TheKingOfChaos/RF-Power-Monitor/docs/diagrams/README.md

# Diagrams

Excalidraw diagrams of the project. Each `.excalidraw` file opens and edits at [excalidraw.com](https://excalidraw.com) (Open, or drag the file in) or in VS Code with the Excalidraw extension; the `.svg` next to it is the exported picture used in the docs.

| Diagram | Shows | Used in |
|---|---|---|
| [system-overview](system-overview.svg) | Mains side, board (Pico, W5500, TMP1075, flash, button, LED), PC, and the network: DHCP (options 7, 42, 224, 225), browser, SNMP manager, trap receiver, NTP, syslog and update site | README, setup manual |
| [firmware-architecture](firmware-architecture.svg) | Each part of `src/` over the `lib/` libraries it uses (pure and hardware layers), the boot program, the Arduino-Pico core | DEVELOPMENT.md, project structure |
| [snmp-request-flow](snmp-request-flow.svg) | Size check, rate limiter, parsing, version and community checks, MIB (250 objects + address rows), response, auth-failure trap, access log and syslog | MIB.md |
| [mains-flow](mains-flow.svg) | GPIO27 sampling and debouncing on core 1, seqlock, status/SNMP/traps/syslog on core 0, LibreNMS and the syslog server; the reset button path | REFERENCE.md, mains monitoring; user manual |
| [settings-storage](settings-storage.svg) | Saving to the A/B slots and choosing a copy at boot; the update and time/syslog files use the same scheme | REFERENCE.md, settings storage |
| [test-layers](test-layers.svg) | Native, sanitizer, net-snmp, on-device, HIL (incl. NTP, syslog, DHCPv6), mains and LibreNMS tests, and what CI runs | docs/TESTING.md |
| [web-request-flow](web-request-flow.svg) | Web page: request reading, login and lockout, sessions, CSRF check, validation, save (incl. /timelog, /updateserver, /firmware/switch) | user manual, web page |
| [network-addresses](network-addresses.svg) | Where the IPv4 and IPv6 addresses, the IPv6 gateway, the trap destination, the NTP server and the syslog server come from | REFERENCE.md, IPv6 |
| [update-site-flow](update-site-flow.svg) | Check-ins with the update site, the reply MAC, a failed check-in (syslog, SNMP updateSite), the download, the checks before writing, trial and reporting | user manual, update-server/README.md |
| [firmware-update-boot](firmware-update-boot.svg) | Flash layout (boot program, boot record, slots A and B, LittleFS, EEPROM) and the boot decision: signature check, trial, crash limit, fallback, rollback, nothing bootable | REFERENCE.md, firmware update; user manual, updating |
| [time-syslog-flow](time-syslog-flow.svg) | NTP server to the clock; events through the throttle and the queue of 16, waiting for network, server and time, dated or undated, RFC 5424 to the syslog server | REFERENCE.md, time and syslog |
| [librenms-integration](librenms-integration.svg) | SNMP polls, traps through snmptrapd, syslog through the syslog-ng sidecar, what LibreNMS shows, alert rules | LIBRENMS.md |
| [bench-setup](bench-setup.svg) | `tools/bench_provision.py`: signature check, BOOTSEL flash, benchinfo, checks, pwlock, update server default, label and log; `--no-flash`, `--reprint` | SETUP_MANUAL.md, bench setup |
| [cores-watchdog](cores-watchdog.svg) | What core 0 and core 1 run, their stacks, the shared snapshot, flag and heartbeat, the 8 s watchdog and what a restart does | REFERENCE.md, watchdog |

## Changing a diagram

The `.excalidraw` files are generated by [make_diagrams.py](make_diagrams.py), which places the boxes and binds the arrows to them. Either edit the script and regenerate, or edit a file in Excalidraw; regenerating overwrites hand edits, so pick one.

Layout rules, checked when the script runs (it prints a warning for each break): arrows run straight or in orthogonal steps through the gaps between boxes, never along a box edge or zone border and never through a box or a text; no segment is shorter than 30 px; an arrow's label is free text beside its segment (above a horizontal one, right of a vertical one), grouped with the arrow, so no line or arrowhead crosses it.

```powershell
python docs/diagrams/make_diagrams.py                 # .excalidraw files
wsl -d Ubuntu-24.04 -- bash docs/diagrams/render_svg.sh   # .svg files (needs Docker and internet)
# Without Docker inside WSL: run the docker command from render_svg.sh on Windows, with docs/diagrams mounted at /diagrams
```

`render_svg.sh` runs [render.mjs](render.mjs) in the Playwright Docker image: headless Chromium loads Excalidraw 0.17.6 and exports each file with Excalidraw's own `exportToSvg`, then the hand-drawn Virgil font is embedded so the SVGs look the same on GitHub. After editing a diagram in Excalidraw, run only `render_svg.sh`, or export the SVG from Excalidraw yourself (Export image → SVG, with "Embed scene" off).
