TheKingOfChaos/RF-Power-Monitor/hardware/rf-power-monitor-rev2/design/brief.md

# Brief (2026-11-02)

User, exact words:
> can we build a rev2 of the board where all of wiznet module exept the poe module are on the carry board

Answers to the intake questions:
- Tooling: Adom AI Flow
- Layers: "2 if you can and you are allow to change the board design and size"
- Outline: free outline, new case later
- Assembly: JLCPCB PCBA

Rev1: hardware/pico-poe-mains-carrier (carrier for the WIZnet W5500-EVB-Pico-PoE module).
