TheKingOfChaos/RF-Power-Monitor/docs/LIBRENMS.md

# LibreNMS

The device works in LibreNMS as a plain SNMP device out of the box: it answers SNMPv2c, has the system group and the standard IF-MIB, so LibreNMS discovers it, graphs the Ethernet port's traffic and shows its uptime. To also get the mains power state and the CPU and ambient temperature as sensors, and the device recognised as an RF-Power-Monitor with the RF logo, add the definitions in [librenms/](../librenms/) to your LibreNMS installation.

> **Status:** tested with LibreNMS 26.9.1 (Docker, [librenms/test/compose.yml](../librenms/test/compose.yml)) against the real device running firmware 1.0.1: OS, version and hardware detected, all three sensors created with the right values and limits, the port polled with traffic rates, and a mains trap logged. The RF logo as device icon and device page logo was checked with LibreNMS (Docker, `latest`) on 2026-10-31 against the device. The definition files also validate against LibreNMS's JSON schemas. Re-checked on 2026-11-01 after the rename (3.0.0 definitions, Pico with the renamed firmware): detected as RF-Power-Monitor (`rfpowermonitor`) with version and hardware, all five sensors, the LLDP neighbour, an authenticationFailure trap in the event log, and snmptrapd resolving the `RF-POWER-MONITOR-MIB` trap names. Re-checked on 2026-11-07 with firmware 3.6.0: the two update-site sensors discovered (warning limit 60 minutes), and the device's syslog messages stored under the device through the syslog-ng sidecar on UDP 5140.

## What you get

How LibreNMS sees the device: SNMP polls every 5 minutes, traps through the snmptrapd sidecar, syslog through the syslog-ng sidecar, sensors and alert rules

| In LibreNMS | From |
|---|---|
| OS "RF-Power-Monitor", type power, version (e.g. `3.6.0`) and hardware (`RP2040, W5500`) | sysObjectID `1.3.6.1.4.1.63050`, sysDescr |
| Port `eth0` with traffic, packets, speed and status | IF-MIB (64-bit counters over v2c) |
| State sensor "Mains power": present (OK) / lost (warning) | `mainsPowerStatus` |
| State sensor "Mains lost over 60 s": none (OK) / lostTooLong (critical) | `mainsPowerAlarm` (firmware after 2.5.1) |
| Temperature sensor "CPU (RP2040 die)", warning at 60 °C, critical at 70 °C, low limit −20 °C | `cpuTemperature` / 10 |
| Temperature sensor "Ambient (TMP1075)", warning at 40 °C, critical at 50 °C, low limit −20 °C; only with the carrier board | `ambientTemperature` / 10 |
| Count sensor "Mains power changes since boot" | `mainsPowerChanges` |
| State sensor "Firmware": normal (OK, fwState kept) / trial (warning) | `fwState` (`fwUpdate` group, `63050.7`, firmware 3.3.0) |
| State sensor "Firmware last update": none, installed (OK); rolled back or fallback (critical, alerts) | `fwLastResult` (3.3.0) |
| State sensor "Update site check-in": off, never, ok, failed (shown only, no alert) | `updCheckinResult` (`updateSite` group, `63050.8`, firmware 3.6.0) |
| Count sensor "Minutes since update site check-in", warning above 60 | `updMinutesSinceGood` (3.6.0) |
| Uptime, reboot detection | sysUpTime |
| Neighbours tab: the switch and port the device is plugged into | LLDP-MIB `lldpRemTable` (firmware 2.7.0) |
| Location and contact on the device page (and the map, once the location has coordinates) | sysLocation, sysContact: set on the device's web page or menu option 4 |
| Processors: "RP2040 core 0 (network, SNMP)" and "RP2040 core 1 (mains input)", load per core | HOST-RESOURCES-MIB `hrProcessorLoad` (firmware 3.1.0) |
| Memory "RAM" (256 KB) | HOST-RESOURCES-MIB `hrStorageTable`, hrStorageRam (3.1.0) |
| Storage "LittleFS (settings)" (256 KB) | HOST-RESOURCES-MIB `hrStorageTable`, hrStorageFlashMemory (3.1.0) |
| IPv4 and IPv6 addresses on `eth0` | IP-MIB `ipAddrTable`, `ipAddressTable` (3.1.0) |
| Inventory: model, hardware and firmware revision, manufacturer, serial number; the serial also on the Overview | ENTITY-MIB `entPhysicalTable` (3.1.0), `serial` in the discovery definition |
| Netstats graphs: IP, ICMP, TCP, UDP, SNMP | MIB-II ip/icmp/tcp/udp groups (lwIP's counters), SNMPv2-MIB snmp group (3.1.0) |
| Overview graphs: CPU and Memory next to traffic, mains and temperature | `over:` in the detection definition |
| The device's syslog messages under Logs → Syslog | Syslog from the device (firmware 3.6.0, see [Syslog](#syslog)) |

The temperature sensors set their low limit explicitly to −20 °C (the RP2040's minimum rating): without it LibreNMS sets a low limit 10 °C below the first reading (29.4 °C in the test), which alarms as soon as the room cools down. The CPU sensor keeps the index `boardTemperature.0` from before the MIB object was renamed `cpuTemperature`, so an existing installation keeps its graph after updating the definitions; replace the MIB file in LibreNMS together with the YAML files. The ambient limits suit a room with equipment; change them per device in LibreNMS if the box sits somewhere warmer.

**Alerts for outages longer than 60 s.** A mains loss turns "Mains power" yellow (warning, generic state 1), which no rule in LibreNMS's collection alerts on, so short outages stay out of the alert log. Once mains has been gone for 60 s without a break, the device sets `mainsPowerAlarm` and "Mains lost over 60 s" turns critical (generic state 2). To be alerted, add the "State Sensor Critical" rule from LibreNMS's rule collection (Alerts → Alert Rules → Create rule from collection); a fresh installation has no alert rules. The alert recovers when mains returns.

The 60 s is decided on the device, not with the rule's delay: LibreNMS creates the alert, and its entry in the alert log, at the poll that sees the sensor critical, and the rule's delay only holds back notifications (e-mail and other transports). It also only checks rules when it polls, and the device's mains state alone does not say how long mains has been gone.

Polling runs every 5 minutes by default, so without traps the alert comes at the first poll after the 60 s; a short outage between two polls still shows up as a step in "Mains power changes". For the alert about 60 s after mains goes, send the device's traps to LibreNMS's snmptrapd and let a mains trap poll the device (below).

Tested on 2026-11-01 with LibreNMS (Docker, `latest`) and the firmware with `mainsPowerAlarm`, cutting mains with a smart outlet: a 33 s outage logged mainsPowerLost and mainsPowerRestored and no alert; outages of 76 s and 95 s each logged mainsPowerLostTooLong 60 s after the loss, the alert opened 2 s after that trap and recovered 2 s after mains returned.

**Updating from an older definition:** copy the YAML files and the MIB again, rediscover the device (device → Settings → Rediscover, or `./lnms device:discover <device ip> -m sensors`) so the new sensor is created and "lost" becomes a warning, and restart snmptrapd so it knows the new trap's name. Until then it logs the trap by its parent's name, `RF-UPS-MONITOR-MIB::rfUpsMonitorNotifications.3` with a 2.5 MIB (the module's name before 3.0.0).

**Updating to 3.0.0 (the project renamed RF-Power-Monitor):** the definition is now `rfpowermonitor` and the MIB `RF-POWER-MONITOR-MIB`. Remove the old files first, or two definitions match the device and detection may keep the old one:

```bash
cd /opt/librenms
rm resources/definitions/os_detection/rfupsmonitor.yaml resources/definitions/os_discovery/rfupsmonitor.yaml
rm -r mibs/rfupsmonitor
rm html/images/os/rfupsmonitor.svg html/images/logos/rfupsmonitor.svg
```

then copy the new files as under Install, rediscover the device (it becomes OS RF-Power-Monitor; its sensors are created again, so their history starts over) and restart snmptrapd so it loads the new MIB. Until the restart it names the traps `RF-UPS-MONITOR-MIB::...`; the trap script below accepts both names.

LibreNMS reads CPU, memory, storage, addresses and inventory through its generic modules (`processors`, `mempools`, `storage`, `ipv4-addresses`, `ipv6-addresses`, `entity-physical`, `netstats`), as it does for any device; only the overview graphs and the serial come from our definition files. They appear after the next discovery (every 6 hours) or at once with `./lnms device:discover <device>`.

The location follows sysLocation at every poll. Clearing it on the device does not clear it in LibreNMS (LibreNMS keeps the last one); set or remove it on the device's page in LibreNMS (Edit → Override sysLocation) if needed.

Checked 2026-11-02 with LibreNMS 26.10.2 (Docker) against firmware 3.1.0: both processors (0-1 % idle), memory RAM 52 %, storage LittleFS 32 of 256 KB, ipv4 10.132.0.58/22, ipv6 fe80:: and the ULA address (/64, origin linklayer), the inventory entry with serial, manufacturer and revisions, the serial on the device, RRD files for netstats ip/icmp/tcp/udp/snmp, and a location set on the device shown after the next poll. Hardware and version still come from sysDescr.

## Install

On the LibreNMS server, as the `librenms` user, with LibreNMS in `/opt/librenms`:

```bash
cd /opt/librenms
# OS detection and discovery
cp <this repo>/librenms/os_detection/rfpowermonitor.yaml resources/definitions/os_detection/
cp <this repo>/librenms/os_discovery/rfpowermonitor.yaml resources/definitions/os_discovery/
# MIB, in the directory named by mib_dir in the detection file
mkdir -p mibs/rfpowermonitor
cp <this repo>/mibs/RF-POWER-MONITOR-MIB.txt mibs/rfpowermonitor/RF-POWER-MONITOR-MIB
# RF logo: icon in device lists, logo on the device page
cp <this repo>/librenms/images/os/rfpowermonitor.svg html/images/os/
cp <this repo>/librenms/images/logos/rfpowermonitor.svg html/images/logos/
# Optional: "Switch" box on the device's Overview page (plugin, see Switch and port below)
cp -r <this repo>/librenms/plugins/RFPowerMonitor app/Plugins/
```

Then add the device with SNMP v2c and its community (menu option 4 on the device; change it from `public`):

```bash
./lnms device:add --v2c -c <community> <device ip>
```

or in the web interface: Devices → Add Device, SNMP version v2c. Use v2c, not v1: the 64-bit interface counters exist only in v2c.

If the device was added before the files were copied, rediscover it (device → Settings → Rediscover, or `./discovery.php -h <device ip>`) so it is detected as RF-Power-Monitor.

LibreNMS's daily update and `validate.php` may complain about these extra files, since they are not part of the LibreNMS repository. Keep a copy, and copy them again if an update removes them.

### IPv6

The device answers SNMP over IPv6 too (see [IPv6](REFERENCE.md#ipv6) in the reference). To poll it over IPv6, add it with the IPv6 transport:

```bash
./lnms device:add --v2c -c <community> -t udp6 <device IPv6 address>
```

or choose transport `udp6` in Devices → Add Device. Checked with LibreNMS 26.9.1 in the Docker setup below: added with `-t udp6`, the device was detected as the OS (then named RF-UPS-Monitor, before the 3.0.0 rename; not repeated since), and discovery and polling over IPv6 give the mains state, change counter, temperature and the `eth0` port. If LibreNMS already has the device by its IPv4 address, it refuses a second entry with the same sysName (`--force` skips that check). A static IPv6 address (serial menu option 9) gives the device an address that does not change with the router's prefix, which suits a monitoring system.

### Switch and port (LLDP)

Since 2.7.0 the device answers the standard LLDP-MIB (`lldpLocPortTable`, `lldpRemTable`, see [MIB.md](MIB.md)) with the switch it hears over LLDP. LibreNMS reads it in its `discovery-protocols` discovery module, as it does for every device, so the device's **Neighbours** tab (and the links on the network map) show the switch and port, even when the switch itself is not in LibreNMS. No LibreNMS change is needed. Run discovery once to see it at once, otherwise it comes with the next discovery (every 6 hours):

```bash
./lnms device:discover <device> -m discovery-protocols
```

With the plugin in `librenms/plugins/RFPowerMonitor` (copied to `app/Plugins/`, see Install) the device's **Overview** page also has a **Switch** box under the system box: the switch's name, its port, its system description and the device port LLDP was seen on, or "No switch seen" when discovery found none. It shows the same links as the Neighbours tab, so it changes at the same time, with each discovery. LibreNMS turns a newly copied plugin on by itself (Overview → Plugins → Plugin Admin lists it), and the box only appears on RF-Power-Monitor devices. Checked 2026-11-02 with LibreNMS 26.10.2.

Junos sends its port as a number (its ifIndex, e.g. `523`) and the name only as description; LibreNMS labels the remote port with the port ID, so the device serves the name (`ge-0/0/9.0`) instead, as on its status screen.

LibreNMS by default tries to add every LLDP/CDP neighbour it learns as a new device (`autodiscovery.xdp`). If you only want to see the switch on the device's page, turn that off:

```bash
./lnms config:set autodiscovery.xdp false
```

Checked 2026-11-01 with LibreNMS 26.9.1 in the Docker setup below (`autodiscovery.xdp` off): discovery logs `LLDP: 1 neighbors`, and the device's link is local port `eth0` → `r169`, port `ge-0/0/9.0` (a Juniper EX2200-C that is not in LibreNMS); no device was added.

## Traps

Set the device's trap destination (menu option 4) to the LibreNMS server and the trap version to `2c` (or enter `dhcp` and let the DHCP server hand out the LibreNMS address in option 224, see [MIB.md](MIB.md#trap-destination-from-dhcp)), and set up snmptrapd on the server as described in the LibreNMS documentation (SNMP Trap Handler). LibreNMS has no trap handler for the RF-POWER-MONITOR-MIB notifications, so it logs them as unhandled traps: the device's event log shows an entry of type `trap` with the message `RF-POWER-MONITOR-MIB::mainsPowerLost` (or `...Restored`, `...LostTooLong`), checked with LibreNMS 26.9.1. The sensors change on the next poll.

LibreNMS finds the device for a trap by the address the trap came from. If something between the device and snmptrapd rewrites that address (NAT, such as Docker Desktop's port forwarding), LibreNMS logs "Could not find device for trap" in snmptrapd's output and drops the trap; the Docker setup below works around that.

### Firmware update (3.3.0)

The `fwUpdate` group (`63050.7`, see [MIB.md](MIB.md)) describes the two firmware slots, and the discovery definition turns two of its objects into state sensors, which appear after the next discovery of a device on 3.3.0 or later (copy the YAML files and the MIB again first):

| Sensor | Object | States |
|---|---|---|
| Firmware | `fwState` (`63050.7.4`) | normal (OK: fwState `kept(1)`, the firmware is confirmed), trial (warning: a new firmware that has not answered a valid request yet) |
| Firmware last update | `fwLastResult` (`63050.7.5`) | none, installed (OK); rolledBackCrash, rolledBackUnreachable, fallbackCrash (critical: the *State Sensor Critical* rule alerts until the next successful update) |

The running slot (`fwRunningSlot`) and each slot's version (`fwSlotAVersion`, `fwSlotBVersion`) are readable by any SNMP manager but are not sensors.

Two traps report the outcome: `firmwareUpdateKept` (`63050.0.4`, v1 specific trap 4, once when an update is confirmed) and `firmwareRolledBack` (`63050.0.5`, v1 specific trap 5, after a rollback or a fallback), both with fwRunningSlot, fwSlotAVersion, fwSlotBVersion and fwLastResult. LibreNMS logs them as unhandled traps like the mains traps; the Docker setup's trap script polls the device after them, so the *Firmware* sensors change within seconds (`State sensor Firmware ...` in the event log).

### Update site check-ins (3.6.0)

The `updateSite` group (`63050.8`, see [MIB.md](MIB.md)) says whether the device reaches its update site (serial menu option 10). The discovery definition makes two sensors of it, after the next discovery of a device on 3.6.0 or later (copy the YAML files and the MIB again first):

| Sensor | Object | States or limits |
|---|---|---|
| Update site check-in | `updCheckinResult` (`63050.8.1`) | off (no URL or key; unknown), never, ok, failed. Shown only: one failed check-in is retried after 5 minutes, so it does not alert |
| Minutes since update site check-in | `updMinutesSinceGood` (`63050.8.2`) | warning above 60 minutes (check-ins run every 30 minutes, a failed one is retried after 5) |

`updFailedInRow` (`63050.8.3`, check-ins failed since the last good one) is readable by any SNMP manager but is not a sensor. A device without an update site reads 0 minutes and *off*, so it never warns.

Two things that cost time when you change anything here:

- **snmptrapd reads MIBs only when it starts.** After you copy a changed `RF-POWER-MONITOR-MIB`, restart snmptrapd, or it keeps naming the new traps by their parent (`rfPowerMonitorNotifications.4`). In the Docker setup: `docker restart lnms-test-snmptrapd-1`.
- **`.php` files must keep LF line endings.** `.gitattributes` has `*.php text eol=lf`. With CRLF the handler `librenms/test/snmptrap-agent-addr.php` fails in the container with `/usr/bin/env: 'php\r': No such file or directory` (the `\r` is the carriage return), and no trap reaches LibreNMS. After a checkout on Windows with an older Git setting, run `git add --renormalize .` or check the file with `file`.

## Syslog

From firmware 3.6.0 the device sends its events to a syslog server (serial menu option 11, the web page's card *Time and syslog*, or DHCP option 7; see the reference's [Time and syslog](REFERENCE.md#time-and-syslog) section): mains lost and restored, the 60 s alarm, restarts, firmware updates, web logins, rejected SNMP requests, settings changes, link, address and switch changes, and update site check-ins that fail. They are RFC 5424 messages over UDP (facility daemon, APP-NAME `rfpower`, the device's hostname as HOSTNAME, UTC time with milliseconds). LibreNMS shows them on the device's **Logs → Syslog** tab and under Overview → Syslog.

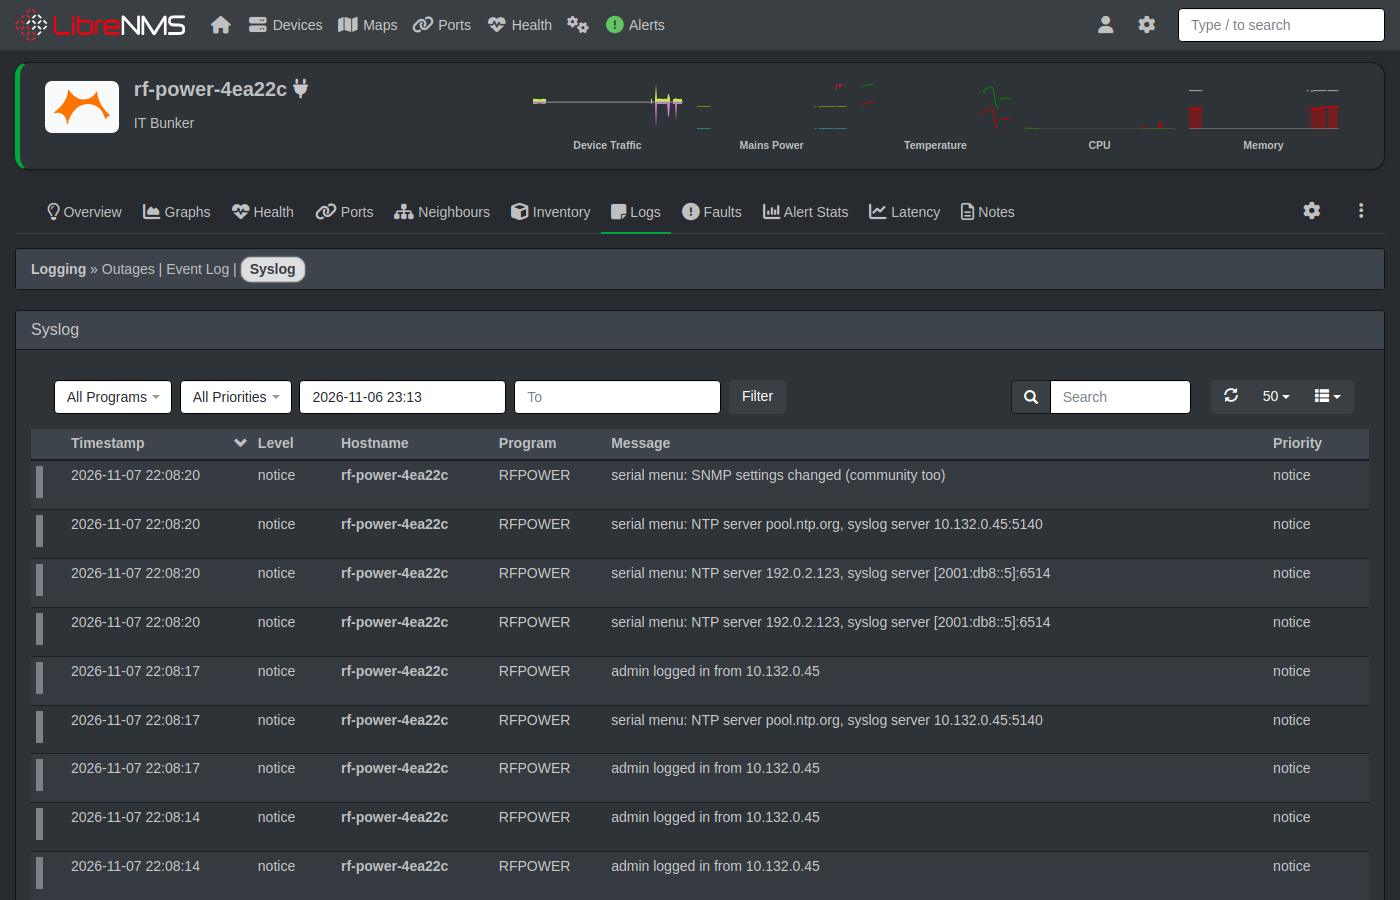
[picture p8: docs/images/librenms/device-syslog.png]
The device's syslog tab in LibreNMS


On a LibreNMS server, set up syslog as described in the LibreNMS documentation (Syslog support, syslog-ng or rsyslog), then:

- turn syslog on: `./lnms config:set enable_syslog true`; LibreNMS stores nothing without it;
- make the receiver parse RFC 5424: in syslog-ng a source with `flags(syslog-protocol)` (as in [librenms/test/syslog-ng-rfc5424.conf](../librenms/test/syslog-ng-rfc5424.conf)). A source for the older RFC 3164 format reads the version digit at the start of the message as the program name and loses the hostname;
- set the device's syslog server to the LibreNMS server, with the port of that source (`<server>:5140` in the Docker setup below; port 514 is used when none is given).

LibreNMS finds the device for a message by the message's host (the HOSTNAME, or the sender's address, depending on the receiver's setup), matched against its devices' hostnames, sysNames and addresses. The device sends its hostname, which is also its sysName.

## Trying it in Docker

[librenms/test/compose.yml](../librenms/test/compose.yml) starts a throw-away LibreNMS (MariaDB, Redis, LibreNMS, poller, trap receiver, syslog receiver) with the definition files, the MIB and the logos mounted in, on http://localhost:8070:

```bash
cd librenms/test
docker compose up -d                     # wait about a minute for the database setup
docker compose exec -u librenms librenms ./lnms user:add -p <password> -r admin admin
docker compose exec -u librenms librenms ./lnms device:add --v2c -c public <device ip>
docker compose exec -u librenms librenms ./lnms device:discover <device ip>
docker compose exec -u librenms librenms ./lnms device:poll <device ip>
docker compose down -v                   # remove everything again
```

The poller polls every 5 minutes; traffic rates appear after the second poll. The device gets the RF icon at its first poll (LibreNMS stores the icon when it polls), so after updating the definitions on an existing installation the icon changes at the next poll.

**Screenshots for the manuals.** `librenms/test/screenshots.ps1` retakes `docs/images/librenms/device-overview.png`, `device-eventlog.png`, `device-neighbours.png`, `device-inventory.png` and `device-syslog.png` from this LibreNMS: it logs in with the account in `secret/librenms.md` (gitignored) inside the Playwright Docker image and replaces the contact address on the page by `ops@example.com`. Docker Desktop must be running. Let LibreNMS poll the device for a few days first, so the graphs have data. The web page screenshots in `docs/images/web` come from `docs/images/web/screenshots.ps1 -Ip <device>` (with `RFPOWER_WEB_PASSWORD` set), which replaces the addresses, MAC, contact, location and community by documentation values.

### Traps in Docker

The `snmptrapd` container receives traps on UDP 162 of the PC. Set the device's trap destination to the PC's address (menu option 4); both trap versions work. Docker Desktop replaces the sender's address with its own (172.18.0.1), so LibreNMS alone could not find the device ("Could not find device for trap"). The device's traps also carry its address, v1 in agent-addr and v2c (from firmware 2.5.1) in `snmpTrapAddress.0`, which snmptrapd shows for both; [librenms/test/snmptrap-agent-addr.php](../librenms/test/snmptrap-agent-addr.php), mounted over LibreNMS's `snmptrap.php`, puts that address back before LibreNMS handles the trap. Without NAT in between, on a normal LibreNMS server, the script is not needed. Only traps with the community in `TRAP_COMMUNITY` (default `public`) are accepted, e.g. `TRAP_COMMUNITY=mycommunity docker compose up -d`.

**Alerts from traps:** LibreNMS only logs these traps; alerts come from the sensors. After a mainsPowerLost, mainsPowerRestored or mainsPowerLostTooLong trap, the same script polls the device's sensors, which runs its alert rules, so "State Sensor Critical" opens about 60 s after mains goes (at the mainsPowerLostTooLong trap) and recovers when it returns, within seconds instead of at the next 5-minute poll. It also recognises the traps under the names snmptrapd gives them while it still has an older MIB loaded: by their parent (`rfPowerMonitorNotifications.3`, or `rfUpsMonitorNotifications.3`), and under the module name before 3.0.0, `RF-UPS-MONITOR-MIB` (`librenms/test/check_trap_names.php` checks every form). On a LibreNMS server without this script the alert comes with the next poll.

With WSL in mirrored networking mode (below), a firewall in front of WSL (the Hyper-V firewall) drops traps from the network until UDP 162 is allowed, once, in an administrator PowerShell:

```powershell
New-NetFirewallHyperVRule -Name "RFPOWER-SNMP-Trap" -DisplayName "RF-Power-Monitor SNMP traps (WSL/Docker)" -Direction Inbound -VMCreatorId '{40E0AC32-46A5-438A-A0B2-2B479E8F2E90}' -Protocol UDP -LocalPorts 162 -Action Allow
```

Checked on 2026-10-31 with v2c traps: coldStart, authenticationFailure, mainsPowerLost and mainsPowerRestored were matched to the device, and the mains sensor changed 2 s after each mains trap. With v1 traps, a 30 s mains cut (Dirigera outlet) gave `RF-POWER-MONITOR-MIB::mainsPowerLost` and `...Restored` in the device's event log, and the "State Sensor Critical" alert opened 3.4 s after mains went off and recovered 3.4 s after it came back; and a wrong community an "SNMP Trap: Authentication Failure" entry. Traps a test sends from the PC itself (`snmptrap` in WSL) arrive without the firewall rule, so they do not show whether the device's traps get through.

To keep the setup running, a `compose.override.yml` next to `compose.yml` (loaded by `docker compose` on its own) can add `restart: unless-stopped` to each service and the community; `librenms/test/compose.override.yml` is gitignored for that.

### Syslog in Docker

The `syslogng` service is LibreNMS's syslog-ng sidecar (`SIDECAR_SYSLOGNG`), on UDP and TCP 514 and UDP 5140 of the PC. The image's source on 514 expects RFC 3164 and does not parse the device's RFC 5424 messages, so [librenms/test/syslog-ng-rfc5424.conf](../librenms/test/syslog-ng-rfc5424.conf), mounted into `/data/syslog-ng/`, adds an RFC 5424 source on UDP 5140. Docker Desktop replaces the sender's address with its own, as for traps, so the file also sets `keep_hostname(yes)`: LibreNMS then matches the message's HOSTNAME to the device's sysName.

```bash
cd librenms/test
docker compose up -d                     # also starts syslogng
docker compose exec -u librenms librenms ./lnms config:set enable_syslog true
docker compose restart syslogng          # the sidecar reads the setting when it starts
```

Then set the device's syslog server to the PC's address and port 5140 (menu option 11: `10.132.0.45:5140`). The messages appear on the device's Logs → Syslog tab within seconds. Restart `syslogng` again after changing `enable_syslog` or the `.conf` file. Use plain `docker compose up -d` to start it on an existing setup: `docker compose down -v` deletes LibreNMS's data.

Checked on 2026-11-07 with firmware 3.6.0: the device's messages arrived on its Logs → Syslog tab. On this PC (WSL in mirrored mode) UDP 5140 needed no firewall rule; on another PC a Hyper-V firewall rule like the one for traps (UDP 5140 instead of 162) may be needed.

### IPv6

The compose network has IPv6 (`enable_ipv6`, NATed by Docker), so the containers can poll the device over IPv6 (`./lnms device:add --v2c -c public -t udp6 <device IPv6 address>`). In WSL this needs mirrored networking (`networkingMode=mirrored` under `[wsl2]` in `%USERPROFILE%\.wslconfig`, then `wsl --shutdown`); with the default NAT networking WSL has no IPv6 route to the LAN. WSL stops when no terminal uses it, and the containers do not restart on their own: run `docker compose up -d` again after that.

## Files

| File | Purpose |
|---|---|
| [librenms/os_detection/rfpowermonitor.yaml](../librenms/os_detection/rfpowermonitor.yaml) | Matches sysObjectID `.1.3.6.1.4.1.63050`; OS name, type, icon, MIB directory, overview graphs |
| [librenms/os_discovery/rfpowermonitor.yaml](../librenms/os_discovery/rfpowermonitor.yaml) | Version and hardware from sysDescr; the state, temperature and count sensors |
| [librenms/plugins/RFPowerMonitor/](../librenms/plugins/RFPowerMonitor/) | Optional plugin: the Switch box (LLDP neighbour) on the device's Overview page |
| [mibs/RF-POWER-MONITOR-MIB.txt](../mibs/RF-POWER-MONITOR-MIB.txt) | Lets LibreNMS resolve the `RF-POWER-MONITOR-MIB::` names |
| [librenms/test/snmptrap-agent-addr.php](../librenms/test/snmptrap-agent-addr.php) | Docker setup only: matches traps to the device by the address in them (v1 agent-addr, v2c snmpTrapAddress.0), which Docker's port forwarding would otherwise hide, and polls the sensors after a mains trap so the alert follows within seconds |
| [librenms/test/syslog-ng-rfc5424.conf](../librenms/test/syslog-ng-rfc5424.conf) | Docker setup only: an RFC 5424 syslog source on UDP 5140 for the device's messages, keeping the HOSTNAME from the message, since Docker's port forwarding hides the sender's address |
| [librenms/images/os/rfpowermonitor.svg](../librenms/images/os/rfpowermonitor.svg), [librenms/images/logos/rfpowermonitor.svg](../librenms/images/logos/rfpowermonitor.svg) | The RF logo (from [logo/](../logo/)): square icon for device lists, wider logo for the device page. Named by `icon:` in the detection file; without them LibreNMS shows the generic icon |

If you change the MIB, keep the object names used in the discovery file. The temperature sensors' divisor (10) matches the MIB's units of 0.1 °C.
