TheKingOfChaos/RF-Power-Monitor/docs/superpowers/plans/2026-11-01-lldp-mib.md

# LLDP-MIB Implementation Plan

> **For agentic workers:** REQUIRED SUB-SKILL: Use superpowers:subagent-driven-development (recommended) or superpowers:executing-plans to implement this plan task-by-task. Steps use checkbox (`- [ ]`) syntax for tracking.

**Goal:** The device answers LLDP-MIB `lldpLocPortTable` and `lldpRemTable` over SNMP, so LibreNMS shows its switch and port (r169, ge-0/0/9.0) on the device's Neighbours page.

**Architecture:** `lib/lldp` keeps the raw values the tables need next to today's display text. `lib/snmp_agent` gets an `SnmpLldpState` (reached by pointer from `SnmpDeviceState`, so no large copy lands on core 0's stack) and 12 fixed-OID entries; rows without a neighbour report noSuchInstance like ambientTemperature does. `src/` copies the neighbour into a static `SnmpLldpState` per request.

**Tech Stack:** C++ (Arduino-Pico 5.4.3), Unity native tests, net-snmp tools in WSL, Python HIL, LibreNMS in Docker.

**Spec:** docs/superpowers/specs/2026-11-01-lldp-mib-design.md

## Global Constraints

- lldpLocPortTable `1.0.8802.1.1.2.1.3.7.1`, row 1: `.2.1` subtype 3, `.3.1` 6 MAC bytes, `.4.1` "W5500 10/100 Ethernet"; always present.
- lldpRemTable `1.0.8802.1.1.2.1.4.1.1`, instance `.0.1.1`, columns 4-12 (chassis subtype, chassis id raw, port subtype, port id, port desc, sys name, sys desc, caps supported, caps enabled as 2-byte OCTET STRING); present only with a neighbour.
- Port ID rule: subtype 7 + non-empty Port Description → serve subtype 5 and the description; otherwise the raw subtype and bytes.
- Caps: IDs 64 bytes, System Description 128 bytes, raw; text fields as today.
- v1 and v2c see the same objects; absent row: v1 noSuchName, v2c noSuchInstance; GetNext/GetBulk skip it.
- `1.0.8802...` sorts before `1.3.6.1...`; mib-2 and enterprise walks unchanged.
- No large struct on core 0's stack: `SnmpLldpState` is static and reached by pointer.
- LibreNMS: only change `autodiscovery.xdp` to false (run as the `librenms` user). Never `docker compose down -v`.
- Version 2.7.0; docs: MIB.md, README, LIBRENMS.md, CHANGELOG, TODO, TESTING.md. Device settings restored after HIL (community rfit).

## Review Focus

1. No neighbour: a walk of `1.0.8802.1.1.2` returns only the 3 lldpLocPortTable objects and then continues into system (v1 and v2c, GetBulk too) — Task 2 `test_walk_without_neighbour_skips_rem_table`.
2. Get on a lldpRemTable column with another index (`.9.0.1.2`): v2c noSuchInstance, not noSuchObject — Task 2 `test_rem_column_other_index_is_no_such_instance` (needs `indexArcs`).
3. A Chassis or Port ID longer than 64 bytes, a 255-byte System Description: cut, not overrun — Task 1 `test_parse_keeps_raw_ids_cut_to_64` / `test_parse_cuts_sys_descr_to_128`.
4. Subtype 7 Port ID with no description: raw "523" is served, not an empty string — Task 1 `test_snmp_port_id_without_description_is_raw`.
5. The neighbour changes or expires between captureState() and the response: the response is built from the static copy taken under the lock, never from the live table — Task 4 code review (copy in `lldpServiceSnmpState`, one copy per request).

---

### Task 1: Raw neighbour values in `lib/lldp`

**Files:** Modify `lib/lldp/include/lldp.h`, `lib/lldp/src/lldp.cpp`; Test `test/native/test_lldp/test_main.cpp`

**Interfaces:**
- Produces (added to `LldpNeighbour`):
  ```cpp
  static const size_t LLDP_ID_MAX = 64;
  static const size_t LLDP_SYS_DESCR_MAX = 128;
  uint8_t chassisIdSubtype;
  uint8_t chassisIdRaw[LLDP_ID_MAX]; uint8_t chassisIdLen;
  uint8_t portIdRaw[LLDP_ID_MAX];    uint8_t portIdLen;
  char sysDescr[LLDP_SYS_DESCR_MAX + 1];   // sanitised like the other text
  uint16_t capsSupported, capsEnabled;     // 0 if not sent
  /// Port ID as served in lldpRemPortId (rule in Global Constraints)
  void lldpSnmpPortId(const LldpNeighbour& n, uint8_t& subtype, const uint8_t*& data, size_t& len);
  ```
- [ ] **Step 1: Tests:** `test_parse_keeps_raw_ids` (EX2200 frame: chassisIdSubtype 4, chassisIdRaw = f8 c0 01 c7 90 c0, len 6; portIdRaw "523", len 3); `test_parse_reads_sys_descr_and_caps` (EX2200: sysDescr starts "Juniper Networks, Inc. ex2200-c-12p-2g", caps 0x0014/0x0014; own frame: 0x0080/0x0080); `test_parse_keeps_raw_ids_cut_to_64` (a 255-byte chassis id text TLV → len 64); `test_parse_cuts_sys_descr_to_128`; `test_snmp_port_id_uses_description_for_local_port_id` (EX2200 → subtype 5, "ge-0/0/9.0"); `test_snmp_port_id_without_description_is_raw` (subtype 7, no descr → 7, "523"); `test_snmp_port_id_mac_is_raw` (own frame → 3, 6 MAC bytes).
- [ ] **Step 2: Run** `pio test -e native -f native/test_lldp` — compile FAIL.
- [ ] **Step 3: Implement.** Caps TLV (type 7) only when its length is 4; otherwise ignore it.
- [ ] **Step 4: Run** — PASS; sanitizers clean (`sanitize.sh`). Mutation: drop the 64 cap, `test_parse_keeps_raw_ids_cut_to_64` fails.
- [ ] **Step 5: Commit** `lldp: keep raw IDs, system description and capabilities`.

### Task 2: LLDP-MIB objects in `lib/snmp_agent`

**Files:** Modify `lib/snmp_agent/include/snmp_mib.h`, `lib/snmp_agent/src/snmp_mib.cpp`; Test `test/native/test_snmp_agent/test_main.cpp`

**Interfaces:**
- Produces:
  ```cpp
  struct SnmpLldpState {           // filled by the firmware, static
      uint8_t localMac[6];
      bool present;                // a neighbour is held
      LldpNeighbour neighbour;     // from lib/lldp (snmp_agent now depends on lldp)
  };
  // SnmpDeviceState gains:
  const SnmpLldpState* lldp;       // nullptr: no LLDP object has an instance
  // MibEntry gains (default 1, so existing initialisers stay):
  uint8_t indexArcs = 1;           // arcs of the instance index (3 for lldpRemTable)
  ```
  `lldp == nullptr` (host tools, old callers): lldpLocPortTable and lldpRemTable both absent.
- [ ] **Step 1: Tests** (v1 and v2c each where noted):
  - `test_lldp_loc_port_table` — `.3.7.1.2.1` = 3, `.3.1` = 6 bytes MAC, `.4.1` = "W5500 10/100 Ethernet".
  - `test_lldp_rem_table_with_neighbour` — all 9 columns at `.0.1.1` with the EX2200 neighbour (parse the vector from test_lldp's bytes, copied into this suite): subtypes 4 and 5, chassis 6 raw bytes, port "ge-0/0/9.0", desc "ge-0/0/9.0", name "r169", caps `00 14`.
  - `test_walk_without_neighbour_skips_rem_table` — GetNext chain from `1.0` (v1 and v2c): loc .2.1, .3.1, .4.1, then sysDescr.0.
  - `test_walk_with_neighbour_lists_rem_columns_in_order` — 3 loc + 9 rem, then sysDescr.0; GetBulk from `1.0` with max-repetitions 14 returns the same 13 then sysDescr.
  - `test_rem_get_without_neighbour` — v1 noSuchName, v2c noSuchInstance.
  - `test_rem_column_other_index_is_no_such_instance` — v2c Get `.9.0.1.2` → noSuchInstance; Get `1.0.8802.1.1.2.1.4.1.1.13.0.1.1` → noSuchObject.
  - `test_mib2_walk_unchanged` — GetNext of `1.3.6.1.2.1` still returns sysDescr.0 first.
  - Existing `test_mib_is_sorted` must still pass.
- [ ] **Step 2: Run** `pio test -e native -f native/test_snmp_agent` — FAIL.
- [ ] **Step 3: Implement.** Entries `LLDP_LOC(n)` = `{{1,0,8802,1,1,2,1,3,7,1,n,1},12}` and `LLDP_REM(n)` = `{{1,0,8802,1,1,2,1,4,1,1,n,0,1,1},14}, getter, 3` at the start of `MIB[]`; `mibHasObject` strips `indexArcs`. Getters return `makeException(NoSuchInstance)` without a neighbour / with `lldp == nullptr`. Add `lldp` to `scripts/sanitize.sh` deps of the three snmp_agent suites.
- [ ] **Step 4: Run** all native suites + `sanitize.sh` — PASS. Fix any test that assumed `sysDescr.0` is the MIB's first entry (`mibEntry(0)`) by making it look from `1.3.6.1`.
- [ ] **Step 5: Commit** `snmp_agent: LLDP-MIB lldpLocPortTable and lldpRemTable`.

### Task 3: net-snmp check

**Files:** `test/host/host_agent.cpp` (give it an `SnmpLldpState` with the EX2200 neighbour), `scripts/host_agent_check.sh`
- [ ] **Step 1:** Add checks: `snmpwalk -v2c -On ... 1.0.8802.1.1.2` lists 12 objects (`.3.7.1.2.1` INTEGER 3 ... `.4.1.1.9.0.1.1` STRING "r169", `.4.1.1.7.0.1.1` "ge-0/0/9.0"); same with `-v1`; `snmpget` of `.4.1.1.9.0.1.2` → "No Such Instance"; default walk counts (47/6/55) unchanged. Use numeric OIDs (WSL has no LLDP-MIB).
- [ ] **Step 2: Run** `wsl -d Ubuntu -- bash scripts/host_agent_check.sh` — all checks pass. RED: run once with the host state's `lldp = nullptr` — the 12-object check fails. Restore.
- [ ] **Step 3: Commit** `host check: LLDP-MIB against net-snmp`.

### Task 4: Firmware

**Files:** `src/lldp_service.h/.cpp` (`bool lldpServiceSnmpState(SnmpLldpState& out)`: copies MAC, `present` and the neighbour under `DriverLock`), `src/snmp_service.cpp` (`static SnmpLldpState lldpState;` filled in `captureState()`, `s.lldp = &lldpState`), `test/hil/test_lldp.py`
- [ ] **Step 1: HIL test** `test_snmp_lldp_tables_name_the_switch` (opt-in `RFUPS_LLDP_SWITCH=1`, needs community from status): `snmpget -v2c` `.4.1.1.9.0.1.1` equals the switch name in `status()["switch"]`, `.4.1.1.7.0.1.1` equals its port; `-v1` gives the same; `.3.7.1.4.1` = "W5500 10/100 Ethernet". Use `snmp_tools` helpers as test_snmp.py does.
- [ ] **Step 2: Run** with current firmware — FAIL (no such object).
- [ ] **Step 3: Implement**, build (`pio run -e pico`, RAM still < 50 %), `pio test -e pico` 20/20, flash.
- [ ] **Step 4: Run** `test_lldp.py` (3 + 1) and `test_snmp.py` (community set to public for the run, restored to rfit after) — PASS. Check `test_snmp.py`'s full-walk test: if it walks from the root, update its count (now +12) and order.
- [ ] **Step 5: Commit** `LLDP-MIB in the firmware`.

### Task 5: LibreNMS

**Files:** `docs/LIBRENMS.md`
- [ ] **Step 1:** In `librenms/test`: `docker compose exec -T librenms su librenms -s /bin/sh -c 'cd /opt/librenms && php lnms config:set autodiscovery.xdp false'`; confirm with `config:get` → false.
- [ ] **Step 2:** Run discovery for the device's protocols module (`lnms device:discover 1 -m discovery-protocols` as `librenms`) and read the `links` table: one row, `remote_hostname` r169, `remote_port` ge-0/0/9.0, local port = the device's port 1. No new device added (`select count(*) from devices` still 1).
- [ ] **Step 3:** Document in LIBRENMS.md: what LibreNMS shows (Neighbours page), the autodiscovery setting and why, how to run discovery now, result with date.
- [ ] **Step 4: Commit** `LibreNMS: neighbour from the device's LLDP-MIB`.

### Task 6: Docs and version

**Files:** `include/version.h` (2.7.0), `CHANGELOG.md` (new `[Unreleased]` entries, then `[2.7.0] - 2026-11-01`), `docs/MIB.md` (LLDP-MIB objects, walk order note), `README.md` (SNMP and LLDP sections), `TODO.md` (the LLDP-MIB item ticked), `docs/TESTING.md`
- [ ] **Step 1:** Write. Full native suite, sanitizers, host check, build pass.
- [ ] **Step 2: Commit** `LLDP-MIB: docs, version 2.7.0`.
