TheKingOfChaos/RF-Power-Monitor/docs/superpowers/plans/2026-11-01-lldp.md

# LLDP Implementation Plan

> **For agentic workers:** REQUIRED SUB-SKILL: Use superpowers:subagent-driven-development (recommended) or superpowers:executing-plans to implement this plan task-by-task. Steps use checkbox (`- [ ]`) syntax for tracking.

**Goal:** The device announces itself over LLDP (so the Juniper EX2200-C lists it as a neighbour) and shows the switch and port it hears on the serial status screen and the web page.

**Architecture:** A new pure library `lib/lldp` builds LLDPDUs, parses received ones, keeps one neighbour with TTL expiry, formats the display text, and decides when to send. `src/lldp_service.cpp` runs it on core 0: received frames come from the existing input hook in `src/net_stats.cpp`, frames go out with `netStatsSendFrame()`. `lib/if_stats` stops counting LLDP as an unknown protocol.

**Tech Stack:** C++ (Arduino-Pico 5.4.3, lwIP 2.2.1, W5500 MACRAW), Unity native tests, Python HIL tests (pyserial).

**Spec:** docs/superpowers/specs/2026-11-01-lldp-design.md

## Global Constraints

- LLDPDU to 01:80:C2:00:00:0E, EtherType 0x88CC, source = device MAC; every 30 s; TTL 120 s.
- TLVs sent, in order: Chassis ID (subtype 4, MAC), Port ID (subtype 3, MAC), TTL 120, Port Description "W5500 10/100 Ethernet", System Name = `hostnameCurrent()`, System Description = sysDescr text, System Capabilities (station only: capabilities 0x0080, enabled 0x0080), Management Address IPv4 if any, Management Address IPv6 (global) if any (interface subtype 2 = ifIndex, number 1, OID length 0), End.
- Send also 1 s after the link comes up and whenever the frame content changes, at most one frame per second. No TTL 0 frame on reboot.
- One neighbour; latest wins. Forgotten on TTL expiry, TTL 0, or link down.
- Port text: Port Description when Port ID subtype is 7 and a description is present, else the Port ID. Name: System Name, else Chassis ID.
- Received text is cut to 64 bytes and every byte outside 0x20..0x7E becomes `?`; the web page HTML-escapes it.
- Nothing over ~256 bytes on core 0's stack: neighbour structs and frame buffers are static.
- LLDP always on, no settings. No LLDP-MIB, no CDP, no org TLVs sent.
- Pure code in `lib/lldp` (no Arduino includes); native builds with `-Wall -Wextra -Werror`; added to `scripts/sanitize.sh`.
- Version 2.6.0. Docs: README, CHANGELOG, TODO, docs/TESTING.md, docs/MIB.md.
- HIL: `RFUPS_LLDP_SWITCH=1` (listening), `RFUPS_LLDP_SWITCH_CONSOLE=<port>` (switch console, credentials from `secret/switch.md` or `RFUPS_LLDP_SWITCH_CREDENTIALS`, never printed). Operational commands only on the switch.

## Review Focus

1. A TLV whose length runs past the end of the frame, or a frame cut inside the TLV header: dropped, nothing read past the end (Task 2, `test_parse_rejects_tlv_past_end`, `test_parse_rejects_cut_tlv_header`).
2. Text with control bytes, `<script>`, or 255 bytes long shown on the web page: cut and escaped (Task 2 `test_parse_sanitises_and_cuts_text`, Task 5 `test_status_page_escapes_switch_name`).
3. millis() wrap while a neighbour is held: it still expires after its TTL (Task 2, `test_neighbour_expires_across_millis_wrap`).
4. The hostname changed or an address arrives right after a send: the update goes out within about 1 s, not 30 s (Task 3, `test_changed_content_sends_after_one_second`).
5. Link flaps: the old neighbour is forgotten on link down, and a fresh frame goes out 1 s after link up (Task 3 `test_link_flap_restarts_the_one_second_wait`; the link-down `clear()` call in `lldpPoll` is checked in the final review, since unplugging the cable is not automated).

---

### Task 1: LLDPDU builder

**Files:**
- Create: `lib/lldp/include/lldp.h`, `lib/lldp/src/lldp.cpp`, `lib/lldp/library.json` (copy the shape of `lib/if_stats/library.json` if one exists, else none)
- Test: `test/native/test_lldp/test_main.cpp`
- Modify: `scripts/sanitize.sh` (`[test_lldp]="lldp netconfig"`)

**Interfaces:**
- Produces:
  ```cpp
  static const uint16_t LLDP_ETHERTYPE = 0x88CC;
  static const uint16_t LLDP_TTL_S = 120;
  static const size_t LLDP_FRAME_MAX = 320;   // send buffer size
  struct LldpLocal {
      uint8_t mac[6];
      const char* sysName;    // hostname
      const char* sysDescr;
      const char* portDescr;
      bool hasIPv4; uint8_t ipv4[4];
      bool hasIPv6; uint8_t ipv6[16];
      uint16_t ttl;
  };
  /// Ethernet frame (header + LLDPDU) into out; returns its length, 0 if cap is too small or a string is over 255 bytes
  size_t lldpBuildFrame(const LldpLocal& local, uint8_t* out, size_t cap);
  ```

- [ ] **Step 1: Write the failing tests**
  - `test_build_frame_matches_expected_bytes`: MAC 02:00:00:00:00:01, sysName "rfups", sysDescr "RF", portDescr "eth", IPv4 10.0.0.5, no IPv6, TTL 120. Expected bytes written out by hand in the test as a commented array (header `01 80 c2 00 00 0e | 02 00 00 00 00 01 | 88 cc`, then `02 07 04 <mac>`, `04 07 03 <mac>`, `06 02 00 78`, `08 03 'eth'`, `0a 05 'rfups'`, `0c 02 'RF'`, `0e 04 00 80 00 80`, `10 0c 05 01 0a 00 00 05 02 00 00 00 01 00`, `00 00`), compared with `TEST_ASSERT_EQUAL_HEX8_ARRAY` and the length.
  - `test_build_frame_adds_ipv6_management_address`: with hasIPv6 a TLV `10 18 11 02 <16 bytes> 02 00 00 00 01 00` follows the IPv4 one.
  - `test_build_frame_without_addresses_has_no_management_tlv`.
  - `test_build_frame_rejects_small_buffer`: cap one byte short of the exact length → 0; exact length → length.
  - `test_build_frame_rejects_string_over_255_bytes`.

- [ ] **Step 2: Run** `pio test -e native -f native/test_lldp` — Expected: compile FAIL (no `lldp.h`).
- [ ] **Step 3: Implement** `lldpBuildFrame` (TLV header = 7-bit type, 9-bit length, big-endian).
- [ ] **Step 4: Run** the same — Expected: 5/5 PASS. Mutation check: drop the End TLV, the byte test must fail.
- [ ] **Step 5: Commit** `lldp: build LLDPDUs`.

### Task 2: Parser, neighbour table, display text

**Files:** Modify `lib/lldp/include/lldp.h`, `lib/lldp/src/lldp.cpp`; Test `test/native/test_lldp/test_main.cpp`

**Interfaces:**
- Produces:
  ```cpp
  static const size_t LLDP_TEXT_MAX = 64;
  struct LldpNeighbour {
      char chassisId[LLDP_TEXT_MAX + 1];  // MAC subtype as aa:bb:cc:dd:ee:ff, else sanitised text
      uint8_t portIdSubtype;
      char portId[LLDP_TEXT_MAX + 1];     // same rules
      char portDescr[LLDP_TEXT_MAX + 1];
      char sysName[LLDP_TEXT_MAX + 1];
      char mgmtAddr[46];                  // first IPv4 or IPv6 management address as text, empty if none
      uint16_t ttl;
  };
  enum class LldpParse : uint8_t { Ok, NotLldp, Malformed };
  LldpParse lldpParseFrame(const uint8_t* frame, size_t len, LldpNeighbour& out);
  class LldpNeighbourTable {
  public:
      void received(const LldpNeighbour& n, uint32_t nowMs);  // ttl 0 clears
      void expire(uint32_t nowMs);
      void clear();
      bool present() const;
      const LldpNeighbour& neighbour() const;
  };
  /// "<name>, port <port>" (rules in Global Constraints), or "none seen" when absent
  void lldpSwitchText(const LldpNeighbourTable& t, char* out, size_t cap);
  ```
  `formatIPv6` from `lib/netconfig` formats IPv6 addresses.

- [ ] **Step 1: Write the failing tests** (a hand-built Junos-style vector `JUNOS_STYLE` in the test: chassis subtype 4, port ID subtype 7 "513", TTL 120, port description "ge-0/0/5.0", system name "ex2200", an 802.1 org TLV (type 127) and an LLDP-MED org TLV, management address IPv4 10.132.0.2, End):
  - `test_parse_reads_junos_style_frame`: Ok; chassisId "xx:..", portIdSubtype 7, portId "513", portDescr "ge-0/0/5.0", sysName "ex2200", mgmtAddr "10.132.0.2", ttl 120.
  - `test_parse_reads_own_built_frame`: round trip of Task 1's frame with IPv6 → sysName, mgmtAddr is the IPv4 text (first one wins).
  - `test_parse_ignores_other_ethertype` → NotLldp; `test_parse_rejects_short_frame` (len 0, 13, nullptr) → NotLldp.
  - `test_parse_rejects_tlv_past_end`, `test_parse_rejects_cut_tlv_header`, `test_parse_rejects_missing_mandatory_tlv` (no TTL), `test_parse_rejects_mandatory_tlvs_out_of_order`, `test_parse_rejects_frame_without_end` → Malformed. Run the cut test for every length from 14 to `sizeof(JUNOS_STYLE)-1` (each must be Malformed and must not read past len under ASan).
  - `test_parse_sanitises_and_cuts_text`: system name of 255 bytes with `\x01` and `\xff` → 64 chars, those bytes are `?`.
  - `test_neighbour_expires_after_ttl`: received at 1000 with ttl 120 → present at 120999, gone at 121000.
  - `test_neighbour_expires_across_millis_wrap`: received at 0xFFFFF000 → present at 0xFFFFF000+119999 (wrapped), gone at +120000.
  - `test_ttl_zero_forgets_neighbour`, `test_clear_forgets_neighbour`, `test_latest_neighbour_wins`.
  - `test_switch_text_uses_port_description_for_local_port_id` → "ex2200, port ge-0/0/5.0"; `test_switch_text_uses_port_id_otherwise` (subtype 5 "ge-0/0/1") ; `test_switch_text_falls_back_to_chassis_id` (no sysName); `test_switch_text_when_none_seen` → "none seen"; `test_switch_text_cut_to_cap`.
- [ ] **Step 2: Run** `pio test -e native -f native/test_lldp` — Expected: compile FAIL.
- [ ] **Step 3: Implement.** Parse into `out` only (no stack copies of the struct). Validate the whole TLV chain before trusting it; mandatory TLVs must be the first three in order (802.1AB).
- [ ] **Step 4: Run** — all PASS; then `wsl -d Ubuntu -- bash scripts/sanitize.sh` (via `powershell.exe -NoProfile -Command`) — test_lldp clean. Mutation check: remove the length-past-end check, `test_parse_rejects_tlv_past_end` must fail.
- [ ] **Step 5: Commit** `lldp: parse LLDPDUs and keep the neighbour`.

### Task 3: When to send

**Files:** Modify `lib/lldp`; Test `test/native/test_lldp/test_main.cpp`

**Interfaces:**
- Produces:
  ```cpp
  static const uint32_t LLDP_INTERVAL_MS = 30000;
  static const uint32_t LLDP_MIN_GAP_MS = 1000;
  class LldpSchedule {
  public:
      /// True when a frame should go out now. contentChanged = the frame differs from the last one sent
      bool due(uint32_t nowMs, bool linkUp, bool contentChanged);
      void sent(uint32_t nowMs);
  };
  ```
- [ ] **Step 1: Tests:** `test_nothing_sent_while_link_down`; `test_link_up_sends_after_one_second` (link up seen at 5000: not due at 5999, due at 6000); `test_sends_every_30_s` (sent at 6000: not due at 35999, due at 36000); `test_changed_content_sends_after_one_second` (sent at 6000, changed: not due at 6999, due at 7000); `test_link_flap_restarts_the_one_second_wait`; `test_schedule_handles_millis_wrap`.
- [ ] **Step 2: Run** — compile FAIL. **Step 3: Implement.** **Step 4: Run** — PASS. **Step 5: Commit** `lldp: send schedule`.

### Task 4: LLDP is no longer an unknown protocol

**Files:** Modify `lib/if_stats/src/if_stats.cpp:29-35`, `lib/if_stats/include/if_stats.h:54-71` (comment), `test/native/test_if_stats/test_main.cpp:80-88`, `docs/MIB.md:62,84`, `README.md:157`, `test/hil/test_snmp.py:303` (comment only).

- [ ] **Step 1: Test** `test_lldp_is_delivered`: `classifyReceived` of an 0x88CC frame → `Deliver` with ipv6 true and false; and `ifCountReceived` of an LLDP multicast frame bumps `inMulticastPkts`, not `inUnknownProtos`. Remove 0x88CC from `test_other_ethertypes_are_unknown_protocols`.
- [ ] **Step 2: Run** `pio test -e native -f native/test_if_stats` — FAIL on the new test.
- [ ] **Step 3: Implement** (deliver 0x88CC). Update the doc lines listed.
- [ ] **Step 4: Run** — PASS. **Step 5: Commit** `if_stats: count LLDP as received, not unknown`.

### Task 5: Firmware: send, listen, menu, web, dump command

**Files:**
- Create: `src/lldp_service.cpp`, `src/lldp_service.h`
- Modify: `src/net_stats.cpp` (`countingInput` calls `lldpInspectFrame(payload, len)` next to `dhcp6InspectFrame`), `src/snmp_service.cpp/.h` (add `const char* snmpSysDescr()` returning SYS_DESCR), `src/main.cpp` (`lldpPoll()` after `dhcp6Poll()`), `src/cli.cpp` (status line after "Hostname", hidden `lldpdump`), `lib/web_ui/include/web_app.h` + `lib/web_ui/src/web_app.cpp` (row), `src/web_service.cpp` (fill fields), `test/native/test_web_ui/test_main.cpp`, `test/hil/device.py` (parse `switch`).

**Interfaces:**
- Consumes: Tasks 1–3; `netStatsSendFrame`, `netStatsPhy().linkUp`, `hostnameCurrent()`, `snmpSysDescr()`, eth addresses as in `netStatsHasRoutableIPv6()` (take the first valid non-link-local IPv6).
- Produces (`src/lldp_service.h`):
  ```cpp
  void lldpInspectFrame(const uint8_t* frame, size_t len);  // lwIP context
  void lldpPoll();                                         // core 0 loop
  void lldpSwitchText(char* out, size_t cap);               // under DriverLock
  void lldpSwitchAddress(char* out, size_t cap);            // management address text or ""
  void lldpDump();                                          // prints "LLDP <hex>" of the last LLDPDU received, or "LLDP none"
  ```
  `WebStatus` gains `char lldpSwitch[LLDP_TEXT_MAX * 2 + 16]; char lldpSwitchAddr[46];`.

- [ ] **Step 1: Web tests** (native): `test_status_page_shows_switch` (row `Switch</th><td>ex2200, port ge-0/0/5.0 (10.132.0.2)</td>` when both set; `none seen` without); `test_status_page_escapes_switch_name` (`<b>` → `&lt;b&gt;`). Run `pio test -e native -f native/test_web_ui` — FAIL. Implement the row after "Hostname" with `row(...)`/escaping. PASS.
- [ ] **Step 2: Service.** Static `LldpNeighbour` scratch + table + last raw LLDPDU (static, up to 512 bytes, for `lldpdump`), written in `lldpInspectFrame` (lwIP context), read under `DriverLock`. `lldpPoll` once per `LLDP_MIN_GAP_MS`: expire; on link down → `clear()`; build the frame into a static buffer, `contentChanged = memcmp` with the last sent; if `due` → `netStatsSendFrame`, keep a copy, `sent()`. Menu: `Switch: %s` (+ ` (%s)` with an address); `device.py` `status()` adds `info["switch"]`.
- [ ] **Step 3: Build** `pio run -e pico` — success; RAM/flash still under 50 % / 70 %.
- [ ] **Step 4: On-device:** `pio test -e pico` 20/20 (reflash firmware after). Flash, then over serial: status shows `Switch: <switch name>, port ge-0/0/N...` within 35 s; `lldpdump` prints a hex frame. Run the HIL stack test (`test_serial_menu.py`) so core 0's stack headroom is checked with LLDP on.
- [ ] **Step 5: Native suite** `pio test -e native` all PASS. **Commit** `LLDP in the firmware: send, listen, status screen, web page`.

### Task 6: Real EX2200-C vector and HIL tests

**Files:** Modify `test/native/test_lldp/test_main.cpp`; Create `test/hil/test_lldp.py`, `test/hil/switch_console.py`.

- [ ] **Step 1: Capture.** Run `lldpdump` on the device; paste the bytes as `EX2200_C_LLDPDU` with a comment (captured 2026-11-01 from the EX2200-C). Test `test_parse_reads_real_ex2200_c_frame`: Ok; sysName and port text equal what the switch reports for itself and for that port (read once over the console: `show lldp local-information`, `show lldp neighbors`). Run — PASS (the parser exists; if it fails, it is a parser bug: fix with TDD). Delete nothing from `JUNOS_STYLE`.
- [ ] **Step 2: `switch_console.py`:** opens `RFUPS_LLDP_SWITCH_CONSOLE` at 9600, reads credentials (`username:`/`password:` lines) from the file, logs in (`login:` / `Password:`; a `%` shell prompt means root: send `cli`), runs a command with `| no-more`, returns its output, logs out (`exit` until `login:`). Never prints or puts the credentials in exceptions.
- [ ] **Step 3: `test_lldp.py`:**
  - `test_status_shows_the_switch` (`RFUPS_LLDP_SWITCH=1`): within 35 s `status()["switch"]` is not "none seen".
  - `test_switch_lists_the_device` (console opt-in): `show lldp neighbors` has a line with the device MAC; `show lldp neighbors interface <that interface>` shows System name = device hostname and the device's IPv4 address.
  - `test_switch_learns_new_hostname_within_5_s` (console opt-in): change the hostname with `set_snmp` to `rfups-lldp-test`, the switch shows it within 5 s; restore the old hostname in `finally`.
- [ ] **Step 4: Run** `python.exe -m unittest test.hil.test_lldp -v` with both env vars — all PASS. RED check: with `lldpPoll()` not called (temporary), `test_switch_lists_the_device` fails after the switch's TTL runs out; restore and reflash.
- [ ] **Step 5: Commit** `LLDP: real EX2200-C vector and HIL tests`.

### Task 7: Docs and version

**Files:** `include/version.h` (2.6.0), `CHANGELOG.md`, `README.md` (LLDP section: what is sent, the status line, the web row), `docs/TESTING.md` (env vars, the console test, `lldpdump`), `TODO.md`, `CLAUDE.md` (layout line for `lib/lldp`, `src/lldp_service.cpp`).

- [ ] **Step 1:** Write the docs. Full native suite, sanitizers, `pio run -e pico`, HIL web + SNMP + serial menu suites pass; restore community `rfit` and trap settings if a test changed them.
- [ ] **Step 2: Commit** `LLDP: docs, version 2.6.0`.
