TheKingOfChaos/RF-Power-Monitor/hardware/pico-poe-mains-carrier/images/iso-back-headers.png

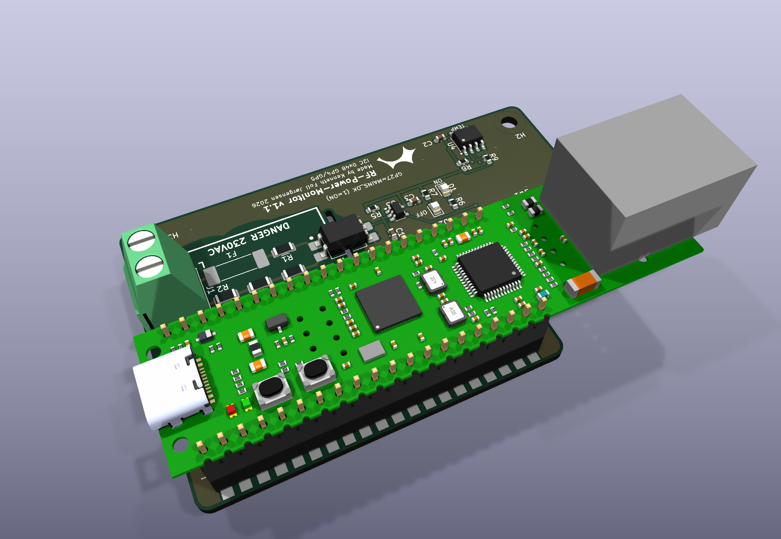
hardware/pico-poe-mains-carrier/images/iso-back-headers.png
