TheKingOfChaos/RF-Power-Monitor/hardware/pico-poe-mains-carrier/images/iso-back.png

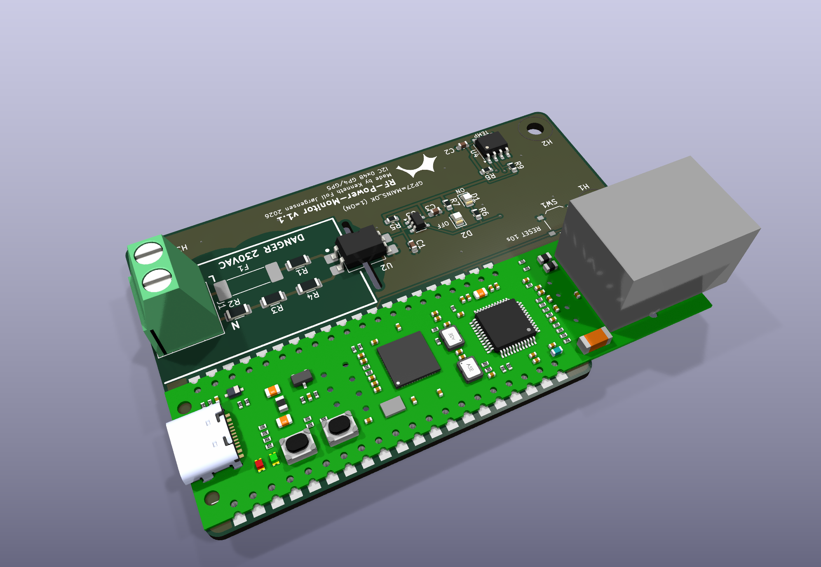
hardware/pico-poe-mains-carrier/images/iso-back.png
