TheKingOfChaos/RF-Power-Monitor/hardware/pico-poe-mains-carrier/images/iso-carrier-only.png

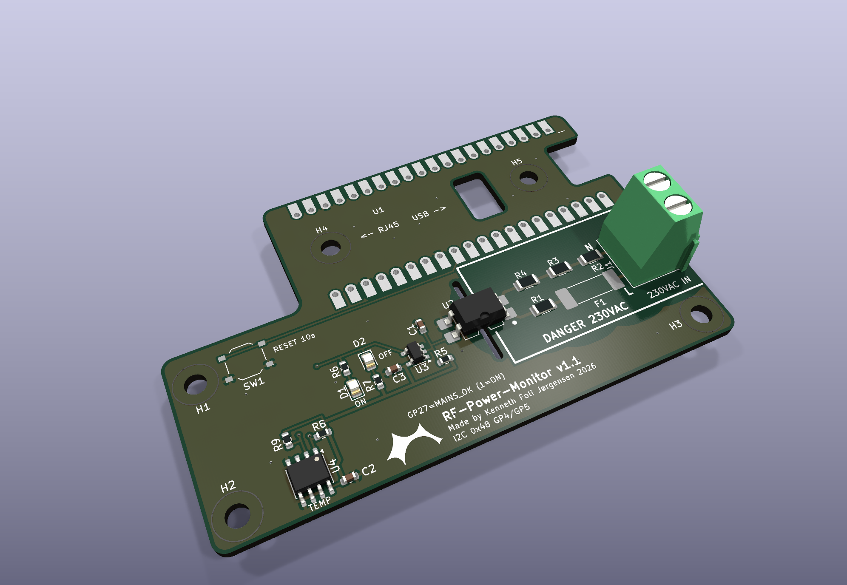
hardware/pico-poe-mains-carrier/images/iso-carrier-only.png
