TheKingOfChaos/RF-Power-Monitor/hardware/pico-poe-mains-carrier/images/top.png

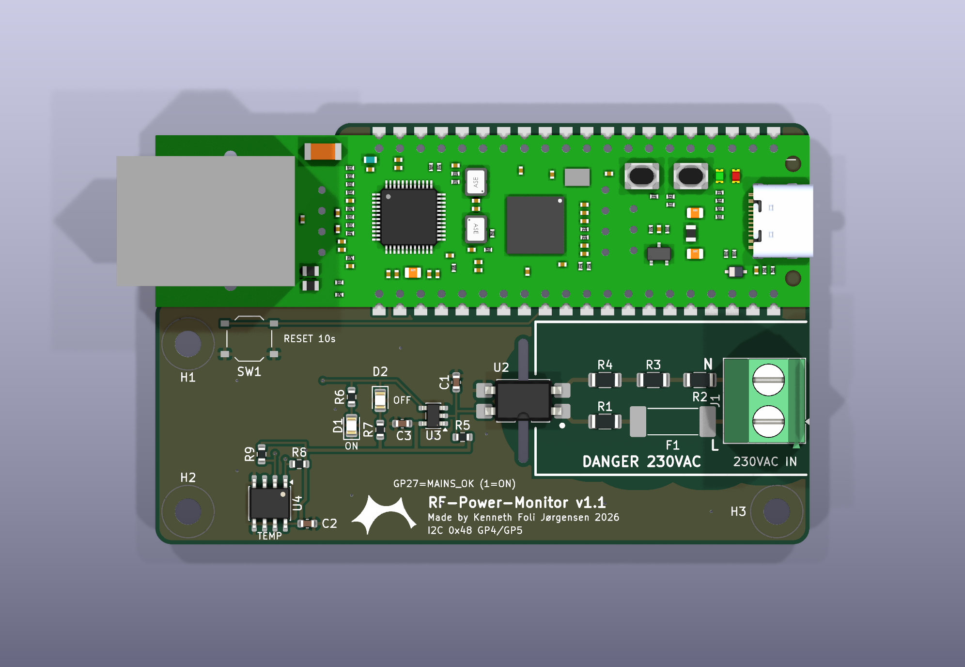
hardware/pico-poe-mains-carrier/images/top.png
