TheKingOfChaos/RF-Power-Monitor/hardware/rf-power-monitor-rev2/out/img/board-iso-right.png

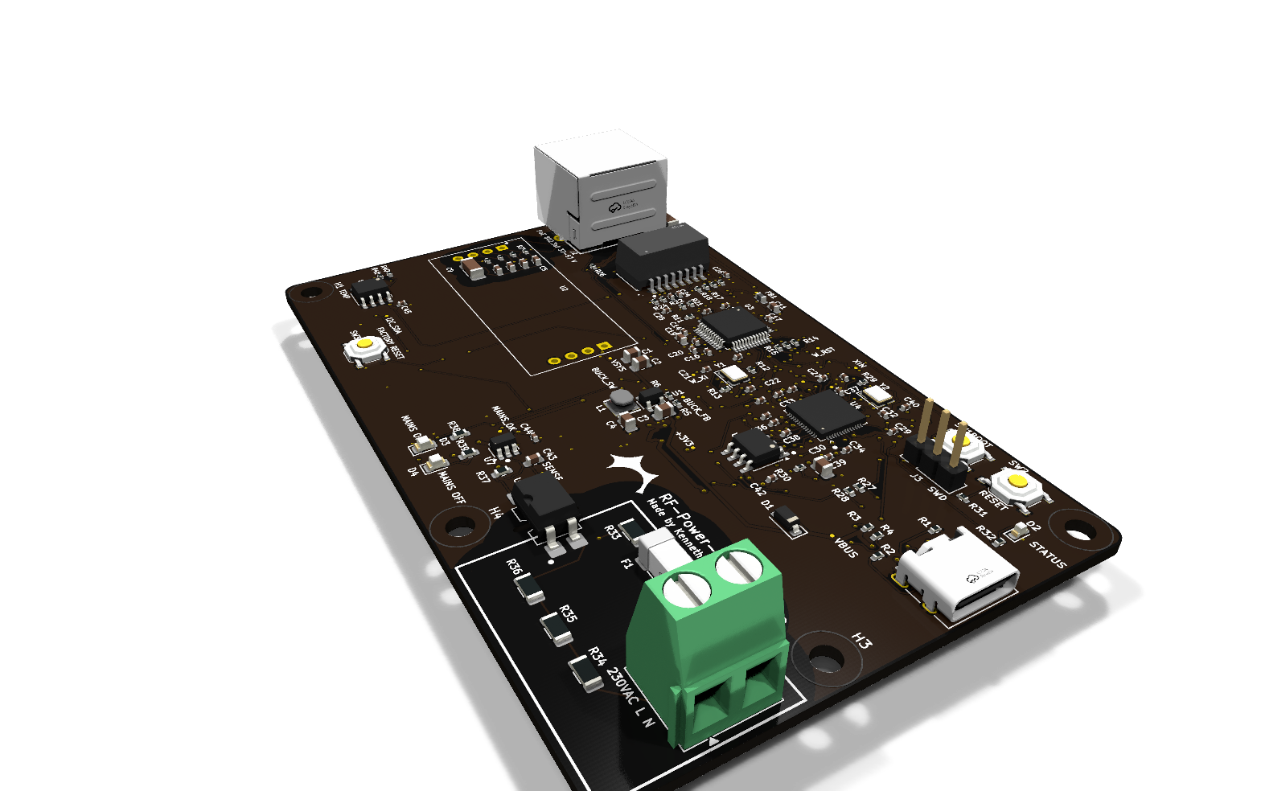
hardware/rf-power-monitor-rev2/out/img/board-iso-right.png
