TheKingOfChaos/RF-Power-Monitor/hardware/rf-power-monitor-rev2/out/img/fields.png

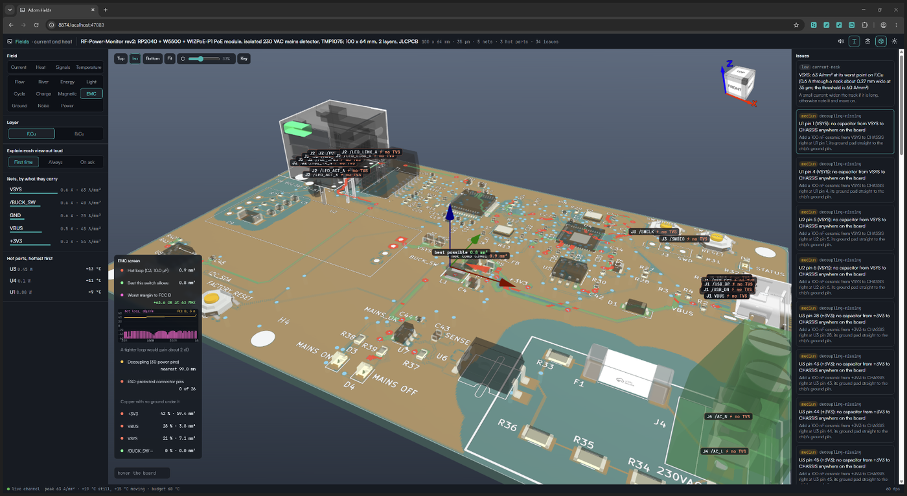
hardware/rf-power-monitor-rev2/out/img/fields.png
