TheKingOfChaos/RF-Power-Monitor/hardware/rf-power-monitor-rev2/out/img/layout-buck.png

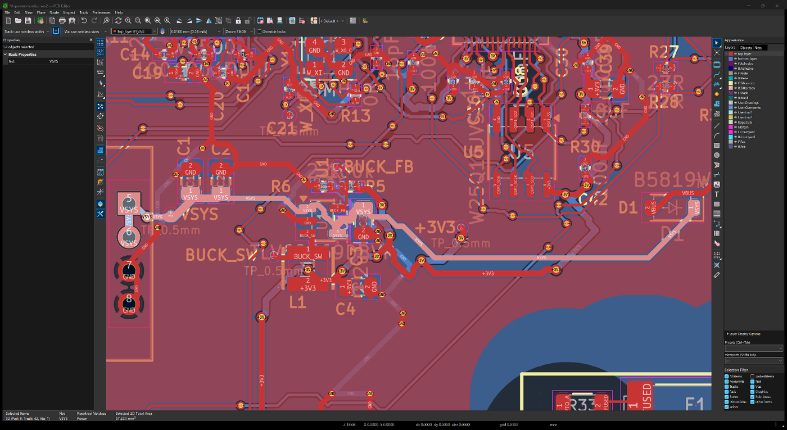
hardware/rf-power-monitor-rev2/out/img/layout-buck.png
