TheKingOfChaos/RF-Power-Monitor/hardware/rf-power-monitor-rev2/out/img/schematic.png

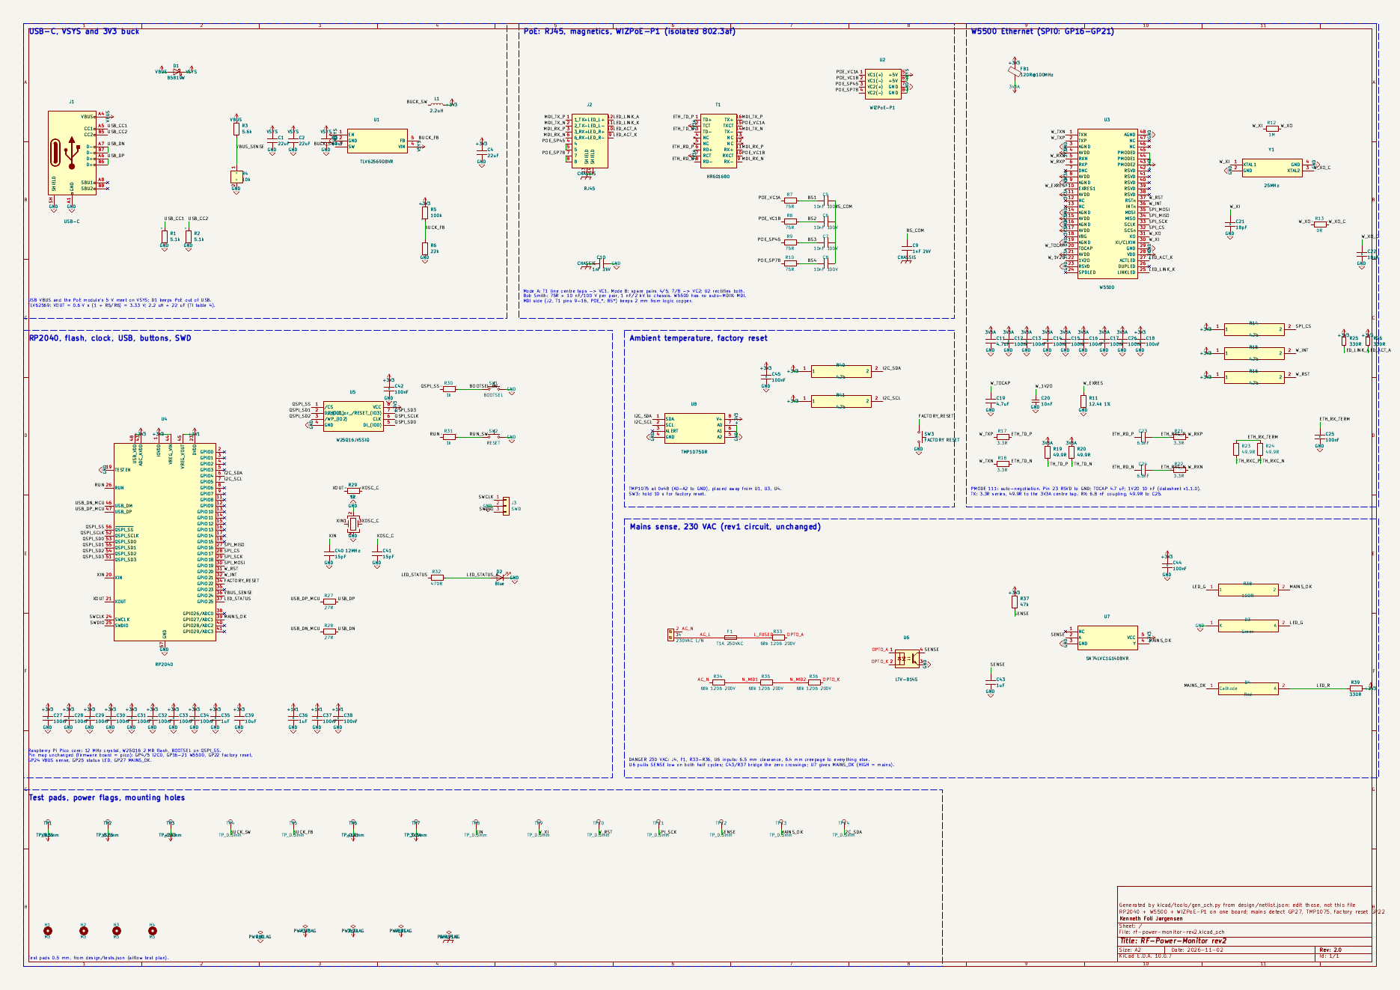
hardware/rf-power-monitor-rev2/out/img/schematic.png
