TheKingOfChaos/RF-Power-Monitor/hardware/pico-poe-mains-carrier/3d/pico-poe-mains-carrier.step

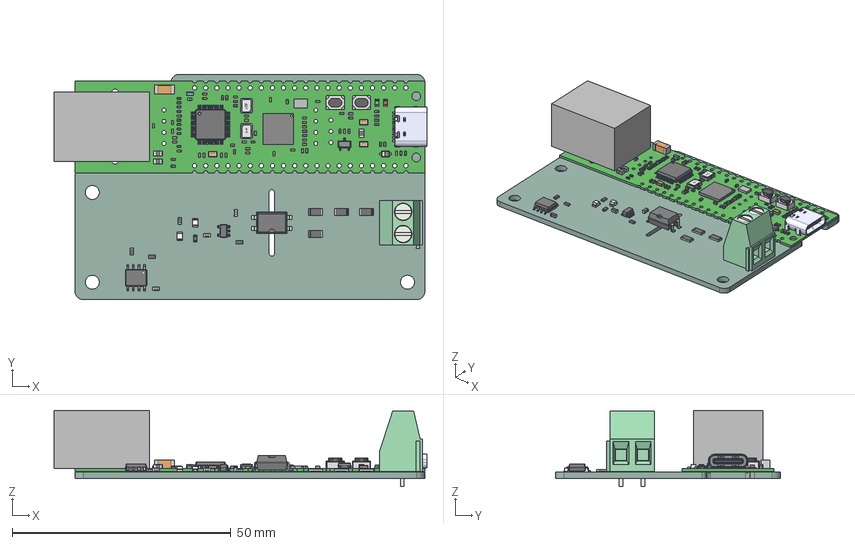
[picture p20: CAD file, 2026-11-01]
hardware/pico-poe-mains-carrier/3d/pico-poe-mains-carrier.step
85.2 x 51.5 x 17.5 mm
TerminalBlock_Phoenix_MKDS-1,5-2-5.08_1x02_P5.08mm_Horizontal
R_1206_3216Metric x 4
CAPC1005X06 x 33
RES_C1005X04N x 35
User_Library-QFN56_0_4
User_Library-ABRACON_ASE x 2
Extruded x 14
TYPE-C-31-M-12
User_Library-lqfp48-1
User_Library-LTST-C190GKT_Pad005
User_Library-LTST-C190GKT_Pad001
User_Library-LTST-C190GKT_Pad004
User_Library-LTST-C190GKT_Pad003
User_Library-LTST-C190GKT_Lens
User_Library-LTST-C190GKT_Pad
User_Library-LTST-C190EKT_Pad
User_Library-LTST-C190EKT_Pad005
User_Library-LTST-C190EKT_Pad001
User_Library-LTST-C190EKT_Pad004
User_Library-LTST-C190EKT_Pad003
User_Library-LTST-C190EKT_Lens
User_Library-Chip_InductorINDC1608X95N
SW3dPS-SOD-323F_Board5
SW3dPS-SOD-323F_Extruded9 x 2
SW3dPS-SOD-323F_Board4 x 2
SW3dPS-SOD-323F_Extruded8 x 2
SW3dPS-SOD-323F_Extruded10 x 2
SW3dPS-SOD-323F_Board3 x 2
SW3dPS-SOD-323F_Extruded7
SW3dPS-SOD-323F_Extruded6
SW3dPS-SOD-323F_Extruded11
0805_SMD_Capacitor x 3
User_Library-Chip_Cap_MLCC_1808_(4520)_K
R_0603_1608Metric x 5
SMDIP_4_W953mm
C_0603_1608Metric x 3
SOIC-8_3.9x4.9mm_P1.27mm
SOT-23-5
LED_0805_2012Metric x 2
pico-poe-mains-carrier_PCB
