TheKingOfChaos/RF-Power-Monitor/hardware/pico-poe-mains-carrier/fab/pico-poe-mains-carrier.step

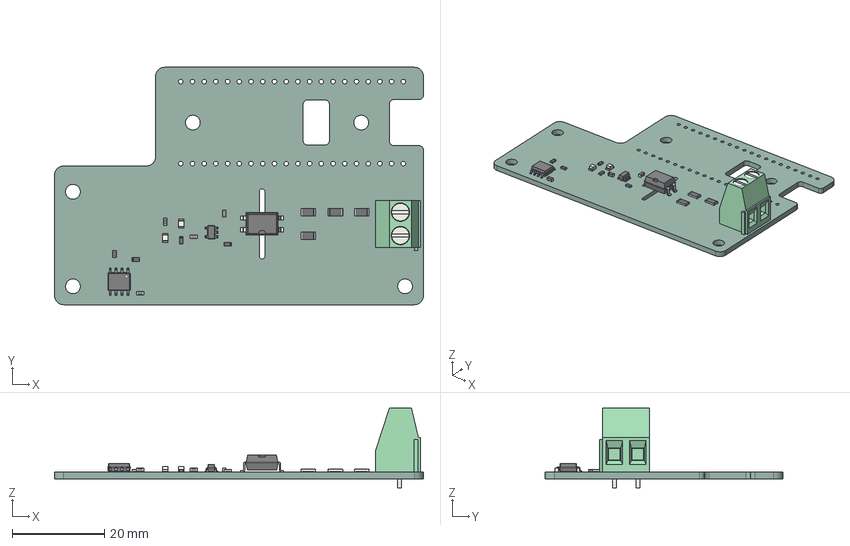
[picture p21: CAD file, 2026-11-01]
hardware/pico-poe-mains-carrier/fab/pico-poe-mains-carrier.step
80.0 x 51.5 x 17.3 mm
TerminalBlock_Phoenix_MKDS-1,5-2-5.08_1x02_P5.08mm_Horizontal
R_1206_3216Metric x 4
R_0603_1608Metric x 5
SMDIP_4_W953mm
C_0603_1608Metric x 3
SOIC-8_3.9x4.9mm_P1.27mm
SOT-23-5
LED_0805_2012Metric x 2
pico-poe-mains-carrier_PCB
