TheKingOfChaos/RF-Power-Monitor/hardware/Case/Power Case - Lidt.step

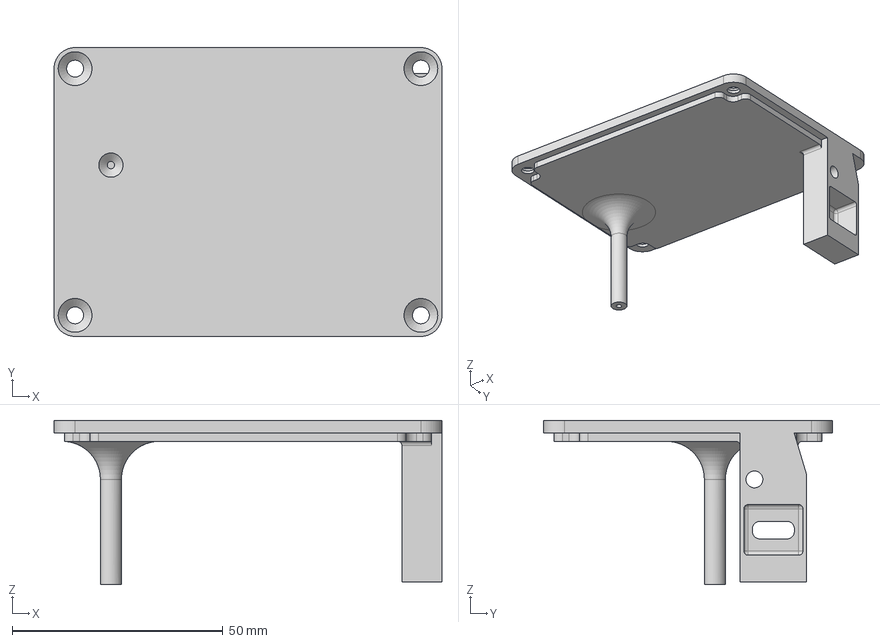
[picture p23: CAD file, 2026-10-31]
hardware/Case/Power Case - Lidt.step
92.0 x 68.5 x 39.0 mm
