TheKingOfChaos/RF-Power-Monitor/hardware/Case/Power Case - case.step

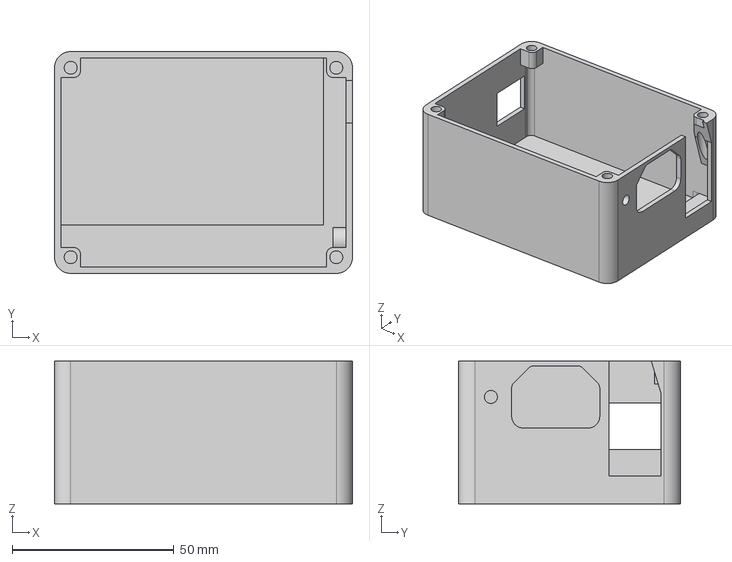
[picture p24: CAD file, 2026-10-31]
hardware/Case/Power Case - case.step
92.0 x 68.5 x 44.0 mm
