TheKingOfChaos/RF-Power-Monitor/hardware/pico-poe-mains-carrier/3d/Power Case.3mf

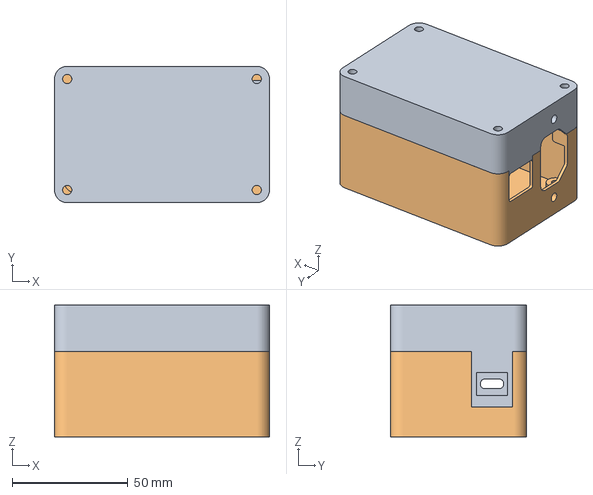
[picture p25: CAD file, 2026-10-31]
hardware/pico-poe-mains-carrier/3d/Power Case.3mf
93.0 x 59.0 x 57.0 mm
