TheKingOfChaos/RF-Power-Monitor/(list of files, cad)

Other CAD files:
hardware/Case/Power Case.f3z
