TheKingOfChaos/RF-Power-Monitor/hardware/rf-power-monitor-rev2/kicad/rf-power-monitor-rev2.kicad_pcb

## KiCad design hardware/rf-power-monitor-rev2/kicad/rf-power-monitor-rev2.kicad_pcb (2026-11-05)

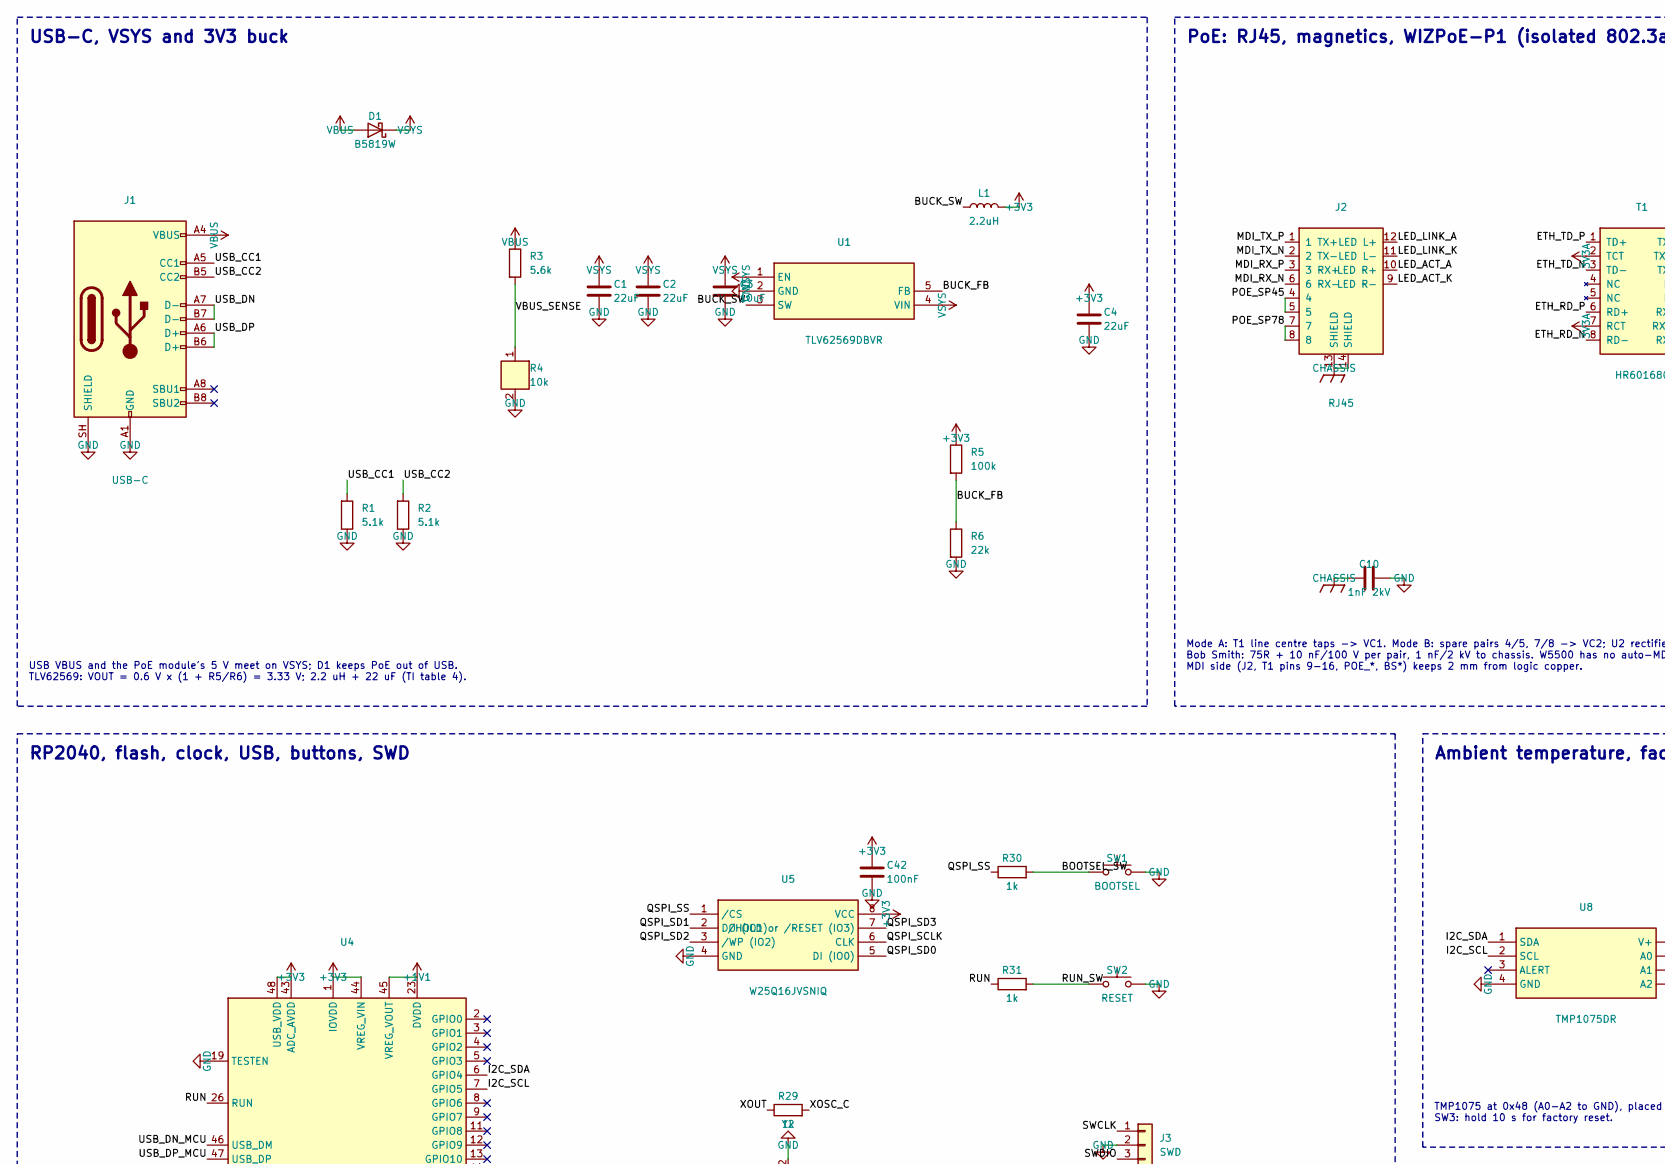
[picture p36: schematic rf-power-monitor-rev2.kicad_sch, RF-Power-Monitor rev2, part in row 1, column 1]

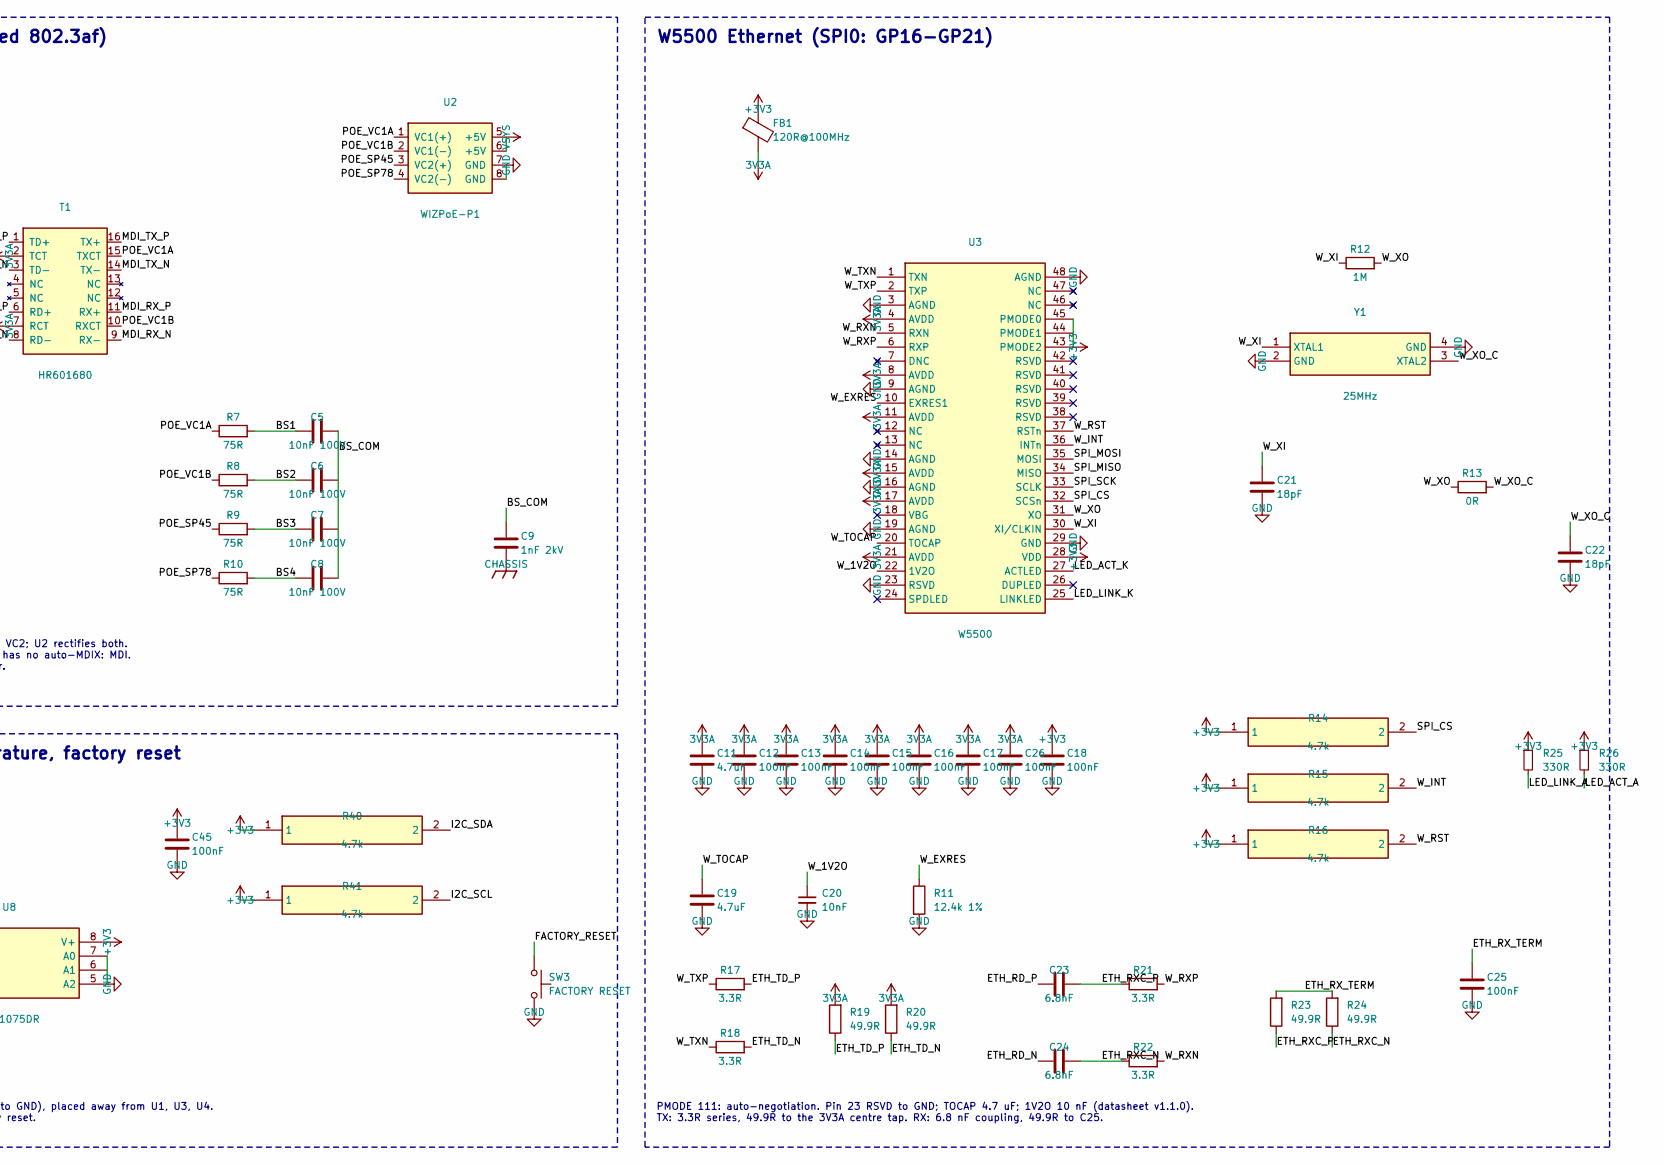
[picture p37: schematic rf-power-monitor-rev2.kicad_sch, RF-Power-Monitor rev2, part in row 1, column 2]

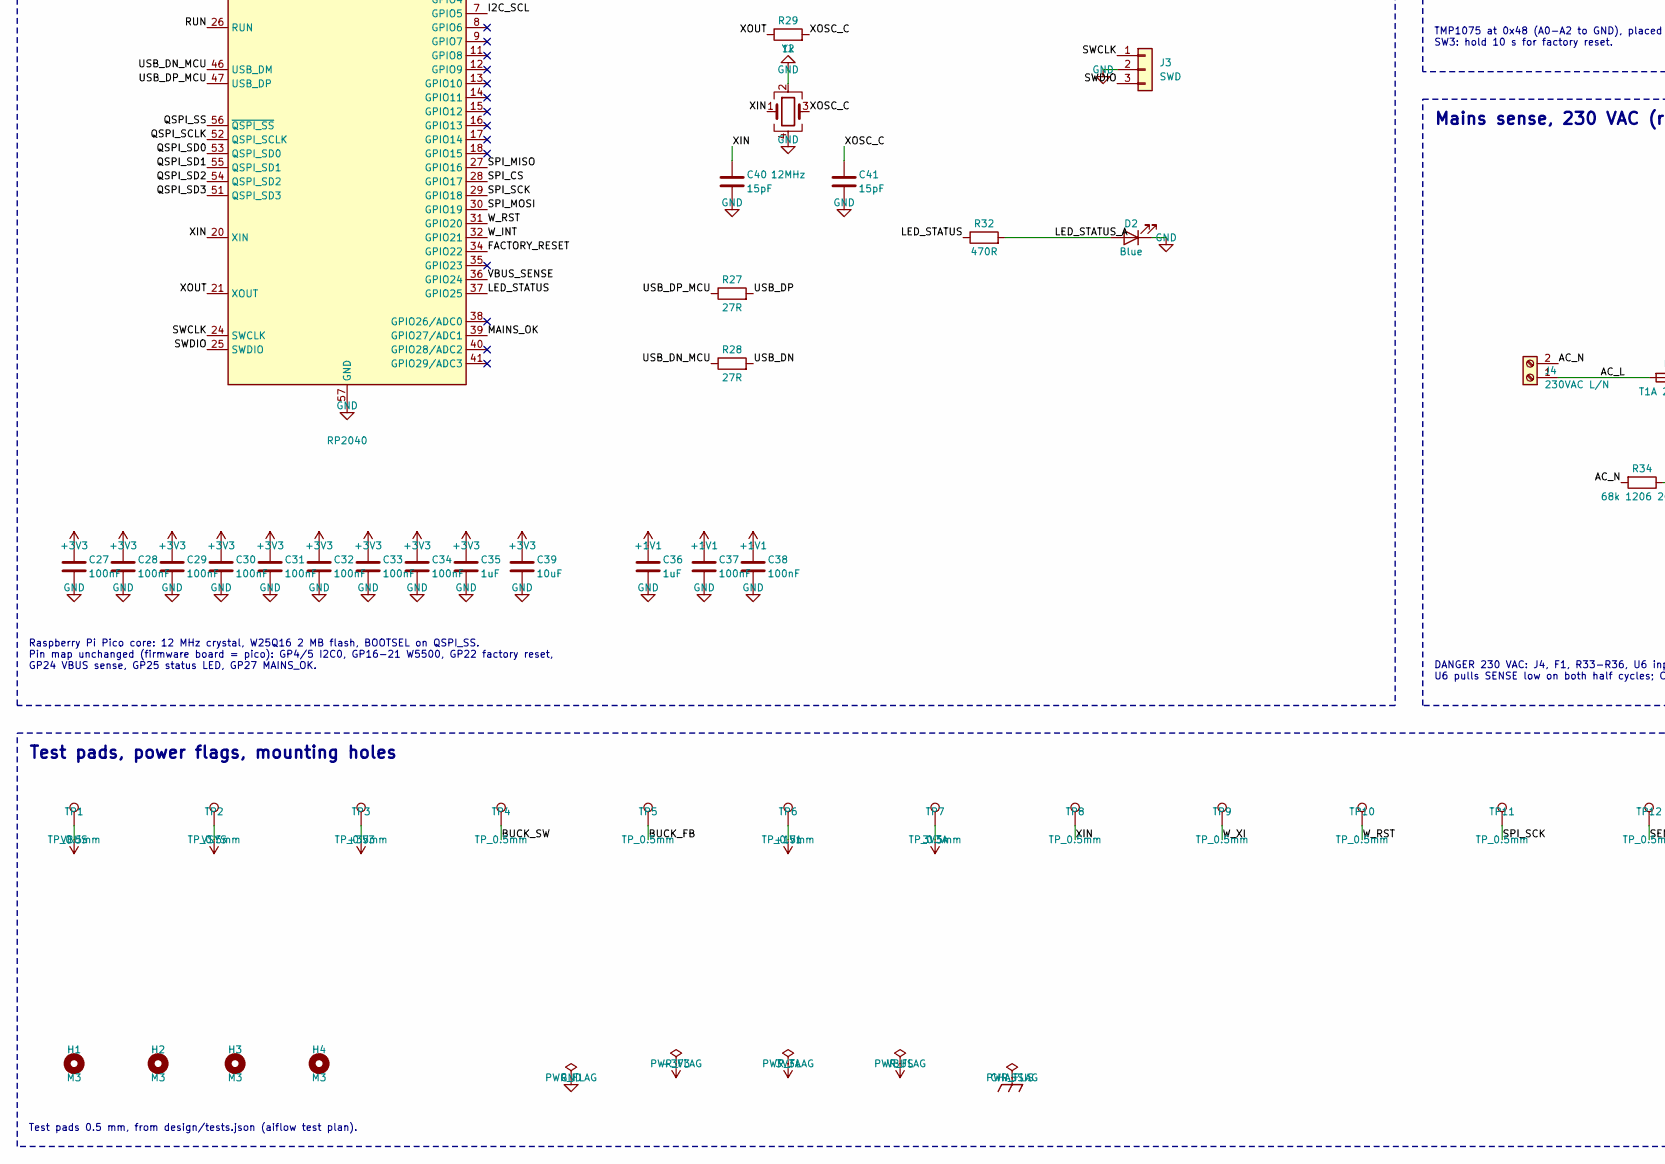
[picture p38: schematic rf-power-monitor-rev2.kicad_sch, RF-Power-Monitor rev2, part in row 2, column 1]

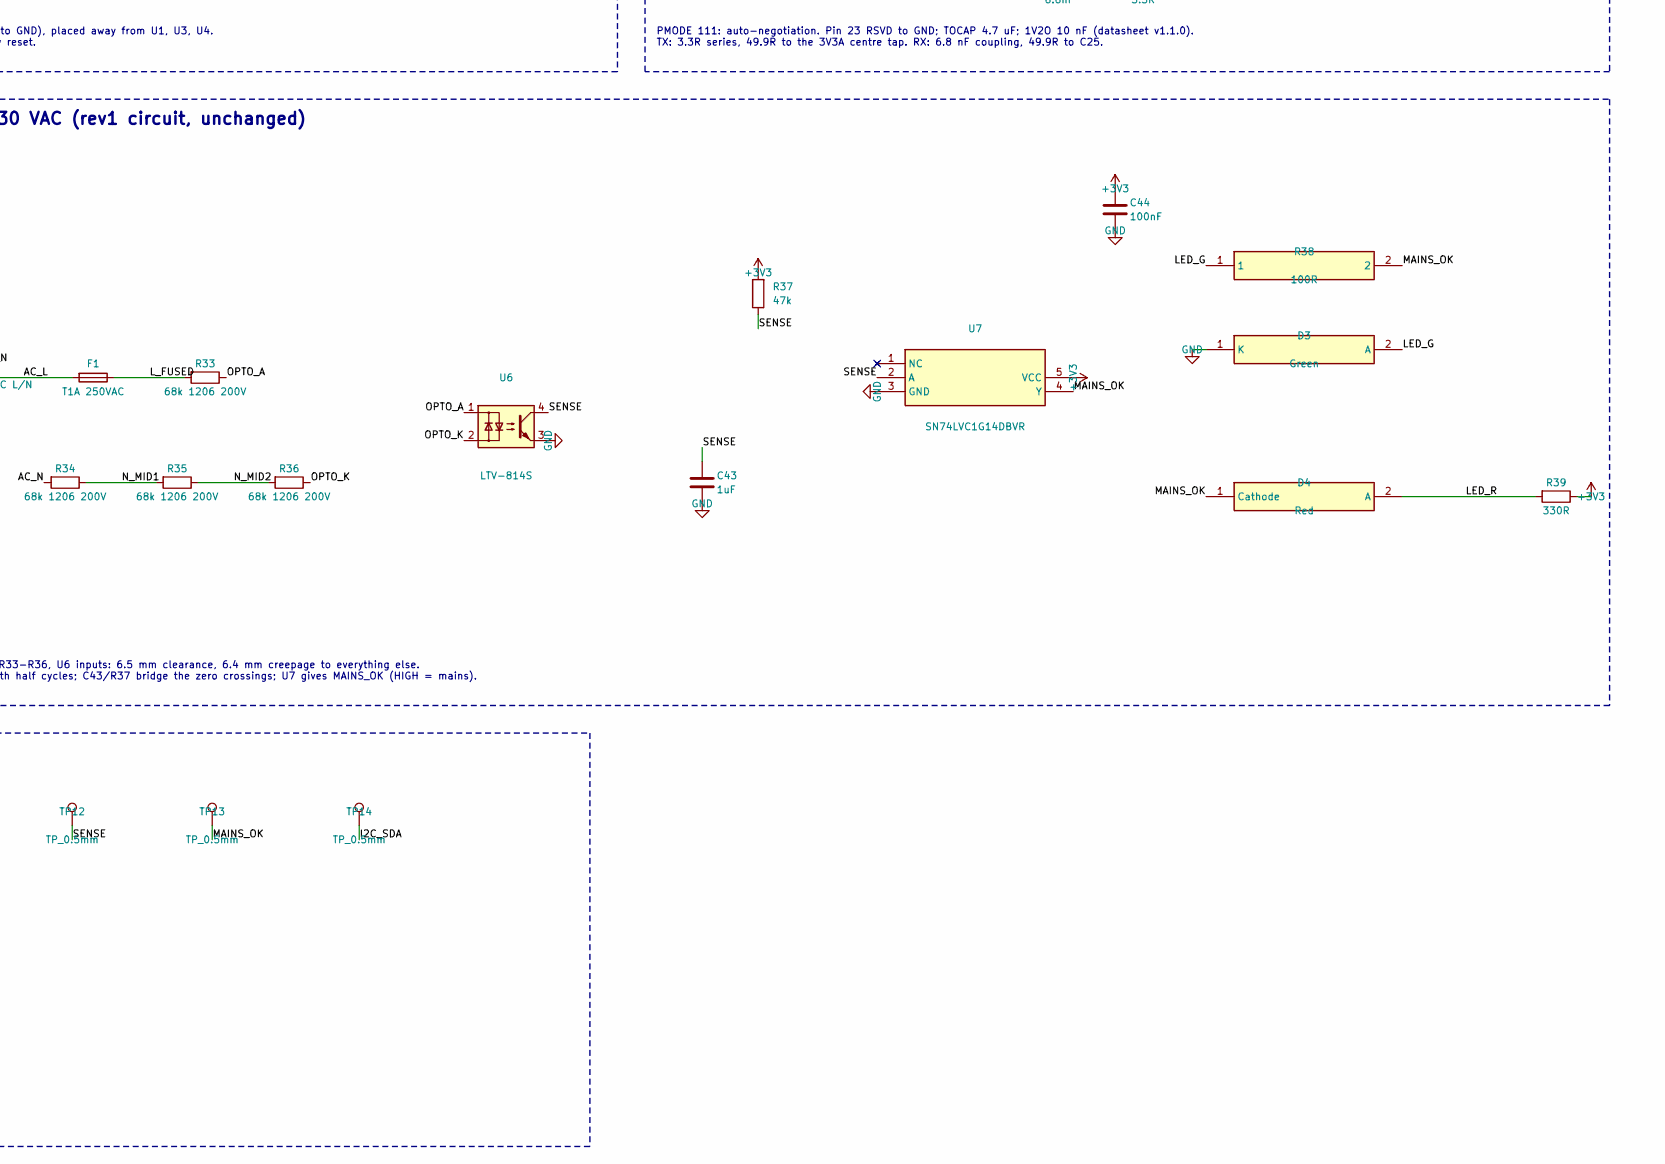
[picture p39: schematic rf-power-monitor-rev2.kicad_sch, RF-Power-Monitor rev2, part in row 2, column 2]

Parts:
C1, C2, C4: 22uF; CL21A226MAQNNNE; MPN CL21A226MAQNNNE; LCSC C45783
C3, C39: 10uF; C_0805_2012Metric; MPN CL21A106KAYNNNE; LCSC C15850
C5, C6, C7, C8: 10nF 100V; C_0603_1608Metric; MPN CC0603KRX7R0BB103; LCSC C107059
C9, C10: 1nF 2kV; C_1808_4520Metric; MPN 1808B102K202NT; LCSC C81332
C11, C19: 4.7uF; CL10A475KO8NNNC; MPN CL10A475KO8NNNC; LCSC C19666
C12, C13, C14, C15, C16, C17, C18, C25, C26, C27, C28, C29, C30, C31, C32, C33, C34, C37, C38, C42, C44, C45: 100nF; C_0402_1005Metric; MPN CL05B104KO5NNNC; LCSC C1525
C20: 10nF; CL05B103KB5NNNC; MPN CL05B103KB5NNNC; LCSC C15195
C21, C22: 18pF; C_0402_1005Metric_0402CG180J500NT; MPN 0402CG180J500NT; LCSC C1549
C23, C24: 6.8nF; C_0402_1005Metric; MPN 0402B682K500NT; LCSC C1542
C35, C36: 1uF; C_0402_1005Metric_CL05A105KA5NQNC; MPN CL05A105KA5NQNC; LCSC C52923
C40, C41: 15pF; C_0402_1005Metric_0402CG150J500NT; MPN 0402CG150J500NT; LCSC C1548
C43: 1uF; C_0603_1608Metric; MPN CL10B105KB8NQNC; LCSC C5199872
D1: B5819W; D_SOD-123; MPN B5819W SL; LCSC C8598
D2: Blue; LED_0603_1608Metric; MPN 19-217/BHC-ZL1M2RY/6T; LCSC C2986058
D3: Green; LED_0805_2012Metric; MPN KT-0805G; LCSC C2297
D4: Red; LED_0805_2012Metric; MPN NCD0805R1; LCSC C84256
F1: T1A 250VAC; Fuse_Schurter_UMT250; MPN SCT1032T1A250V; LCSC C19712559
FB1: 120R@100MHz; L_0603_1608Metric; MPN GZ1608D121TF; LCSC C12391
H1, H2, H3, H4: M3; MountingHole_3.2mm_M3
J1: USB-C; USB_C_Receptacle_HRO_TYPE-C-31-M-12; MPN TYPE-C-31-M-12; LCSC C165948
J2: RJ45; RJ45-TH_KH-RJ45-56-8P8C-D; MPN KH-RJ45-56-8P8C-D; LCSC C2828082
J3: SWD; PinHeader_1x03_P2.54mm_Vertical
J4: 230VAC L/N; TerminalBlock_Phoenix_MKDS-1,5-2-5.08_1x02_P5.08mm_Horizont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; MPN WJ500V-5.08-2P; LCSC C8465
L1: 2.2uH; IND-SMD_L3.0-W3.0; MPN SWPA3015S2R2MT; LCSC C43389
R1, R2: 5.1k; R_0402_1005Metric; MPN 0402WGF5101TCE; LCSC C25905
R3: 5.6k; R_0402_1005Metric; MPN 0402WGF5601TCE; LCSC C25908
R4: 10k; R_0402_1005Metric_RC0402FR-0710KL; MPN RC0402FR-0710KL; LCSC C60490
R5: 100k; R_0402_1005Metric_0402WGF1003TCE; MPN 0402WGF1003TCE; LCSC C25741
R6: 22k; R_0402_1005Metric; MPN RC0402FR-0722KL; LCSC C82868
R7, R8, R9, R10: 75R; R_0402_1005Metric; MPN RC0402FR-0775RL; LCSC C114757
R11: 12.4k 1%; R_0402_1005Metric; MPN 0402WGF1242TCE; LCSC C11692
R12: 1M; R_0402_1005Metric; MPN 0402WGF1004TCE; LCSC C26083
R13: 0R; R_0402_1005Metric_0402WGF1003TCE; MPN 0402WGF0000TCE; LCSC C17168
R14, R15, R16, R40, R41: 4.7k; R_0402_1005Metric_0402WGF1003TCE; MPN 0402WGF4701TCE; LCSC C25900
R17, R18, R21, R22: 3.3R; R_0402_1005Metric; MPN RC0402FR-073R3L; LCSC C137986
R19, R20, R23, R24: 49.9R; R_0402_1005Metric; MPN 0402WGF499JTCE; LCSC C25120
R25, R26: 330R; 0402WGF3300TCE; MPN 0402WGF3300TCE; LCSC C25104
R27, R28: 27R; R_0402_1005Metric; MPN RC0402FR-0727RL; LCSC C138021
R29, R30, R31: 1k; R_0402_1005Metric_0402WGF1003TCE; MPN 0402WGF1001TCE; LCSC C11702
R32: 470R; R_0402_1005Metric; MPN RC0402FR-07470RL; LCSC C114877
R33, R34, R35, R36: 68k 1206 200V; R_1206_3216Metric; MPN 1206W4F6802T5E; LCSC C25834
R37: 47k; R_0603_1608Metric; MPN 0603WAF4702T5E; LCSC C25819
R38: 100R; R_0603_1608Metric; MPN 0603WAF1000T5E; LCSC C22775
R39: 330R; R_0603_1608Metric; MPN RC0603FR-07330RL; LCSC C105881
SW1: BOOTSEL; SW_Push_1P1T_XKB_TS-1187A; MPN TS-1187A-B-A-B; LCSC C318884
SW2: RESET; SW_Push_1P1T_XKB_TS-1187A; MPN TS-1187A-B-A-B; LCSC C318884
SW3: FACTORY RESET; SW_Push_1P1T_XKB_TS-1187A; MPN TS-1187A-B-A-B; LCSC C318884
T1: HR601680; SMD-16_L12.7-W7.2-P1.27-LS9.5-BL; MPN HR601680; LCSC C242560
TP1, TP2, TP3, TP4, TP5, TP6, TP7, TP8, TP9, TP10, TP11, TP12, TP13, TP14: TP_0.5mm; TestPoint_Pad_D0.5mm; MPN Adom_TestPoint_D0.5mm
U1: TLV62569DBVR; SOT-23-5; MPN TLV62569DBVR; LCSC C141836
U2: WIZPoE-P1; MPN WIZPoE-P1
U3: W5500; LQFP-48_7x7mm_P0.5mm; MPN W5500; LCSC C32843
U4: RP2040; QFN-56-1EP_7x7mm_P0.4mm_EP3.2x3.2mm; MPN RP2040; LCSC C2040
U5: W25Q16JVSNIQ; SOIC-8_3.9x4.9mm_P1.27mm; MPN W25Q16JVSNIQ; LCSC C2456211
U6: LTV-814S; SMDIP-4_W9.53mm; MPN LTV-814S-TA1; LCSC C125118
U7: SN74LVC1G14DBVR; SOT-23-5; MPN SN74LVC1G14DBVR; LCSC C7835
U8: TMP1075DR; SOIC-8_3.9x4.9mm_P1.27mm; MPN TMP1075DR; LCSC C2878381
Y1: 25MHz; Crystal_SMD_3225-4Pin_3.2x2.5mm; MPN X322525MOB4SI; LCSC C9006
Y2: 12MHz; Crystal_SMD_Abracon_ABM8AIG-4Pin_3.2x2.5mm; MPN ABM8-272-T3; LCSC C20625731

Connections:
3V3A: C11.1, C12.1, C13.1, C14.1, C15.1, C16.1, C17.1, C26.1, FB1.2, R19.2, R20.2, T1.2 (TCT), T1.7 (RCT), TP7.1, U3.4 (AVDD), U3.8 (AVDD), U3.11 (AVDD), U3.15 (AVDD), U3.17 (AVDD), U3.21 (AVDD)
+1V1: C36.1, C37.1, C38.1, TP6.1, U4.23 (DVDD), U4.45 (VREG_VOUT), U4.50 (DVDD)
+3V3: C4.1, C18.1, C27.1, C28.1, C29.1, C30.1, C31.1, C32.1, C33.1, C34.1, C35.1, C39.1, C42.1, C44.1, C45.1, FB1.1, L1.2, R5.1, R14.1, R15.1, R16.1, R25.1, R26.1, R37.2, R39.1, R40.1, R41.1, TP3.1, U3.28 (VDD), U3.43 (PMODE2), U3.44 (PMODE1), U3.45 (PMODE0), U4.1 (IOVDD), U4.10 (IOVDD), U4.22 (IOVDD), U4.33 (IOVDD), U4.42 (IOVDD), U4.43 (ADC_AVDD), U4.44 (VREG_VIN), U4.48 (USB_VDD), U4.49 (IOVDD), U5.8 (VCC), U7.5 (VCC), U8.8 (V+)
/AC_L: F1.2, J4.1
/AC_N: J4.2, R34.2
/BOOTSEL_SW: R30.2, SW1.1
/BS1: C5.1, R7.2
/BS2: C6.1, R8.2
/BS3: C7.1, R9.2
/BS4: C8.1, R10.2
/BS_COM: C5.2, C6.2, C7.2, C8.2, C9.1
/BUCK_FB: R5.2, R6.1, TP5.1, U1.5 (FB)
/BUCK_SW: L1.1, TP4.1, U1.3 (SW)
/ETH_RD_N: C24.1, T1.8 (RD-)
/ETH_RD_P: C23.1, T1.6 (RD+)
/ETH_RXC_N: C24.2, R22.1, R24.1
/ETH_RXC_P: C23.2, R21.1, R23.1
/ETH_RX_TERM: C25.1, R23.2, R24.2
/ETH_TD_N: R18.2, R20.1, T1.3 (TD-)
/ETH_TD_P: R17.2, R19.1, T1.1 (TD+)
/FACTORY_RESET: SW3.1, U4.34 (GPIO22)
/I2C_SCL: R41.2, U4.7 (GPIO5), U8.2 (SCL)
/I2C_SDA: R40.2, TP14.1, U4.6 (GPIO4), U8.1 (SDA)
/LED_ACT_A: J2.10 (LED R+), R26.2
/LED_ACT_K: J2.9 (LED R-), U3.27 (ACTLED)
/LED_G: D3.2 (A), R38.1
/LED_LINK_A: J2.12 (LED L+), R25.2
/LED_LINK_K: J2.11 (LED L-), U3.25 (LINKLED)
/LED_R: D4.2 (A), R39.2
/LED_STATUS: R32.1, U4.37 (GPIO25)
/LED_STATUS_A: D2.2 (A), R32.2
/L_FUSED: F1.1, R33.2
/MAINS_OK: D4.1 (Cathode), R38.2, TP13.1, U4.39 (GPIO27/ADC1), U7.4 (Y)
/MDI_RX_N: J2.6 (6 RX-), T1.9 (RX-)
/MDI_RX_P: J2.3 (3 RX+), T1.11 (RX+)
/MDI_TX_N: J2.2 (2 TX-), T1.14 (TX-)
/MDI_TX_P: J2.1 (1 TX+), T1.16 (TX+)
/N_MID1: R34.1, R35.2
/N_MID2: R35.1, R36.2
/OPTO_A: R33.1, U6.1
/OPTO_K: R36.1, U6.2
/POE_SP45: J2.4, J2.5, R9.1, U2.3 (VC2(+))
/POE_SP78: J2.7, J2.8, R10.1, U2.4 (VC2(-))
/POE_VC1A: R7.1, T1.15 (TXCT), U2.1 (VC1(+))
/POE_VC1B: R8.1, T1.10 (RXCT), U2.2 (VC1(-))
/QSPI_SCLK: U4.52 (QSPI_SCLK), U5.6 (CLK)
/QSPI_SD0: U4.53 (QSPI_SD0), U5.5 (DI (IO0))
/QSPI_SD1: U4.55 (QSPI_SD1), U5.2 (DO (IO1))
/QSPI_SD2: U4.54 (QSPI_SD2), U5.3 (/WP (IO2))
/QSPI_SD3: U4.51 (QSPI_SD3), U5.7 (/HOLD or /RESET (IO3))
/QSPI_SS: R30.1, U4.56 (~QSPI_SS), U5.1 (/CS)
/RUN: R31.1, U4.26 (RUN)
/RUN_SW: R31.2, SW2.1
/SENSE: C43.1, R37.1, TP12.1, U6.4, U7.2 (A)
/SPI_CS: R14.2, U3.32 (SCSn), U4.28 (GPIO17)
/SPI_MISO: U3.34 (MISO), U4.27 (GPIO16)
/SPI_MOSI: U3.35 (MOSI), U4.30 (GPIO19)
/SPI_SCK: TP11.1, U3.33 (SCLK), U4.29 (GPIO18)
/SWCLK: J3.1, U4.24 (SWCLK)
/SWDIO: J3.3, U4.25 (SWDIO)
/USB_CC1: J1.A5 (CC1), R1.1
/USB_CC2: J1.B5 (CC2), R2.1
/USB_DN: J1.A7 (D-), J1.B7 (D-), R28.2
/USB_DN_MCU: R28.1, U4.46 (USB_DM)
/USB_DP: J1.A6 (D+), J1.B6 (D+), R27.2
/USB_DP_MCU: R27.1, U4.47 (USB_DP)
/VBUS_SENSE: R3.2, R4.1, U4.36 (GPIO24)
/W_1V2O: C20.1, U3.22 (1V2O)
/W_EXRES: R11.1, U3.10 (EXRES1)
/W_INT: R15.2, U3.36 (INTn), U4.32 (GPIO21)
/W_RST: R16.2, TP10.1, U3.37 (RSTn), U4.31 (GPIO20)
/W_RXN: R22.2, U3.5 (RXN)
/W_RXP: R21.2, U3.6 (RXP)
/W_TOCAP: C19.1, U3.20 (TOCAP)
/W_TXN: R18.1, U3.1 (TXN)
/W_TXP: R17.1, U3.2 (TXP)
/W_XI: C21.1, R12.1, TP9.1, U3.30 (XI/CLKIN), Y1.1 (XTAL1)
/W_XO: R12.2, R13.1, U3.31 (XO)
/W_XO_C: C22.1, R13.2, Y1.3 (XTAL2)
/XIN: C40.1, TP8.1, U4.20 (XIN), Y2.1
/XOSC_C: C41.1, R29.2, Y2.3
/XOUT: R29.1, U4.21 (XOUT)
CHASSIS: C9.2, C10.1, J2.13 (SHIELD), J2.14 (SHIELD)
GND: C1.2, C2.2, C3.2, C4.2, C10.2, C11.2, C12.2, C13.2, C14.2, C15.2, C16.2, C17.2, C18.2, C19.2, C20.2, C21.2, C22.2, C25.2, C26.2, C27.2, C28.2, C29.2, C30.2, C31.2, C32.2, C33.2, C34.2, C35.2, C36.2, C37.2, C38.2, C39.2, C40.2, C41.2, C42.2, C43.2, C44.2, C45.2, D2.1 (K), D3.1 (K), J1.A1 (GND), J1.A12 (GND), J1.B1 (GND), J1.B12 (GND), J1.SH (SHIELD), J3.2, R1.2, R2.2, R4.2, R6.2, R11.2, SW1.2, SW2.2, SW3.2, U1.2 (GND), U2.7 (GND), U2.8 (GND), U3.3 (AGND), U3.9 (AGND), U3.14 (AGND), U3.16 (AGND), U3.19 (AGND), U3.23 (RSVD), U3.29 (GND), U3.48 (AGND), U4.19 (TESTEN), U4.57 (GND), U5.4 (GND), U6.3, U7.3 (GND), U8.4 (GND), U8.5 (A2), U8.6 (A1), U8.7 (A0), Y1.2 (GND), Y1.4 (GND), Y2.2, Y2.4
VBUS: D1.2 (A), J1.A4 (VBUS), J1.A9 (VBUS), J1.B4 (VBUS), J1.B9 (VBUS), R3.1, TP1.1
VSYS: C1.1, C2.1, C3.1, D1.1 (K), TP2.1, U1.1 (EN), U1.4 (VIN), U2.5 (+5V), U2.6 (+5V)

Notes on the sheet:
USB-C, VSYS and 3V3 buck
USB VBUS and the PoE module's 5 V meet on VSYS; D1 keeps PoE out of USB. TLV62569: VOUT = 0.6 V x (1 + R5/R6) = 3.33 V; 2.2 uH + 22 uF (TI table 4).
PoE: RJ45, magnetics, WIZPoE-P1 (isolated 802.3af)
Mode A: T1 line centre taps -> VC1. Mode B: spare pairs 4/5, 7/8 -> VC2; U2 rectifies both. Bob Smith: 75R + 10 nF/100 V per pair, 1 nF/2 kV to chassis. W5500 has no auto-MDIX: MDI. MDI side (J2, T1 pins 9-16, POE_*, BS*) keeps 2 mm from logic copper.
W5500 Ethernet (SPI0: GP16-GP21)
PMODE 111: auto-negotiation. Pin 23 RSVD to GND; TOCAP 4.7 uF; 1V2O 10 nF (datasheet v1.1.0). TX: 3.3R series, 49.9R to the 3V3A centre tap. RX: 6.8 nF coupling, 49.9R to C25.
RP2040, flash, clock, USB, buttons, SWD
Raspberry Pi Pico core: 12 MHz crystal, W25Q16 2 MB flash, BOOTSEL on QSPI_SS. Pin map unchanged (firmware board = pico): GP4/5 I2C0, GP16-21 W5500, GP22 factory reset, GP24 VBUS sense, GP25 status LED, GP27 MAINS_OK.
Ambient temperature, factory reset
TMP1075 at 0x48 (A0-A2 to GND), placed away from U1, U3, U4. SW3: hold 10 s for factory reset.
Mains sense, 230 VAC (rev1 circuit, unchanged)
DANGER 230 VAC: J4, F1, R33-R36, U6 inputs: 6.5 mm clearance, 6.4 mm creepage to everything else. U6 pulls SENSE low on both half cycles; C43/R37 bridge the zero crossings; U7 gives MAINS_OK (HIGH = mains).
Test pads, power flags, mounting holes
Test pads 0.5 mm, from design/tests.json (aiflow test plan).

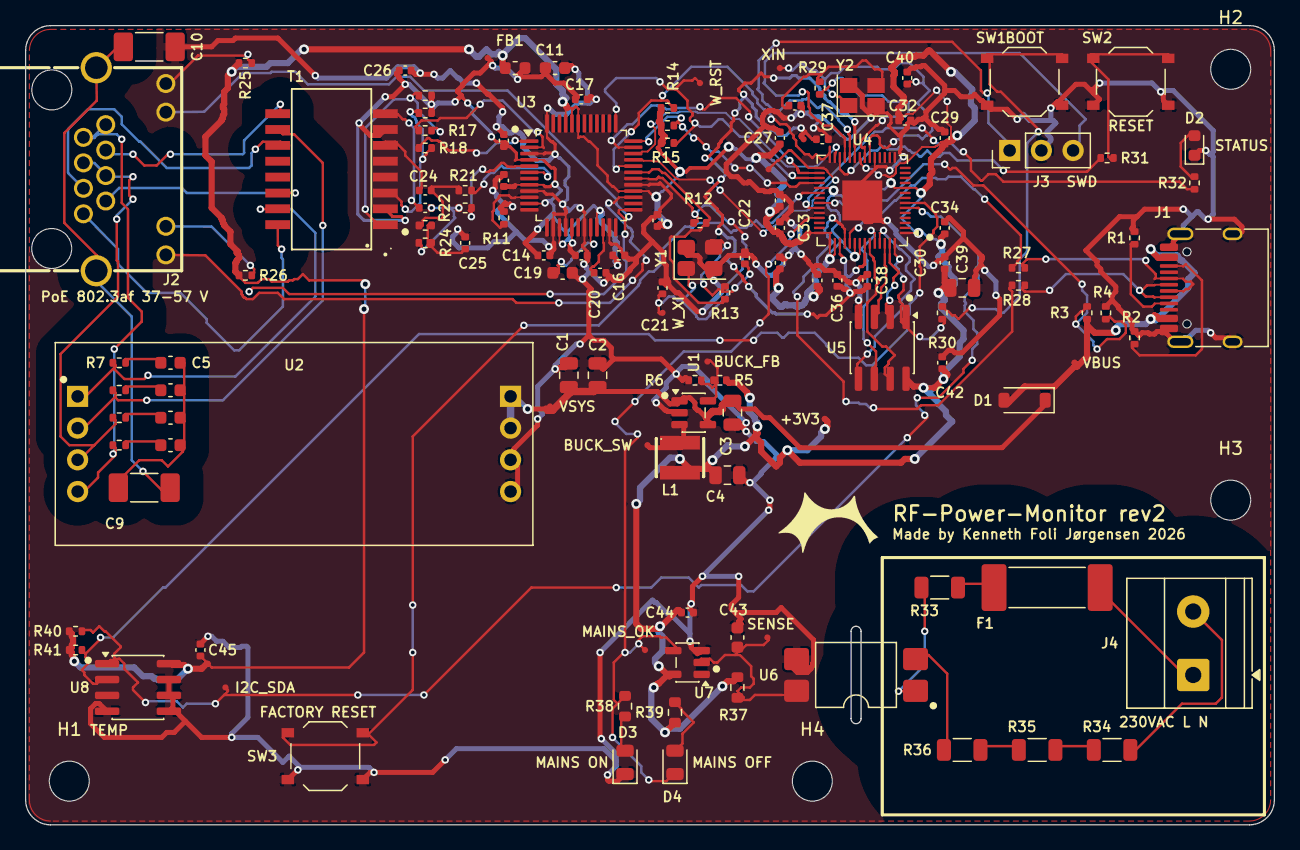
[picture p40: board rf-power-monitor-rev2.kicad_pcb from above]

Board: 2 copper layers, 100.0 x 64.0 mm, 129 parts (0 on the bottom side), 86 nets.
