TheKingOfChaos/RF-Power-Monitor/src/net_stats.cpp

#include "net_stats.h"
#include "syslog_service.h"

#include <LwipEthernet.h>
#include <SPI.h>
#include <lwip/netif.h>
#include <lwip/pbuf.h>
#include <string.h>
#include <lwip/dhcp.h>
#include <lwip/prot/dhcp.h>
#include <lwip/stats.h>
#include <lwip/ip4_frag.h>
#include <lwip/priv/tcp_priv.h>
#include "dhcp6_service.h"
#include "ipv6_static.h"
#include "lldp_service.h"
#include "diag.h"
#include "pins.h"

// W5500 common register with link, speed and duplex
static const uint16_t W5500_PHYCFGR = 0x002E;
static const uint8_t W5500_COMMON_READ = 0x00;  // block 0 (common), read, variable length

static const uint32_t PHY_POLL_MS = 500;

// Updated from lwIP context, read under the lwIP lock
static IfCounters counters = {};
static netif_input_fn originalInput = nullptr;
static netif_linkoutput_fn originalLinkOutput = nullptr;

// Updated by netStatsPoll() on core 0
static PhyStatus phy = {false, false, false};
static uint32_t lastChangeTicks = 0;
static uint8_t mac[6] = {0};
static bool started = false;
static netif* statsNetif = nullptr;
// DHCP option 224 (trap destination): requested in our DHCP messages, read from ACKs to us
static volatile bool dhcpRequestOn = false;
static DhcpTrapInfo dhcpTrap = {};
// DHCP option 225 (update server URL): the same, as text
static volatile bool dhcpUrlRequestOn = false;
static char dhcpUpdateUrl[128] = "";
// DHCP option 7 (log server): the same, first IPv4 address
static volatile bool dhcpLogRequestOn = false;
static bool dhcpHasLogServer = false;
static uint8_t dhcpLogServer[4] = {0};

static bool isWaitingForAck(uint8_t state) {
    return state == DHCP_STATE_REQUESTING || state == DHCP_STATE_REBOOTING || state == DHCP_STATE_RENEWING ||
           state == DHCP_STATE_REBINDING;
}

/**
 * @brief Use a DHCPACK's option 224 only if lwIP accepted that ACK
 *
 * Anyone on the LAN can send a frame that looks like an ACK for this MAC, and
 * traps carry the SNMP community, so a forged option 224 would leak it. The
 * value is taken only when lwIP was waiting for an ACK, the frame has lwIP's
 * current transaction id and, if lwIP already knows the server, its server id,
 * and lwIP went to BOUND while processing this very frame.
 */
static err_t inputWithDhcpAck(struct pbuf* p, struct netif* nif) {
    DhcpAckInfo info;
    DhcpAck r = dhcpReadAck((const uint8_t*)p->payload, p->len, mac, DHCP_OPTION_TRAP_TARGET, info);
    struct dhcp* dhcp = netif_dhcp_data(nif);
    if ((r != DhcpAck::Option && r != DhcpAck::NoOption) || dhcp == nullptr) return originalInput(p, nif);

    bool candidate = isWaitingForAck(dhcp->state) && info.xid == dhcp->xid;
    if (candidate && info.hasServerId && !ip_addr_isany_val(dhcp->server_ip_addr)) {
        candidate = memcmp(info.serverId, &ip_2_ip4(&dhcp->server_ip_addr)->addr, 4) == 0;
    }
    char url[sizeof(dhcpUpdateUrl)];  // read before lwIP owns p
    bool hasUrl = candidate && dhcpAckText((const uint8_t*)p->payload, p->len, DHCP_OPTION_UPDATE_URL, url, sizeof(url));
    DhcpAckInfo logInfo;
    bool hasLog = candidate && dhcpReadAckFirstAddress((const uint8_t*)p->payload, p->len, mac,
                                                       DHCP_OPTION_LOG_SERVER, logInfo) == DhcpAck::Option;
    err_t err = originalInput(p, nif);  // lwIP handles the ACK now (p belongs to lwIP afterwards)
    if (!candidate || dhcp->state != DHCP_STATE_BOUND) {
        dhcpTrap.ignored++;
        return err;
    }
    dhcpTrap.acks++;
    dhcpTrap.seen = true;
    dhcpTrap.hasOption = r == DhcpAck::Option;
    if (dhcpTrap.hasOption) memcpy(dhcpTrap.target, info.value, 4);
    memcpy(dhcpTrap.yiaddr, info.yiaddr, 4);
    dhcpTrap.ackMs = millis();
    // Every accepted ACK replaces the URL: one without option 225 clears it
    if (hasUrl) {
        memcpy(dhcpUpdateUrl, url, sizeof(dhcpUpdateUrl));
    } else {
        dhcpUpdateUrl[0] = '\0';
    }
    // ... and the log server: one without option 7 clears it
    dhcpHasLogServer = hasLog;
    if (hasLog) memcpy(dhcpLogServer, logInfo.value, 4);
    return err;
}

/// Received frame: count, then hand to lwIP as before (it drops what it cannot use)
static err_t countingInput(struct pbuf* p, struct netif* nif) {
    // The driver allocates one contiguous pbuf per frame (PBUF_RAM), so payload holds the header
    if (p == nullptr) return originalInput(p, nif);
    DIAG_HOOK(100);
    ifCountReceived(counters, (const uint8_t*)p->payload, p->len, LWIP_IPV6 != 0);
    dhcp6InspectFrame((const uint8_t*)p->payload, p->len);  // router advertisements, DHCPv6 replies; lwIP still gets it
    lldpInspectFrame((const uint8_t*)p->payload, p->len);   // the switch's LLDPDUs; lwIP drops them
    err_t err = inputWithDhcpAck(p, nif);
    DIAG_HOOK(101);
    return err;
}

void netStatsCountDiscard(uint16_t length) {
    ifCountDiscard(counters, length);
}

/// Frame to send: ask for option 224 in our DHCP messages, hand to the driver, count the result
static err_t countingLinkOutput(struct netif* nif, struct pbuf* p) {
    DIAG_HOOK(200);
    // lwIP builds each DHCP message in one pbuf (LWIP_NETIF_TX_SINGLE_PBUF), freed after sending
    if (dhcpRequestOn && p->next == nullptr &&
        dhcpRequestOption((uint8_t*)p->payload, p->len, DHCP_OPTION_TRAP_TARGET) == DhcpEdit::Added) {
        dhcpTrap.requests++;
    }
    if (dhcpUrlRequestOn && p->next == nullptr) {
        dhcpRequestOption((uint8_t*)p->payload, p->len, DHCP_OPTION_UPDATE_URL);
    }
    if (dhcpLogRequestOn && p->next == nullptr) {
        dhcpRequestOption((uint8_t*)p->payload, p->len, DHCP_OPTION_LOG_SERVER);
    }
    err_t err = originalLinkOutput(nif, p);
    if (err == ERR_OK) {
        ifCountFrame(counters, (const uint8_t*)p->payload, p->tot_len, true);
    } else {
        counters.outErrors++;
    }
    DIAG_HOOK(201);
    return err;
}

/**
 * @brief Read PHYCFGR over SPI. The driver keeps this register private, so it
 *        is read directly, holding the same lock the driver uses for its own access.
 */
static uint8_t readPhyCfgr() {
    DriverLock lock;
    digitalWrite(W5500_CS_PIN, LOW);
    SPI.transfer((uint8_t)(W5500_PHYCFGR >> 8));
    SPI.transfer((uint8_t)(W5500_PHYCFGR & 0xFF));
    SPI.transfer(W5500_COMMON_READ);
    uint8_t value = SPI.transfer(0x00);
    digitalWrite(W5500_CS_PIN, HIGH);
    return value;
}

void netStatsBegin(netif* nif) {
    if (nif == nullptr || started) return;
    DriverLock lock;
    originalInput = nif->input;
    originalLinkOutput = nif->linkoutput;
    nif->input = countingInput;
    nif->linkoutput = countingLinkOutput;
    memcpy(mac, nif->hwaddr, 6);
    statsNetif = nif;
    started = true;
}

bool netStatsSendFrame(const uint8_t* frame, size_t len) {
    DriverLock lock;
    if (!started || len == 0 || len > 0xFFFF) return false;
    pbuf* p = pbuf_alloc(PBUF_RAW, (u16_t)len, PBUF_RAM);
    if (p == nullptr) return false;
    pbuf_take(p, frame, (u16_t)len);
    err_t err = countingLinkOutput(statsNetif, p);  // counted like every other frame
    pbuf_free(p);
    return err == ERR_OK;
}

void netStatsPoll(uint32_t uptimeTicks) {
    static uint32_t lastPoll = 0;
    if (!started || millis() - lastPoll < PHY_POLL_MS) return;
    lastPoll = millis();

    PhyStatus now = decodePhyCfgr(readPhyCfgr());
    if (now.linkUp != phy.linkUp) {
        lastChangeTicks = uptimeTicks;
        Serial.printf("\r\nEthernet link %s", now.linkUp ? "up" : "down");
        if (now.linkUp) Serial.printf(", %s Mbit/s %s duplex", now.speed100 ? "100" : "10",
                                      now.fullDuplex ? "full" : "half");
        Serial.println();
        if (now.linkUp) {
            syslogEvent(SyslogSeverity::Notice, "NETWORK", "Ethernet link up, %s Mbit/s %s duplex",
                        now.speed100 ? "100" : "10", now.fullDuplex ? "full" : "half");
        } else {
            syslogEvent(SyslogSeverity::Warning, "NETWORK", "Ethernet link down");
        }
    }
    phy = now;
}

void netStatsCapture(SnmpInterfaceState& out) {
    {
        DriverLock lock;  // counters are written from lwIP context
        out.counters = counters;
    }
    out.linkUp = phy.linkUp;
    out.speedBps = phySpeedBps(phy);
    memcpy(out.mac, mac, 6);
    out.lastChangeTicks = lastChangeTicks;
}

void netStatsCaptureProto(SnmpProtoCounters& out) {
    DriverLock lock;  // lwIP counts in its own context, and owns the TCP connection list
    const stats_mib2& m = lwip_stats.mib2;
    out.ipInReceives = m.ipinreceives;
    out.ipInHdrErrors = m.ipinhdrerrors;
    out.ipInAddrErrors = m.ipinaddrerrors;
    out.ipForwDatagrams = m.ipforwdatagrams;
    out.ipInUnknownProtos = m.ipinunknownprotos;
    out.ipInDiscards = m.ipindiscards;
    out.ipInDelivers = m.ipindelivers;
    out.ipOutRequests = m.ipoutrequests;
    out.ipOutDiscards = m.ipoutdiscards;
    out.ipOutNoRoutes = m.ipoutnoroutes;
    out.ipReasmReqds = m.ipreasmreqds;
    out.ipReasmOKs = m.ipreasmoks;
    out.ipReasmFails = m.ipreasmfails;
    out.ipFragOKs = m.ipfragoks;
    out.ipFragFails = m.ipfragfails;
    out.ipFragCreates = m.ipfragcreates;
    out.ipRoutingDiscards = 0;  // lwIP has no such counter; it does not route

    // icmpIn: Msgs, Errors, DestUnreachs, TimeExcds, ParmProbs, SrcQuenchs, Redirects, Echos, EchoReps,
    // Timestamps, TimestampReps, AddrMasks, AddrMaskReps
    const uint32_t in[13] = {m.icmpinmsgs,      m.icmpinerrors,       m.icmpindestunreachs, m.icmpintimeexcds,
                             m.icmpinparmprobs, m.icmpinsrcquenchs,   m.icmpinredirects,    m.icmpinechos,
                             m.icmpinechoreps,  m.icmpintimestamps,   m.icmpintimestampreps, m.icmpinaddrmasks,
                             m.icmpinaddrmaskreps};
    memcpy(out.icmpIn, in, sizeof(in));
    // icmpOut in the same order; lwIP never sends the other types, so their counters are truly 0
    memset(out.icmpOut, 0, sizeof(out.icmpOut));
    out.icmpOut[0] = m.icmpoutmsgs;
    out.icmpOut[1] = m.icmpouterrors;
    out.icmpOut[2] = m.icmpoutdestunreachs;
    out.icmpOut[3] = m.icmpouttimeexcds;
    out.icmpOut[7] = m.icmpoutechos;
    out.icmpOut[8] = m.icmpoutechoreps;

    out.tcpActiveOpens = m.tcpactiveopens;
    out.tcpPassiveOpens = m.tcppassiveopens;
    out.tcpAttemptFails = m.tcpattemptfails;
    out.tcpEstabResets = m.tcpestabresets;
    out.tcpInSegs = m.tcpinsegs;
    out.tcpOutSegs = m.tcpoutsegs;
    out.tcpRetransSegs = m.tcpretranssegs;
    out.tcpInErrs = m.tcpinerrs;
    out.tcpOutRsts = m.tcpoutrsts;
    uint32_t established = 0;
    for (tcp_pcb* pcb = tcp_active_pcbs; pcb != nullptr; pcb = pcb->next) {
        if (pcb->state == ESTABLISHED || pcb->state == CLOSE_WAIT) established++;
    }
    out.tcpCurrEstab = established;

    out.udpInDatagrams = m.udpindatagrams;
    out.udpNoPorts = m.udpnoports;
    out.udpInErrors = m.udpinerrors;
    out.udpOutDatagrams = m.udpoutdatagrams;

    out.ipDefaultTtl = IP_DEFAULT_TTL;
    out.ipReasmTimeoutS = IP_REASS_MAXAGE * IP_TMR_INTERVAL / 1000;
    out.tcpRtoMinMs = 1000;   // lwIP's snmp_mib2_tcp.c reports these two as nominal values
    out.tcpRtoMaxMs = 60000;
    out.tcpMaxConn = MEMP_NUM_TCP_PCB;
}

void netStatsCaptureAddresses(SnmpIpState& out) {
    memset(&out, 0, sizeof(out));
    // lwIP holds at most IP_REASS_MAX_PBUFS fragments for reassembly: full-size ones carry 1480 bytes
    out.reasmMaxSize = IP_REASS_MAX_PBUFS * (1500 - 20) + 20;
    if (statsNetif == nullptr) return;
    DriverLock lock;  // lwIP changes the addresses in its own context (DHCP, SLAAC, DAD)
    const ip4_addr_t* v4 = netif_ip4_addr(statsNetif);
    if (!ip4_addr_isany(v4)) {
        SnmpIpAddress& a = out.addr[out.count++];
        a.ipv6 = false;
        memcpy(a.addr, &v4->addr, 4);  // network byte order
        uint32_t mask = lwip_ntohl(netif_ip4_netmask(statsNetif)->addr);
        a.prefixLen = 0;
        while (a.prefixLen < 32 && (mask & (0x80000000u >> a.prefixLen))) a.prefixLen++;
        a.origin = dhcp_supplied_address(statsNetif) ? SnmpAddrOrigin::Dhcp : SnmpAddrOrigin::Manual;
        a.preferred = true;
    }
#if LWIP_IPV6
    for (int i = 0; i < LWIP_IPV6_NUM_ADDRESSES && out.count < SNMP_MAX_IP_ADDRESSES; i++) {
        uint8_t state = netif_ip6_addr_state(statsNetif, i);
        if (!ip6_addr_isvalid(state)) continue;  // empty, tentative or duplicate: not usable
        SnmpIpAddress& a = out.addr[out.count++];
        a.ipv6 = true;
        memcpy(a.addr, netif_ip6_addr(statsNetif, i)->addr, 16);  // words in network order
        a.prefixLen = 64;  // link-local, SLAAC and the static address are /64; lwIP keeps no prefix length
        // Link-local and SLAAC addresses are formed from the MAC (EUI-64): linklayer
        a.origin = ipv6StaticIsSlot(i) ? SnmpAddrOrigin::Manual
                   : dhcp6IsSlot(i)    ? SnmpAddrOrigin::Dhcp
                                       : SnmpAddrOrigin::LinkLayer;
        a.preferred = ip6_addr_ispreferred(state);
    }
#endif
}

bool netStatsHasRoutableIPv6() {
    if (statsNetif == nullptr) return false;
    for (int i = 0; i < LWIP_IPV6_NUM_ADDRESSES; i++) {
        if (ip6_addr_isvalid(netif_ip6_addr_state(statsNetif, i)) && !ip6_addr_islinklocal(netif_ip6_addr(statsNetif, i))) {
            return true;
        }
    }
    return false;
}

PhyStatus netStatsPhy() {
    return phy;
}

void netStatsRequestDhcpTrapTarget(bool on) {
    DriverLock lock;
    bool changed = dhcpRequestOn != on;
    dhcpRequestOn = on;
    if (!changed || !on) return;
    // Ask now instead of at the next renewal (lease time / 2)
    for (netif* n = netif_list; n != nullptr; n = n->next) {
        if (dhcp_supplied_address(n)) dhcp_renew(n);  // only with a bound lease
    }
}

DhcpTrapInfo netStatsDhcpTrap() {
    DriverLock lock;  // written from lwIP context
    return dhcpTrap;
}

void netStatsRequestDhcpUpdateUrl(bool on) {
    DriverLock lock;
    bool changed = dhcpUrlRequestOn != on;
    dhcpUrlRequestOn = on;
    if (!changed || !on) return;
    for (netif* n = netif_list; n != nullptr; n = n->next) {
        if (dhcp_supplied_address(n)) dhcp_renew(n);  // ask now, not at the next renewal
    }
}

void netStatsRequestDhcpLogServer(bool on) {
    DriverLock lock;
    bool changed = dhcpLogRequestOn != on;
    dhcpLogRequestOn = on;
    if (!changed) return;
    dhcpHasLogServer = false;  // an old lease's value must not be used: only the next accepted ACK counts
    if (!on) return;
    for (netif* n = netif_list; n != nullptr; n = n->next) {
        if (dhcp_supplied_address(n)) dhcp_renew(n);  // ask now, not at the next renewal
    }
}

bool netStatsDhcpLogServer(uint8_t out[4]) {
    DriverLock lock;  // written from lwIP context
    memcpy(out, dhcpLogServer, 4);
    return dhcpHasLogServer;
}

bool netStatsDhcpUpdateUrl(char* out, size_t size) {
    DriverLock lock;  // written from lwIP context
    snprintf(out, size, "%s", dhcpUpdateUrl);
    return out[0] != '\0';
}
