TheKingOfChaos/RF-Power-Monitor/src/watchdog.h

#pragma once

/**
 * @file watchdog.h
 * @brief Hardware watchdog in every build: a hang on either core restarts the device.
 *
 * The boot program (boot/) arms the watchdog before it starts the firmware;
 * setup() takes it over at once and feeds it while it starts up, so a hang in
 * setup() also restarts the device. From the end of setup() core 0 feeds it
 * from loop(), but only while core 1 keeps moving its heartbeat
 * (lib/watchdog_logic). The restart cause and the number of watchdog restarts
 * since power-on are shown at boot and on the status screen.
 */

#include <stdint.h>
#include <watchdog_logic.h>

/// Watchdog timeout; the RP2040 allows at most ~8.3 s
constexpr uint32_t WATCHDOG_TIMEOUT_MS = 8000;

/// Record why this start happened (from the boot program, fwUpdateRestartCause()) and take over the
/// watchdog (WATCHDOG_TIMEOUT_MS). Call first in setup(), right after bootInfoBegin() and before
/// fwUpdateBegin() and diagBegin().
void watchdogBegin();
/// Print the restart cause (after the serial terminal wait)
void watchdogPrintCause();
/// Feed the watchdog during setup(), between steps that can take long
void watchdogFeed();
/// Start watching core 1 and feed only while it is alive. Call at the end of setup().
void watchdogArm();
/// Feed the watchdog while core 1 is alive. Call every loop() on core 0.
void watchdogPoll();
/// Core 1's heartbeat. Call every loop1().
void watchdogCore1Beat();

/// Why the device last started
RestartCause watchdogRestartCause();
/// Watchdog restarts since power-on, including the last start
uint32_t watchdogRestarts();

/// Test hook (hidden serial command): stop core 0 or core 1 for good, so the watchdog restarts the device
void watchdogStall(uint8_t core);
