TheKingOfChaos/RF-Power-Monitor/librenms/test/compose.yml

# Throw-away LibreNMS to check the RF-Power-Monitor definitions (based on librenms/docker examples/compose)
name: lnms-test

x-env: &env
  TZ: Europe/Copenhagen
  PUID: "1000"
  PGID: "1000"
  DB_HOST: db
  DB_NAME: librenms
  DB_USER: librenms
  DB_PASSWORD: librenms-test
  DB_TIMEOUT: "60"
  REDIS_HOST: redis
  CACHE_DRIVER: redis
  SESSION_DRIVER: redis
  LIBRENMS_SNMP_COMMUNITY: public

services:
  db:
    image: mariadb:10.11
    command: [mysqld, --innodb-file-per-table=1, --lower-case-table-names=0,
              --character-set-server=utf8mb4, --collation-server=utf8mb4_unicode_ci]
    environment:
      # Same zone as the LibreNMS containers: LibreNMS stores times such as last_polled in local time
      # and the dispatcher compares them with the database's NOW(). With the database on UTC, every
      # device looked polled an hour in the future and was polled only about once an hour.
      TZ: Europe/Copenhagen
      MARIADB_RANDOM_ROOT_PASSWORD: "yes"
      MYSQL_DATABASE: librenms
      MYSQL_USER: librenms
      MYSQL_PASSWORD: librenms-test
    volumes: [db:/var/lib/mysql]

  redis:
    image: redis:7.2-alpine

  librenms:
    image: librenms/librenms:latest
    cap_add: [NET_ADMIN, NET_RAW]
    depends_on: [db, redis]
    ports: ["8070:8000"]
    environment: *env
    volumes:
      - data:/data
      - ${REPO:-../..}/librenms/os_detection/rfpowermonitor.yaml:/opt/librenms/resources/definitions/os_detection/rfpowermonitor.yaml:ro
      - ${REPO:-../..}/librenms/os_discovery/rfpowermonitor.yaml:/opt/librenms/resources/definitions/os_discovery/rfpowermonitor.yaml:ro
      - ${REPO:-../..}/mibs/RF-POWER-MONITOR-MIB.txt:/opt/librenms/mibs/rfpowermonitor/RF-POWER-MONITOR-MIB:ro
      - ${REPO:-../..}/librenms/images/os/rfpowermonitor.svg:/opt/librenms/html/images/os/rfpowermonitor.svg:ro
      - ${REPO:-../..}/librenms/images/logos/rfpowermonitor.svg:/opt/librenms/html/images/logos/rfpowermonitor.svg:ro
      # "Switch" box on the device Overview (only the web container renders it)
      - ${REPO:-../..}/librenms/plugins/RFPowerMonitor:/opt/librenms/app/Plugins/RFPowerMonitor:ro

  dispatcher:
    image: librenms/librenms:latest
    cap_add: [NET_ADMIN, NET_RAW]
    depends_on: [librenms]
    environment:
      <<: *env
      DISPATCHER_NODE_ID: dispatcher1
      SIDECAR_DISPATCHER: "1"
    volumes:
      - data:/data
      - ${REPO:-../..}/librenms/os_detection/rfpowermonitor.yaml:/opt/librenms/resources/definitions/os_detection/rfpowermonitor.yaml:ro
      - ${REPO:-../..}/librenms/os_discovery/rfpowermonitor.yaml:/opt/librenms/resources/definitions/os_discovery/rfpowermonitor.yaml:ro
      - ${REPO:-../..}/mibs/RF-POWER-MONITOR-MIB.txt:/opt/librenms/mibs/rfpowermonitor/RF-POWER-MONITOR-MIB:ro
      # The poller sets the device icon and checks that the file exists
      - ${REPO:-../..}/librenms/images/os/rfpowermonitor.svg:/opt/librenms/html/images/os/rfpowermonitor.svg:ro
      - ${REPO:-../..}/librenms/images/logos/rfpowermonitor.svg:/opt/librenms/html/images/logos/rfpowermonitor.svg:ro

  # Trap receiver on UDP 162: set the device's trap destination to this host. Docker Desktop
  # hides the sender's address; snmptrap-agent-addr.php takes it from the trap instead (v1
  # agent-addr, v2c snmpTrapAddress.0). Only traps with TRAP_COMMUNITY (default public) are accepted
  snmptrapd:
    image: librenms/librenms:latest
    cap_add: [NET_ADMIN, NET_RAW]
    depends_on: [librenms]
    ports: ["162:162/udp"]
    environment:
      <<: *env
      SIDECAR_SNMPTRAPD: "1"
      LIBRENMS_SNMP_COMMUNITY: ${TRAP_COMMUNITY:-public}
      SNMP_DISABLE_AUTHORIZATION: "no"
    volumes:
      - data:/data
      - ${REPO:-../..}/librenms/test/snmptrap-agent-addr.php:/opt/librenms/snmptrap.php:ro
      - ${REPO:-../..}/librenms/os_detection/rfpowermonitor.yaml:/opt/librenms/resources/definitions/os_detection/rfpowermonitor.yaml:ro
      - ${REPO:-../..}/librenms/os_discovery/rfpowermonitor.yaml:/opt/librenms/resources/definitions/os_discovery/rfpowermonitor.yaml:ro
      # snmptrapd only searches mibs/ and mibs/cisco/, so the trap names need the MIB at the top
      - ${REPO:-../..}/mibs/RF-POWER-MONITOR-MIB.txt:/opt/librenms/mibs/RF-POWER-MONITOR-MIB:ro

  # Syslog receiver (3.6.0): set the device's syslog server (menu option 11) to this host, port
  # 5140 (10.132.0.45:5140). The device sends RFC 5424, which the image's port 514 source does not
  # parse; syslog-ng-rfc5424.conf adds a source for it on 5140. Docker Desktop hides the sender's
  # address, so syslog-ng keeps the HOSTNAME from the message and LibreNMS files it under the
  # device with that sysName. LibreNMS stores syslog only with enable_syslog on
  # (lnms config:set enable_syslog true)
  syslogng:
    image: librenms/librenms:latest
    cap_add: [NET_ADMIN, NET_RAW]
    depends_on: [librenms]
    ports: ["514:514/udp", "514:514/tcp", "5140:5140/udp"]
    environment:
      <<: *env
      SIDECAR_SYSLOGNG: "1"
    volumes:
      - data:/data
      - ${REPO:-../..}/librenms/test/syslog-ng-rfc5424.conf:/data/syslog-ng/rfc5424.conf:ro

volumes:
  db:
  data:

# IPv6 for the containers (Docker NATs it to the host), so LibreNMS can poll the device over
# IPv6. From WSL this needs networkingMode=mirrored in .wslconfig (NAT mode has no IPv6 route).
networks:
  default:
    enable_ipv6: true
