TheKingOfChaos/RF-Power-Monitor/test/hil/test_update_server.py

"""Hardware-in-the-loop tests for the update site: check-ins and firmware updates
chosen on the site, end to end with the real firmware.

Opt-in: they run the site (update-server/, python -m rfupdate) on this PC with a
temporary data directory and a new shared key, point the device at it, and
install a development-signed test build (tools/fw_release.py --test-version
3.4.1-hil, built on first use into .pio/fwtest/). The device ends on the
firmware version it started with (development-signed, slot A or B), with its
own update server setting back. A device with an update server key is skipped
unless RFPOWER_UPDATE_KEY holds that key (the device never shows it back).

Run (firmware already flashed, PuTTY closed):
    set RFPOWER_UPDATE_SERVER_TEST=1
    %USERPROFILE%\\.platformio\\penv\\Scripts\\python.exe -m unittest test/hil/test_update_server.py -v

Environment variables:
    RFPOWER_UPDATE_SERVER_TEST=1    run these tests
    RFPOWER_UPDATE_SERVER_HOST      this PC's address as the device reaches it (default: found from the route)
    RFPOWER_UPDATE_SERVER_PORT      port for the test site (default 8072)
    RFPOWER_SNMP_COMMUNITY          the device's SNMP community (default public)
The device must reach this PC on that TCP port (Windows firewall).
"""

import os
import re
import shutil
import socket
import subprocess
import sys
import tempfile
import time
import unittest

from device import Device
import snmp_tools

ROOT = os.path.dirname(os.path.dirname(os.path.dirname(os.path.abspath(__file__))))
sys.path.insert(0, os.path.join(ROOT, "update-server"))
sys.path.insert(0, os.path.join(ROOT, "tools"))
from rfupdate.store import Store  # noqa: E402
import fwtool  # noqa: E402

ENABLED = os.environ.get("RFPOWER_UPDATE_SERVER_TEST") == "1"
PORT = int(os.environ.get("RFPOWER_UPDATE_SERVER_PORT", "8072"))
COMMUNITY = os.environ.get("RFPOWER_SNMP_COMMUNITY", "public")
TEST_VERSION = "3.4.1-hil"
SITE_PASSWORD = "hil-only"


def newest_source_mtime():
    """Newest modification time of the firmware's sources (a cached test build older than this is stale)."""
    newest = os.path.getmtime(os.path.join(ROOT, "platformio.ini"))
    for top in ("src", "lib", "include", "boot", "scripts"):
        for dirpath, _, files in os.walk(os.path.join(ROOT, top)):
            for name in files:
                newest = max(newest, os.path.getmtime(os.path.join(dirpath, name)))
    return newest


def build_release(version):
    """A development-signed .upd built as this version (cached in .pio/fwtest/ while newer than the sources:
    the test ends by installing the current version from here, so a stale one would leave old firmware)."""
    path = os.path.join(ROOT, ".pio", "fwtest", version + ".upd")
    if not os.path.exists(path) or os.path.getmtime(path) < newest_source_mtime():
        subprocess.run([sys.executable, os.path.join(ROOT, "tools", "fw_release.py"), "--test-version", version],
                       cwd=ROOT, check=True)
    with open(path, "rb") as f:
        return f.read()


def stop_process_tree(proc):
    """Stop the site and its children (the PlatformIO python.exe is a launcher that starts another)."""
    if proc.poll() is not None:
        return
    if os.name == "nt":
        subprocess.run(["taskkill", "/F", "/T", "/PID", str(proc.pid)], capture_output=True)
    else:
        proc.terminate()
    proc.wait(10)


def flip_signatures(data):
    """The same .upd with one byte of each slot's Ed25519 signature changed."""
    import struct
    _, _, _, off_a, off_b, _, _ = struct.unpack_from("<II16s4I", data, 0)
    out = bytearray(data)
    for off in (off_a, off_b):
        out[off + 10] ^= 0x01
    return bytes(out)


@unittest.skipUnless(ENABLED, "set RFPOWER_UPDATE_SERVER_TEST=1 (runs a test site on this PC and updates the device)")
class UpdateServerTest(unittest.TestCase):

    @classmethod
    def setUpClass(cls):
        cls.site = None
        cls.saved_update_server = None  # the device's own setting, put back at the end
        try:
            cls._set_up()
        except BaseException:
            cls._clean_up()
            raise

    @classmethod
    def _set_up(cls):
        cls.release_version = fwtool.firmware_version()
        cls.dev = Device()
        cls.dev.open()
        cls.dev.wait_for_menu()
        st = cls.dev.wait_connected()
        if st["fwVersion"] != cls.release_version or st["fwState"] != "kept":
            cls.dev.close()
            raise unittest.SkipTest("the device must run %s, kept (it runs %s, %s)"
                                    % (cls.release_version, st["fwVersion"], st["fwState"]))
        cls.ip = st["ip"]
        cls.saved_update_server = cls.dev.save_update_server()  # SkipTest when its key cannot be restored
        cls.good = build_release(TEST_VERSION)
        cls.back = build_release(cls.release_version)
        cls.data = tempfile.mkdtemp(prefix="rfupdate-hil-")
        store = Store(cls.data)
        cls.key = store.new_site_key()
        store.close()
        env = dict(os.environ, RFUPDATE_ADMIN_PASSWORD=SITE_PASSWORD)
        cls.site = subprocess.Popen([sys.executable, "-m", "rfupdate", "--host", "0.0.0.0", "--port", str(PORT),
                                     "--data", cls.data], cwd=os.path.join(ROOT, "update-server"), env=env,
                                    stdout=subprocess.DEVNULL, stderr=subprocess.DEVNULL)
        deadline = time.time() + 10
        while True:
            if cls.site.poll() is not None:  # e.g. the port is taken (the site never shares it)
                raise RuntimeError("the test site did not start; is something else on port %d?" % PORT)
            try:
                socket.create_connection(("127.0.0.1", PORT), timeout=1).close()
                break
            except OSError:
                if time.time() > deadline:
                    raise
                time.sleep(0.2)
        host = os.environ.get("RFPOWER_UPDATE_SERVER_HOST") or snmp_tools.local_ip_towards(cls.ip)
        cls.url = "http://%s:%d" % (host, PORT)
        out = cls.dev.set_update_server(cls.url, cls.key.hex())
        assert "saved" in out, out
        cls.dev.send("checkin", expect=r"checkin: requested")  # the device appears on the site
        deadline = time.time() + 30
        while not re.search(r"last check-in \d+ s ago: ok", cls.dev.update_server_line() or ""):
            if time.time() > deadline:
                raise AssertionError("first check-in failed: %s" % cls.dev.update_server_line())
            time.sleep(1)

    @classmethod
    def tearDownClass(cls):
        cls._clean_up()

    @classmethod
    def _clean_up(cls):
        try:
            if getattr(cls, "dev", None) is not None and cls.dev.ser is not None and cls.saved_update_server:
                cls.dev.set_update_server(*cls.saved_update_server)
        finally:
            if getattr(cls, "dev", None) is not None:
                cls.dev.close()
            if cls.site is not None:
                stop_process_tree(cls.site)
            if getattr(cls, "data", None):
                shutil.rmtree(cls.data, ignore_errors=True)

    def setUp(self):
        self.dev.wait_for_menu(timeout=10)

    # --- helpers ---

    def store(self):
        return Store(self.data)

    def row(self):
        store = self.store()
        try:
            rows = store.device_rows(time.time())
        finally:
            store.close()
        self.assertEqual(1, len(rows), rows)
        return rows[0]

    def put_release(self, data):
        """Upload data as a release (replacing an unassigned one with the same version)."""
        store = self.store()
        try:
            for r in store.releases():
                try:
                    store.delete_release(r["version"])
                except ValueError:
                    pass
            return store.add_release(data, time.time())
        finally:
            store.close()

    def assign(self, version):
        store = self.store()
        try:
            store.assign([self.row()["serial"]], version, time.time())
        finally:
            store.close()

    def checkin(self, expect, timeout=40):
        """Ask for a check-in now (hidden command) and wait until the status line shows
        a check-in that ended after it, matching expect; returns that line."""
        self.dev.send("checkin", expect=r"checkin: requested")
        start = time.time()
        line = ""
        while time.time() - start < timeout:
            line = self.dev.update_server_line() or ""
            m = re.search(r"last check-in (\d+) s ago: (.*)$", line)
            if m and int(m.group(1)) <= time.time() - start + 1 and re.search(expect, m.group(2)):
                return line
            time.sleep(1)
        self.fail("no check-in matching %r within %d s: %s" % (expect, timeout, line))

    def wait_restart_and_keep(self, version):
        """After a verified download: the device restarts into version on trial; a check-in
        confirms it, the next one reports it kept."""
        try:
            self.dev.read_until(r"restarting into it on trial", timeout=120)
        except TimeoutError:
            pass  # the port can drop with the restart before the line is read; the version below decides
        st = self.dev.reconnect_after_reboot(timeout=60)
        self.assertEqual(version, st["fwVersion"])
        self.checkin(r"^ok$")  # an authenticated reply: the trial is confirmed
        deadline = time.time() + 20
        while self.dev.status()["fwState"] != "kept":
            self.assertLess(time.time(), deadline, "trial not confirmed")
            time.sleep(1)
        self.checkin(r"^ok$")  # reports the kept firmware

    # --- tests ---

    def test_checkin_appears_on_site(self):
        self.checkin(r"^ok$")
        r = self.row()
        self.assertEqual(self.ip, r["ipv4"])
        self.assertEqual(self.release_version, r["version"])
        self.assertTrue(r["online"])
        self.assertTrue(r["hostname"])
        self.assertRegex(r["serial"], r"^[0-9A-F]{16}$")

    def test_wrong_key_shows_badauth(self):
        try:
            self.assertIn("saved", self.dev.set_update_server("", "00" * 32))
            self.checkin(r"^badauth$")
        finally:
            self.dev.set_update_server("", self.key.hex())
        self.checkin(r"^ok$")

    def test_checkin_unreachable_server_keeps_snmp_answering(self):
        closed = re.sub(r":\d+$", ":8099", self.url)
        try:
            self.dev.set_update_server(closed, "")
            self.dev.send("checkin", expect=r"checkin: requested")
            times = []
            for i in range(20):
                resp, sec = snmp_tools.raw_get(self.ip, 1000 + i, timeout=1.0,
                                               packet=snmp_tools.get_sysdescr_packet(COMMUNITY))
                self.assertIsNotNone(resp, "SNMP request %d not answered" % i)
                times.append(sec)
            self.assertLess(max(times), 0.1, times)
            line = self.checkin(r"connect|reset|closed|answer|timeout")
            self.assertNotIn(": ok", line)
        finally:
            self.dev.set_update_server(self.url, "")

    def test_fetchtest_during_checkin_does_not_wedge_service(self):
        # A check-in to a port that accepts and never answers runs until its 15 s limit;
        # the hidden fetchtest must not take its connection away and leave the service stuck
        silent = socket.socket(socket.AF_INET, socket.SOCK_STREAM)
        silent.bind(("0.0.0.0", PORT + 1))
        silent.listen(4)
        try:
            self.dev.set_update_server(re.sub(r":\d+$", ":%d" % (PORT + 1), self.url), "")
            first = self.dev.send("checkin", expect=r"checkin: requested[^\n]*\n")
            time.sleep(1)
            out = self.dev.send("fetchtest " + self.url + "/", expect=r"fetchtest: \w+.*\n", timeout=15)
            self.assertNotIn("fetchtest: started", out, first)  # refused while the service is busy
            self.assertIn("fetchtest: busy", out)
            line = self.checkin(r"timeout|answer", timeout=30)  # the silent check-in ends by itself
        finally:
            self.dev.set_update_server(self.url, "")
            silent.close()
        self.checkin(r"^ok$")

    def test_settings_save_ends_a_running_checkin(self):
        # A check-in sent with the old settings would read its answer with the new key
        # ("reply not authenticated"): saving ends it, and the next one uses the new settings
        silent = socket.socket(socket.AF_INET, socket.SOCK_STREAM)
        silent.bind(("0.0.0.0", PORT + 1))
        silent.listen(4)
        try:
            self.dev.set_update_server(re.sub(r":\d+$", ":%d" % (PORT + 1), self.url), "")
            self.dev.send("checkin", expect=r"checkin: requested[^\n]*\n")
            time.sleep(1)
            busy = self.dev.send("checkin", expect=r"checkin: requested[^\n]*\n")
            self.assertIn("service checkin, fetch busy", busy)
            self.dev.set_update_server(self.url, "")
            after = self.dev.send("checkin", expect=r"checkin: requested[^\n]*\n")
            self.assertIn("service idle, fetch free", after)
        finally:
            silent.close()
        line = self.checkin(r".")
        self.assertIn(": ok", line)

    def test_firmware_page_card_sets_url_and_key(self):
        from test_web import Web
        st = self.dev.status()
        password = os.environ.get("RFPOWER_WEB_PASSWORD") or st["webDefaultPassword"]
        if not password or not st.get("webEnabled", True):
            self.skipTest("needs the web page and its password (RFPOWER_WEB_PASSWORD or the default one)")
        web = Web(self.ip)
        status, page = web.login(password)
        self.assertEqual(303, status, page)
        status, _, page = web.request("GET", "/firmware", sid=web.sid)
        self.assertEqual(200, status)
        self.assertIn('action="/updateserver"', page)
        self.assertIn("Shared key</th><td>set</td>", page)
        self.assertNotIn(self.key.hex(), page)
        csrf = re.search(r'name="csrf" value="([0-9a-f]{32})"', page).group(1)
        status, _, page = web.request("POST", "/updateserver", {"csrf": csrf, "url": "https://bad", "key": ""},
                                      sid=web.sid)
        self.assertEqual(400, status)
        # The same URL and key again, through the page: saved, and check-ins keep working
        status, _, page = web.request("POST", "/updateserver",
                                      {"csrf": csrf, "url": self.url, "key": self.key.hex()}, sid=web.sid)
        self.assertEqual(200, status, page)
        self.assertIn("Update server settings saved.", page)
        self.assertNotIn(self.key.hex(), page)
        self.checkin(r"^ok$")

    def test_corrupt_release_is_refused_and_device_keeps_running(self):
        version = self.put_release(flip_signatures(self.good))
        self.assertEqual(TEST_VERSION, version)
        self.assign(version)
        self.dev.send("checkin", expect=r"checkin: requested")
        start = time.time()
        while "refused" not in (self.dev.update_server_line() or ""):  # downloaded, then refused at the check
            self.assertLess(time.time() - start, 120, self.dev.update_server_line())
            time.sleep(2)
        self.checkin(r"^ok$")  # reports the refusal
        r = self.row()
        self.assertEqual("refused", r["update_status"])
        self.assertIn("signature", r["update_detail"])
        st = self.dev.status()
        self.assertEqual((self.release_version, "kept"), (st["fwVersion"], st["fwState"]))

    def test_assigned_release_installs_and_is_kept_then_back_to_release(self):
        self.put_release(self.good)
        self.assign(TEST_VERSION)
        self.dev.send("checkin", expect=r"checkin: requested")  # downloads, checks, restarts
        self.wait_restart_and_keep(TEST_VERSION)
        self.assertEqual("done", self.row()["update_status"])
        self.assertEqual(TEST_VERSION, self.row()["version"])

        # And back to the release through the site (an older version, chosen on purpose)
        self.put_release(self.back)
        self.assign(self.release_version)
        self.dev.send("checkin", expect=r"checkin: requested")
        self.wait_restart_and_keep(self.release_version)
        self.assertEqual("done", self.row()["update_status"])
        st = self.dev.status()
        self.assertEqual((self.release_version, "kept"), (st["fwVersion"], st["fwState"]))


if __name__ == "__main__":
    unittest.main()
