TheKingOfChaos/RF-Power-Monitor/test/hil/test_fw_update.py

"""Hardware-in-the-loop tests for the boot program and firmware slots, and for signed updates.

BootProgramTest (always runs) and FirmwareUpdateTest (opt-in, RFPOWER_FW_UPDATE_TEST=1, see
docs/TESTING.md "Firmware update tests") live here.

The boot program (boot/) verifies the firmware slot before it starts it and
tells the firmware what it did; the firmware prints it early in setup():
"Boot: slot A verified in <n> ms (normal|trial|fallback|no record)".
These tests reboot the device once (menu option 2, DHCP unchanged) and read
the boot log; settings are not touched.

Run:
    %USERPROFILE%\\.platformio\\penv\\Scripts\\python.exe -m unittest discover -s test/hil -p "test_fw_update.py" -v
"""

import http.client
import os
import re
import socket
import subprocess
import sys
import tempfile
import time
import unittest

import serial

from device import Device
from snmp_tools import TrapListener, local_ip_towards, net_snmp

ROOT = os.path.dirname(os.path.dirname(os.path.dirname(os.path.abspath(__file__))))
sys.path.insert(0, os.path.join(ROOT, "tools"))
import fw_release  # noqa: E402
import fw_update  # noqa: E402
import fwtool  # noqa: E402

BOOT_LINE = r"Boot: slot ([AB]) verified in (\d+) ms \((normal|trial|fallback|no record)\)"
VERIFY_LIMIT_MS = 1500


class BootProgramTest(unittest.TestCase):

    @classmethod
    def setUpClass(cls):
        cls.dev = Device()
        cls.dev.open()
        cls.dev.wait_for_menu()
        if cls.dev.status()["mode"] != "DHCP":
            cls.dev.close()
            raise unittest.SkipTest("reboots with option 2 (DHCP, unchanged); device is in static mode")
        cls.boot_log = cls.reboot_and_read_boot_log()

    @classmethod
    def tearDownClass(cls):
        cls.dev.wait_connected(timeout=40)
        cls.dev.close()

    @classmethod
    def reboot_and_read_boot_log(cls):
        """Reboot through the menu and return the boot log up to the first prompt."""
        d = cls.dev
        d.send("2", expect=r"\(y/n\): $")
        d.send("y", expect=r"Rebooting", timeout=10)
        d.close()
        time.sleep(1.5)
        d.open()  # the firmware waits for DTR before printing, so the boot log is captured
        return d.read_until(r"> $", timeout=10)

    def boot_line(self):
        m = re.search(BOOT_LINE, self.boot_log)
        self.assertIsNotNone(m, "no boot program line in the boot log:\n%s" % self.boot_log[:600])
        return m

    def test_boot_program_starts_the_running_slot_after_menu_reboot(self):
        m = self.boot_line()
        # The update tests leave the device in either slot: the boot program must start
        # the slot the status screen says runs (the firmware built for it)
        self.assertEqual(self.dev.status()["fwSlot"], m.group(1))
        # USB flashing writes an erased boot record; the firmware does not write one yet
        self.assertIn(m.group(3), ("no record", "normal"))

    def test_menu_reboot_reads_as_planned_restart(self):
        # The boot program arms the watchdog for every start; a menu reboot must
        # still read as a planned restart, not a watchdog (crash) restart
        self.assertRegex(self.boot_log, r"Last restart: reboot \(")

    def test_boot_verification_takes_under_1500_ms(self):
        n = int(self.boot_line().group(2))
        self.assertGreater(n, 0, "verification time not measured")
        self.assertLess(n, VERIFY_LIMIT_MS)


# ---- signed update, rollback and fallback (opt-in) ----

FW_TEST = os.environ.get("RFPOWER_FW_UPDATE_TEST") == "1"
POE_CYCLE = os.environ.get("RFPOWER_POE_CYCLE") == "1"
SWITCH_CONSOLE = os.environ.get("RFPOWER_LLDP_SWITCH_CONSOLE")
COMMUNITY = os.environ.get("RFPOWER_COMMUNITY", "public")
FWTEST_DIR = os.path.join(ROOT, ".pio", "fwtest")
OID_FW = "1.3.6.1.4.1.63050.7."          # fwUpdate group: .1 slot, .4 fwState, .5 fwLastResult
SOURCE_DIRS = ("src", "lib", "include", "boot", "scripts")
SERIAL_ERRORS = (TimeoutError, RuntimeError, OSError, serial.SerialException, AttributeError)
STACK_MIN_NEVER_USED = 1024              # as test_web.py: core 0 keeps 1 KB that was never touched

# Timing of the rollback paths (docs/TESTING.md): crash is 3 x (8.3 s watchdog + boot), an
# unreachable trial is the shorttrial variant's 60 s of network time plus two boots
CRASH_ROLLBACK_LIMIT_S = 120
UNREACHABLE_ROLLBACK_LIMIT_S = 150
TEARDOWN_LIMIT_S = 240                   # a test image rolls back within this (shorttrial: 80 s measured)


def _newest_source():
    """Newest mtime of anything a firmware build depends on."""
    newest = os.path.getmtime(os.path.join(ROOT, "platformio.ini"))
    for d in SOURCE_DIRS:
        for base, _dirs, files in os.walk(os.path.join(ROOT, d)):
            for f in files:
                newest = max(newest, os.path.getmtime(os.path.join(base, f)))
    return newest


def _fresh(path):
    return os.path.exists(path) and os.path.getmtime(path) >= _newest_source() \
        and not os.environ.get("RFPOWER_FW_REBUILD")
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
