TheKingOfChaos/RF-Power-Monitor/(commit log)

2026-10-31 Ambient temperature (TMP1075), CPU temperature, DHCP addresses on the web page
    - TMP1075 on the carrier (I2C0, GP4/GP5, 0x48): SNMP ambientTemperature
    (63050.5.0, absent while no sensor), status screen, web page, LibreNMS
    - RP2040 temperature renamed CPU temperature (MIB cpuTemperature, same OID)
    - Web page: with DHCP the Network card's boxes show the address, mask and
    gateway in use, and the DNS server below them
    - Factory reset button: "released after 0 ms" fixed; HIL test uses the
    community it set and reconnects after a reboot
    - Per-PC overrides via platformio.local*.ini (gitignored)
    [ambient_temp.cpp, ambient_temp.h, cli.cpp, cpu_temp.cpp, cpu_temp.h, device.py, factory_reset.cpp]
2026-10-31 Hardware: 3D-printable case, F1 is a 1 A SETfuse with LCSC part
    - Case: Fusion 360 design, STEP files for case and lid, 3MF print project
    - F1: SETfuse SCT1032 (T 1 A, LCSC C19712559) on the UMT 250 footprint,
    so JLCPCB can place it; fab files, renders and 3D models regenerated
    [Power Case - Lidt.step, Power Case - case.step, Power Case.3mf, Power Case.f3z, pico-poe-mains-carrier-bom.csv, pico-poe-mains-carrier-carrier-only.step, pico-poe-mains-carrier-headers.step, pico-poe-mains-carrier.kicad_pcb]
2026-10-31 CI: firmware build on Linux, no parentheses in a build flag
    sh rejected "(" in -D MEMP_NUM_SYS_TIMEOUT=(LWIP_NUM_SYS_TIMEOUT_INTERNAL+12),
    so the CI firmware build failed since 2.3.0. lwIP parenthesizes every use,
    and the timer pool is the same size (0x1d3 bytes).
2026-10-31 Release 2.5.0: ambient temperature, CPU temperature, LibreNMS logo, case
    - Ambient temperature from the carrier's TMP1075 (SNMP, status screen,
    web page, LibreNMS); RP2040 reading renamed CPU temperature
    - Web page: DHCP addresses in the Network card's boxes
    - LibreNMS: RF logo as device icon and device page logo
    - Hardware: 3D-printable case; F1 is a 1 A SETfuse with LCSC part
    - Fixed: factory reset "released after 0 ms"; CI firmware build on Linux
    [compose.yml, rfupsmonitor.yaml, version.h]
2026-10-31 Release 2.5.1: v2c traps carry snmpTrapAddress.0, traps in Docker LibreNMS
    - v2c traps end with snmpTrapAddress.0 (RFC 3584), the device's IPv4
    address, so a manager behind NAT can find the device; byte-exact tests
    against net-snmp, HIL decoder checks it
    - LibreNMS Docker setup: snmptrapd container (community-checked), the
    trap's own address for Docker Desktop's NAT, a sensor poll after mains
    traps so the alert opens and recovers in seconds
    - LibreNMS Docker setup: poller has the logo files (icon kept on polls)
2026-10-31 Carrier board: mains detection requirement 80 ms, HIL tests passed on it
    The carrier's detector holds a mains loss 30-50 ms to bridge the zero
    crossings, so the requirement is now 80 ms from mains changing to
    detection; the firmware's share (GPIO27 to detection) stays 10 ms.
    SNMP and trap HIL tests, including real mains cuts, passed on the
    carrier. The trap tests now skip with a clear message when UDP 162 is
    taken (LibreNMS snmptrapd) instead of failing and leaving COM4 open.
    [snmp_tools.py, test_main.cpp, test_snmp_traps.py]
2026-10-31 Traps to an IPv6 destination (v2c only)
    Menu option 4 accepts a global or ULA IPv6 address as the trap
    destination besides IPv4, "-" and "dhcp". parseTrapTarget() and
    formatTrapAddress() in lib/netconfig check and print it; the settings
    field grows to IPV6_TEXT_MAX and older files load unchanged. A v1
    Trap-PDU's agent-addr is IPv4, so trapVersionFitsTarget() refuses v1
    with a fixed IPv6 destination, in the menu and in the settings check.
    Tests: native netconfig and settings codec (incl. truncation,
    sanitizers), HIL menu refusals and a real v2c trap over IPv6.
    [cli.cpp, snmp_service.cpp, snmp_service.h, snmp_tools.py, test_ipv6.py, test_main.cpp]
2026-10-31 HIL: trap destination error message changed with IPv6 support
    test_snmp_settings_are_validated_and_cancel_keeps_them still expected
    "is not a valid IPv4 address"; since the IPv6 trap destination the menu
    says "not a valid IPv4 or IPv6 address". The failed assertion left the
    menu dialog open, so the rest of the suite failed too.
    [test_serial_menu.py]
2026-10-31 Hardware watchdog in every build, restart cause on the status screen
    The RP2040 watchdog (8 s) is armed at the end of setup(). Core 0 feeds
    it from loop() only while core 1's heartbeat keeps moving
    (CoreHeartbeatCheck, 1 s), so a hang on either core restarts the
    device. The restart cause (power-on, reset pin, reboot, watchdog) is
    read before diagBegin() can arm its own watchdog, and a record in RAM
    that survives resets counts watchdog restarts since power-on; both are
    in the boot log and on the status screen. The RFUPS_DIAG build no
    longer feeds the watchdog itself. Hidden menu commands stall0/stall1
    hang a core for the HIL test.
    Tests: native test_watchdog_logic (heartbeat incl. wrap, rest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
    [cli.cpp, device.py, diag.cpp, diag.h, main.cpp, test_main.cpp, test_watchdog.py, watchdog.cpp]
2026-10-31 Pin the PlatformIO platform to the tested commit
    platformio.ini pointed at the platform's git HEAD, so a fresh install
    or a CI cache miss would take Arduino-Pico 6.x with GCC 16, which
    changes stack use. Pinned to 24f5f5b: Arduino-Pico 5.4.3 (lwIP 2.2.1),
    GCC 14.2, the versions every release so far was built and tested with.
    Same core and toolchain as before; firmware build, all 20 on-device
    tests pass.
2026-10-31 Design: stateful DHCPv6 client (IA_NA) with its own test network
    Approved design for DHCPv6 address assignment: own client as a pure
    library (lwIP has only stateless DHCPv6), started by the router's M
    flag, DUID-LL from the MAC, hostname in option 39. The HIL test network
    is part of the work: unicast-only router advertisements to the device
    and a Kea server that answers only the device, so the LAN is not
    disturbed.
2026-10-31 HIL: DHCPv6 test network (unicast RA, Kea for the device only)
    In WSL (mirrored networking, root via wsl -u root): send_ra.py sends
    router advertisements only to the device's link-local address (M/O
    flags, router lifetime 0, no prefix); Kea drops every packet not sent
    from that address and gives addresses only to the device's DUID.
    Mirrored mode has no fe80::/64 route, so testnet.sh adds it while the
    test network runs and removes it at stop.
    test_dhcp6_testnet.py proves the path with the current firmware: an O
    flag makes lwIP's stateless client send an Information-request, Kea
    replies, and lwIP accepts it (new transaction id on the next RA).
    spike.pcap keeps that exchange for the native fix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
    [dhcp6_testnet.py, test_dhcp6_testnet.py]
2026-10-31 DHCPv6 fixtures captured from Kea, dhcpcd and the device
    capture.sh runs a private lab of WSL network namespaces: Kea 2.4.1 with
    one pool address, dhcpcd 10 with DUID-LL, send_ra.py with the M flag.
    extract.py writes test/native/dhcp6_frames/frames.h: dhcpcd's Solicit,
    Request and Renew, Kea's Advertise, Replies and an Advertise with
    NoAddrsAvail, router advertisements with and without M, and the device's
    own Information-request with Kea's reply from the HIL test network.
2026-10-31 dhcp6_client: frames and router advertisement flags
    dhcp6Frame wraps a client message for ff02::1:2 (Ethernet 33:33:00:01:00:02,
    hop limit 1, UDP 546 -> 547, checksum), so the firmware can send without
    lwIP's port 546. dhcp6FromFrame finds a server message for this MAC
    (UDP 547 -> 546, no extension headers, lengths and checksum checked);
    raRead reads M and O from router advertisements with hop limit 255 from
    a link-local source and a valid checksum. Headers and checksums match
    the device's and dhcpcd's captured frames.
2026-10-31 dhcp6_client: RFC 8415 client state machine for one IA_NA address
    Dhcp6Client solicits after a random delay up to 1 s, collects
    Advertises for the first RT (preference 255 at once), requests, binds
    and asks the caller to add the address; renews at T1 (half of preferred
    when 0), rebinds at T2 (80 %), removes the address at the end of the
    valid lifetime, and declines a duplicate. Retransmissions follow RFC
    8415 section 15 with the section 7.6 constants. A 64-bit clock extended
    from millis() keeps every timer wrap-safe and allows infinite
    lifetimes. dhcp6PickSlot never evicts an address.
    sanitize.sh: only test_* folders are suites (dhcp6_frames holds shared
    fixtures).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
    [test_main.cpp]
2026-10-31 DHCPv6 client in the firmware (frames via the netif hooks)
    src/dhcp6_service.cpp runs lib/dhcp6_client: the netif input hook reads
    router advertisements (an M flag starts the client) and DHCPv6 replies
    for this MAC into a one-entry inbox; dhcp6Poll() feeds the client,
    sends its messages as complete frames from the link-local address
    (netStatsSendFrame, around lwIP's port 546), adds the leased address
    in a free slot (never evicting one) with its lifetimes for lwIP's
    duplicate address detection, refreshes them after a Renew, declines a
    duplicate and removes the address when the lease ends. The status
    screen marks the address "(dhcpv6)".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
2026-10-31 DHCPv6 address on the status screen and web page
    Status screen: "DHCPv6: off (no router asked for it)", or the client
    state, the leased address with its remaining valid lifetime and the
    message counters, plus why a leased address is not in use (no free
    slot). Web page: an "IPv6 (DHCPv6)" row with the address and its valid
    lifetime; the DHCPv6 address stays out of the "IPv6 address" row.
2026-11-01 DHCPv6: follow lwIP's slot state, no renew loop on deprecated leases
    - Refresh or remove the address only while lwIP's slot still holds it
    (lwIP expires addresses itself, SLAAC may reuse the slot); otherwise
    add it again through duplicate address detection
    - A renewed deprecated address is preferred again
    - The lease expires at its valid end in every state, also while
    requesting again after NoBinding
    - Preferred lifetime 0 with T1/T2 0: renew from the valid lifetime
    instead of at once
    - Prefer an address that is not deprecated when a Reply lists several
2026-11-01 DHCPv6: keep a moved-away address until its valid end; highest free slot and lifetimes kept against RAs
    - The server moving us to another address deprecates the old one, which
    is removed at the end of its valid lifetime (RFC 8415 18.2.10.1)
    - The DHCPv6 address takes the highest free lwIP slot: lwIP gives an RA's
    lifetimes to the first non-static address in the prefix, and SLAAC
    takes the first free slot
    - Once a second the service sets lwIP's lifetimes and state back to the
    client's, in case an RA overwrote them anyway
2026-11-01 Web page: show why DHCPv6 has no address (no free IPv6 slot)
2026-11-01 Docs: DHCPv6 Confirm, moved addresses, SOL_MAX_RT, slot choice
2026-11-01 power_monitor: MainsAlarm, raised after 60 s of lost mains
2026-11-01 LibreNMS: alert only on mains outages over 60 s (mainsPowerAlarm sensor)
2026-11-01 lwIP SO_REUSE=1 instead of dropping TIME-WAIT entries on port 80
    The web server's socket already asks for SOF_REUSEADDR; with SO_REUSE lwIP
    honours it, so the firmware no longer walks lwIP's private TIME-WAIT list.
    New HIL test creates real TIME-WAIT entries (logins) and fails without
    either; the old test passed without the workaround. The DHCP hook part of
    the TODO item is dropped with the reason.
    [test_web.py, web_service.cpp]
2026-11-01 LLDP design; ignore secret/ (local switch login)
2026-11-01 if_stats test: a VLAN frame, not LLDP, as the unknown protocol example
2026-11-01 LibreNMS: neighbour from the device's LLDP-MIB
2026-11-01 HIL watchdog test: time the core 1 restart by SNMP silence, not the USB drop
    Windows sometimes reports the USB drop 2 s after the chip restarted, so
    the core 1 stall test measured 9.1 or 11.1 s against an 11 s limit and
    failed now and then. The device restarts after 9.1 s every time: core 0
    keeps answering SNMP until the restart. The test now asks every 50 ms and
    takes the silence as the restart time (limit 9.5 s); a firmware with a
    3 s stale time fails it (11.1 s). Core 0 still uses the USB drop.
    [snmp_tools.py, test_watchdog.py]
2026-11-01 Design: rename to RF.Power-Monitor, docs and diagrams up to date
2026-11-01 Plan: rename to RF.Power-Monitor
2026-11-01 Rename firmware and libraries to RF.Power-Monitor
    Display name RF.Power-Monitor (menu, boot banner, sysDescr, web page,
    mDNS service), default hostname rf-power-monitor (settings default and
    fallback), lwIP hook rfpowerIPv6Gateway, diag build flag RFPOWER_DIAG.
    Stored settings keep their name (test_stored_old_default_name_is_kept).
2026-11-01 Rename the MIB and LibreNMS definition to RF.Power-Monitor
    RF-UPS-MONITOR-MIB -> RF-POWER-MONITOR-MIB (rfUpsMonitor... -> rfPowerMonitor...,
    same OIDs, new REVISION; description says v1 and v2c), LibreNMS OS
    rfupsmonitor -> rfpowermonitor (files, sysDescr regex, logos, compose
    mounts, trap script). HIL name checks follow the firmware rename.
2026-11-01 Carrier board generator: RF.Power-Monitor title and silkscreen
    Regeneration and ERC/DRC follow when KiCad has the project closed.
2026-11-01 Diagrams: RF.Power-Monitor, LLDP, watchdog, DHCPv6, mains alarm
    Titles renamed; firmware architecture gains dhcp6_service, lldp_service,
    hostname/ipv6_static, watchdog and lib/dhcp6_client, lldp,
    watchdog_logic; system overview LLDP and the watchdog; SNMP flow the
    LLDP-MIB and 67 objects; mains flow the 60 s alarm, trap and LibreNMS
    sensor; test layers the LLDP/watchdog HIL and current counts; network
    addresses DHCPv6 and IPv6 trap destinations.
2026-11-01 test_dhcp_option: the captured frames predate the rename
2026-11-01 RF.Power-Monitor 3.0.0: docs
    Name in every doc (repository URLs kept), status screen sample with
    the mains alarm, switch and DHCPv6 lines, sysDescr example 3.0.0,
    CHANGELOG 3.0.0 with an 'Updating from 2.x' list, TODO entry.
2026-11-01 Review fixes: old MIB trap names, LibreNMS 3.0 update steps, version
    - Trap script accepts RF-UPS-MONITOR-MIB names again (snmptrapd keeps the
    old MIB until restarted); check_trap_names.php covers every form
    (3 old-MIB forms failed before the fix).
    - LIBRENMS.md: steps to remove the rfupsmonitor files when updating to
    3.0.0; the old-MIB trap names described correctly.
    - README current version 3.0.0; CHANGELOG links for 2.6.0, 2.7.0, 3.0.0.
2026-11-01 Name RF-Power-Monitor (hyphen) instead of RF.Power-Monitor
    The user's choice: the display name now matches the other forms
    (rf-power-monitor, RF-POWER-MONITOR-MIB). Firmware texts, mDNS service
    instance (no dot any more), LibreNMS text and sysDescr regex, MIB, HIL
    and native tests, docs.
2026-11-01 Carrier board regenerated: RF-Power-Monitor title and silkscreen
    Regenerated by the user (generator, KiCad files, fab outputs, 3D models,
    images); ERC 0 and DRC 0 incl. schematic parity, BOM unchanged.
    [pico-poe-mains-carrier-carrier-only.step, pico-poe-mains-carrier-headers.step, pico-poe-mains-carrier.kicad_pcb, pico-poe-mains-carrier.kicad_sch, pico-poe-mains-carrier.step]
2026-11-01 Docs and diagrams checked against the code
    A section-by-section audit against the code: access log (also web
    logins, only the newest entry folds repeats), web timeouts and response
    codes, mains alarm on the web page, walk counts without a neighbour
    (50/58), project structure (lib/lldp, lldp_service), TESTING.md test
    descriptions and counts (moved misplaced SNMP bullets, added
    test_mains_alarm, test_watchdog_logic, missing HIL tests), TODO and
    CLAUDE.md details. Diagrams: watchdog and CPU temperature on core 0;
    web login checks the password before the lock (as the code does),
    /logout and failed saves; settings_codec only serializes.
    [make_diagrams.py, test_snmp.py]
2026-11-01 Manuals: LibreNMS screenshots
    Device page, Add Device, alert rules, Neighbours and event log from the
    test LibreNMS (no community or user names visible).
2026-11-02 HIL: no link and no DHCP server states via the switch port
    test_switch_port.py (opt-in RFPOWER_SWITCH_CONFIG) disables the device's
    switch port, or drops DHCP on it with a port filter, over the Junos console
    and checks the status screen and the recovery without a reboot. The port is
    the one the device names over LLDP and the switch lists its MAC on.
    switch_console.configure() edits under configure exclusive, refuses a
    candidate with someone else's uncommitted changes, and uses commit confirmed
    so the switch undoes a change a crashed test could not.
    [switch_console.py, test_switch_port.py]
2026-11-02 Links to the renamed repository RF-Power-Monitor
2026-11-02 Serial output: end every line with CR LF
    Lines printed with a bare LF (most of the status screen, boot and event
    messages) staircased across the screen in PuTTY, which does not add the
    CR itself. HIL test test_menu_and_status_end_lines_with_crlf checks the
    menu and the status screen.
2026-11-02 LibreNMS: Switch box on the device Overview (plugin)
    A LibreNMS plugin (librenms/plugins/RFPowerMonitor, optional, copied to
    app/Plugins/) adds a Switch box to the Overview page of RF-Power-Monitor
    devices: the switch, port and system description the device sees over
    LLDP, from the same links as the Neighbours tab, or "No switch seen".
    The Docker test setup mounts it. Docs and the overview screenshot updated.
    Checked with LibreNMS 26.10.2.
2026-11-02 Web page: sysContact and sysLocation
    The Device name card sets hostname, sysContact and sysLocation in one save
    (POST /hostname, backend saveDeviceName). WEB_BODY_MAX 9856 -> 11264: the
    longest page is now 10857 bytes. RAM 46.5 % (121944 bytes).
2026-11-02 SNMP agent: MIB lookup returns resolved instances
    mibGet/mibGetNext (MibView V1/V2c) return the instance with its value, each
    getter called once; mibFind/mibNext are internal; mibSize is uint16_t for a
    MIB of more than 255 objects. No change on the wire. RAM 46.8 % (122556).
    [test_main.cpp]
2026-11-02 cpu_load: one-minute busy average for both cores
    CpuLoad averages busy time per second over the last minute (hrProcessorLoad,
    RFC 2790); LoopLoad derives core 0's busy time from loop passes longer than
    the shortest pass of the last minute. Wrap-safe, no allocation.
    [test_main.cpp]
2026-11-02 HOST-RESOURCES-MIB and ENTITY-MIB: CPU load, RAM, LittleFS, inventory
    hrProcessorLoad for both cores (one-minute average), hrStorageTable for RAM
    and LittleFS, hrMemorySize, hrSystem, hrDeviceTable; one entPhysicalTable
    row with model, revisions, manufacturer and the flash unique ID as serial.
    Core 0's load now compares passes per second with the busiest idle second:
    idle passes vary from 58 to 150 us, so comparing each pass with the shortest
    read 20 % on an idle device; now 0 % idle, 87 % under SNMP and web load.
    Status screen shows CPU load, RAM and LittleFS use and the serial number.
    RAM 46.9 % (123036 bytes).
    [cli.cpp, device.py, host_stats.cpp, host_stats.h, main.cpp, snmp_service.cpp, test_host_resources.py]
2026-11-02 MIB-II ip/icmp/tcp/udp counters and IP-MIB address tables
    lwIP's MIB2_STATS counters are switched on in include/lwipopts.h, which
    loads the core's options with #include_next and overrides LWIP_STATS (the
    core sets it to 0 without #ifndef); only the mib2 block costs RAM (196 B).
    The ip, icmp, tcp and udp scalars serve them; tcpCurrEstab counts lwIP's
    connections like lwIP's own agent.
    ipAddrTable and ipAddressTable are dynamic columns: their rows are built
    from the interface's addresses at each request, so walks stay correct while
    DHCP, SLAAC or DHCPv6 change them. RAM 47.3 % (124028 bytes).
    [lwipopts.h, net_stats.cpp, net_stats.h, snmp_service.cpp, test_ipv6.py, test_main.cpp, test_snmp.py]
2026-11-02 Review leftovers: trusted rate limit, reassembly size, web form, tests
    - Rate limit: unknown sources are back to 50/s with bursts of 100; a source
    that used the right community gets 200/s with bursts of 400 (topped up when
    it earns trust, lost with it), so walks run at full speed, also back to
    back. All trusted sources together stay within 200/s. HIL: untrusted limit
    measured with wrong-community packets after revoking trust; two trusted
    walks in a row.
    - ipAdEntReasmMaxSize is what lwIP reassembles (10 x 1480 + 20 = 14820), not
    65535.
    - Web: a form without contact/location (page from 3.0.0) keeps them.
    - mibGetNext walks the sorted table forward instead of searching again.
    - Tes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
    [net_stats.cpp, snmp_service.cpp, snmp_service.h, test_main.cpp, test_snmp.py]
2026-11-02 CHANGELOG: restore the 3.1.0 summary line
    A PowerShell variable ate "Standard" and the blank line after the heading.
2026-11-02 Default hostname RF-Power-<last 6 MAC hex digits> (3.2.0)
    The hostname, SNMP sysName, DHCP and mDNS name default to RF-Power- and the
    last three MAC bytes (RF-Power-4EA22C), so devices on one LAN no longer share
    rf-power-monitor. An empty sysName or the old default counts as not set
    (new devices, factory reset, devices updated from older firmware); '-' in
    menu option 4 goes back to it.
    The MAC is known only after Ethernet starts, while DHCP is discovering.
    The core's setHostname() calls dhcp_renew(), which then stopped DHCP from
    getting a lease; without a lease the name is now set on the netif directly
    and goes out with the next DHCP message.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
    [cli.cpp, hostname.cpp, hostname.h, main.cpp, snmp_service.cpp, test_factory_reset.py, test_main.cpp, test_serial_menu.py]
2026-11-02 Docs: diagrams and user manual for 3.1.0 and 3.2.0
    Diagrams: host_stats and cpu_load in the architecture, the trusted rate
    limit and the 3.1.0 MIBs in the SNMP flow, core 0's load in the overview,
    test counts (92 net-snmp checks, ~670 native tests). User manual: the new
    status lines and what LibreNMS shows since 3.1.0.
2026-11-02 Docs: LibreNMS screenshots for firmware 3.2.0
    Device overview (processors, memory, storage, serial, location; contact
    replaced by a placeholder), event log, neighbours, and a new inventory shot.
2026-11-02 LibreNMS test setup: database in the same time zone as LibreNMS
    LibreNMS stores last_polled in local time (TZ Europe/Copenhagen) and the
    dispatcher compares it with the database's NOW(). With MariaDB on UTC every
    device looked polled an hour in the future, so it was polled about once an
    hour instead of every 5 minutes. Recreating only the db container keeps
    the data volume.
2026-11-03 Hardware: rev 2 board (RP2040 + W5500 on one board), designed, not built
    hardware/rf-power-monitor-rev2: KiCad 10 project designed with Adom AI Flow.
    Everything from the W5500-EVB-Pico-PoE except the PoE stage is on the board
    (RP2040, 2 MB flash, W5500, magnetics, RJ45, TLV62569 buck, USB-C); PoE stays
    the plug-in WIZPoE-P1. Rev 1 mains detector, TMP1075 and factory reset with
    the same pins, so the firmware is unchanged. JLCPCB Gerbers, BOM and CPL,
    GLB and zipped STEP, renders, datasheet, calculations and bring-up tests.
    ERC 0, DRC 0 errors. AI Flow's working files stay out of git.
    README for the board; README, CLAUDE.md, setup manual, CHANGELOG and TODO
    (section 19: review, order, bring-u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
    [bom.csv, rf-power-monitor-rev2-bom.csv, rf-power-monitor-rev2.kicad_pcb, rf-power-monitor-rev2.kicad_sch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]
2026-11-05 Hardware rev2: U5 flash W25Q16JVSNIQ to match its SOIC-8 pads
    The BOM listed W25Q16JVSSIQ (LCSC C131025), Winbond's 208 mil SOIC-8,
    but U5's footprint is the 150 mil SOIC-8 (3.9 x 4.9 mm), so JLCPCB
    assembly refused the part. W25Q16JVSNIQ (LCSC C2456211) is the same
    16 Mbit QSPI flash in the 150 mil package.
    Fixed in design/netlist.py (and its netlist.json and bom.csv), U5's
    value, MPN and LCSC fields in the schematic and board, the datasheet,
    and the regenerated out/fab files. No footprint or copper change.
    [bom.csv, rf-power-monitor-rev2-bom.csv, rf-power-monitor-rev2.kicad_pcb, rf-power-monitor-rev2.kicad_sch]
2026-11-05 Design and plan: firmware update over the web page (A/B slots, signed, rollback)
2026-11-05 Build: firmware linked per slot behind our own boot program
    The firmware is now linked at slot A (flash 0x10010100) by a generated
    linker script (scripts/slot_build.py, from the core's memmap_default.ld
    without boot2, OTA loader and partition block) and started by our own
    minimal boot program at flash 0 (boot/, built by scripts/build_boot.py
    with the core's toolchain). Upload and pio test send firmware_full.uf2:
    boot program, erased boot record and the slot A image. [env:pico_b]
    builds the same firmware for slot B (0xE7000); FW_SLOT tells the code
    which slot it is.
2026-11-05 fw_image: slot header and Ed25519 verification (Monocypher)
2026-11-05 fw_update: out-of-range record is no record; pin fallback behaviour
2026-11-05 Boot program: verify slots, pick by boot record and crash count
    The boot program now sets clk_sys to 125 MHz, reads the newest boot record,
    verifies the target slot (Ed25519, key from include/fw_key.h) and the other
    slot only when the decision needs it (bootSelect), writes the boot info,
    crash counter and verification time to watchdog scratch 0-2, arms the
    watchdog (~8.3 s) and starts the slot. Nothing bootable, or a fault in the
    boot program: LED 3 short / 1 long, watchdog off.
    Firmware: the restart cause comes from the boot info (the armed watchdog
    made the SDK's reset reason say "watchdog" for every reboot), setup()
    takes over and feeds the watchdog, and prints "Boot: slot A verified in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
    [boot_clocks.cpp, boot_clocks.h, boot_info.cpp, boot_info.h, boot_led.cpp, boot_led.h, boot_main.cpp]
2026-11-05 Boot program: fault restarts via watchdog, stop inherited watchdog
    - A fault in the boot program shows the LED pattern for ~3 s, then the
    watchdog restarts the chip (was: halt until a power cycle). Only
    "nothing bootable" keeps the watchdog off.
    - The boot program stops a watchdog inherited from the firmware right
    after reading the reset reason, so it cannot fire during verification.
    - slot_build.py warns when slot A passes 550 KB (verification ~2.6 us/byte
    nears the 1.5 s budget); TODO.md item.
    - HIL test_fw_update: names match the menu reboot; planned-restart check
    is its own test.
    [boot_main.cpp, test_fw_update.py]
2026-11-06 web_ui: Firmware page, streaming upload request; fw_update: trial monitor
    TrialMonitor (confirmed by a valid request, unreachable after 10 min of
    network or 60 min), HttpRequest streaming mode for one POST path, the
    Firmware page, /firmware/switch, /firmware/status, authorizeUpload() and
    uploadResult(). The Firmware page has its own CSP for its upload script.
    web_service.cpp gets stub firmware()/switchSlot() until the update service.
2026-11-06 web_ui, fw_update: fix upload head parsing with binary prefix, trial net time, CSP hash, logging
    - HttpRequest: NUL check only over the head (a binary body prefix in the
    same read no longer gives 400); NUL in a buffered body is Bad however
    it arrives.
    - TrialMonitor: an interval counts as network time only if the network
    was up at both polls.
    - Firmware page CSP: script-src by SHA-256 hash instead of unsafe-inline.
    - Refused uploads (401/403) are logged (WebEvent/AccessEvent::WebUploadRefused).
    - uploadResult: only 200 is success; firmwareStatus text built in _body.
    [snmp_service.cpp, test_main.cpp, web_service.cpp]
2026-11-06 Firmware update service: upload to the inactive slot, trial, rollback
    src/fw_update_service.cpp wires lib/fw_update into the firmware:
    - boot record: read at boot, rewritten in setup() right after a fallback
    (rolled back / fallback (crash), trap pending), to the copy that is not
    the newest with sequence + 1
    - trial: TrialMonitor fed by valid SNMP requests and authenticated web
    requests (WebApp::authenticated()); confirmed -> kept, record written,
    crash counter cleared; unreachable -> record back to the old slot,
    planned reboot
    - crash counter (scratch1) cleared after FW_HEALTHY_MS of uptime
    - uploads: POST /firmware/upload streams into UpdateReceiver (allocated
    only during an upl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
    [boot_info.cpp, boot_info.h, fw_update_service.cpp, fw_update_service.h, main.cpp, snmp_service.cpp, test_main.cpp, test_watchdog.py]
2026-11-06 Firmware update service: trial crash count, net-ready rule, pure record plans
    - On trial the crash count is no longer cleared after FW_HEALTHY_MS; only
    a confirmation clears it. A trial firmware that hangs a few minutes
    after every boot now reaches the crash limit and is rolled back
    (fwShouldClearCrashCount, lib/fw_update trial_monitor).
    - netReady for the trial = link up and an IPv4 address or a non-link-local
    IPv6 address (fwTrialNetReady); link-local is always there and would
    count time while DHCP/SLAAC have failed.
    - Which boot record is written after a fallback, a confirmed or given-up
    trial, an upload or a switch, the trap flag clear, and "settled" are
    pure functions in l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
    [fw_update_service.cpp, fw_update_service.h, main.cpp, test_main.cpp, web_service.cpp]
2026-11-06 SNMP fwUpdate group (63050.7) and firmwareUpdateKept / firmwareRolledBack traps
    Five read-only objects (running slot, both slot versions, trial state, last
    result), two traps (v1 specific 4 and 5, v2c 63050.0.4 and .0.5) sent once the
    boot record's pending trap can leave (trapCanLeave), MIB file, docs, LibreNMS
    state sensors "Firmware" and "Firmware last update", and the trap script polls
    on the new traps. Trap bytes and the walk are checked against net-snmp.
2026-11-06 Firmware status lines on the serial screen and tools/fw_update.py
    Status screen: Firmware, Other slot, Last update, Firmware key. fw_update.py
    logs in, checks the .upd key id against the device key, uploads, waits for the
    restart and polls until the new firmware is kept; one result line per host.
    Tests run against a fake device in a thread.
2026-11-06 HIL tests: signed update, rollback, fallback, switch and PoE cycles (opt-in RFPOWER_FW_UPDATE_TEST)
2026-11-06 Firmware update: wrong key is its own upload error (403 different key); safer PoE and teardown in the HIL update tests
    [fw_update_service.cpp, fw_update_service.h, test_fw_update.py, test_main.cpp, web_service.cpp]
2026-11-06 Release 3.3.0: signed A/B firmware updates, documentation, default_envs = pico
    Version 3.3.0. User manual (Firmware page, trial/kept/rolled back, fw_update.py,
    rejected uploads, busy device, mains detection late during an upload, USB install:
    only -usb.uf2 / firmware_full.uf2), setup manual (key generation and backup, field
    builds, first USB flash), LibreNMS (fwUpdate sensors, firmware traps, snmptrapd
    restart, LF for .php), TESTING, README, CLAUDE.md, TODO and CHANGELOG (breaking
    note: new flash layout, first install needs USB). CI uploads firmware_full.uf2.
    platformio.ini: default_envs = pico, so a bare pio run/test does not build pico_b.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
2026-11-06 Firmware update review fixes: forget rolled-back releases, page-sized flash writes, fw_update.py outcomes
    - I1: after a rollback (crash or unreachable) the running firmware erases the
    failed slot's header at start-up (fwRecordForgetOther decides, the service
    erases), so a later crash-loop fallback or a switch never reaches a release
    that failed. A verified upload whose record write fails is erased too.
    - I2: UpdateReceiver programs 256-byte pages and holds only the slot header
    page for finish(): 632 bytes, static again (no heap, no 503 path). Sector 0
    is still erased first and its header page written last.
    - I3: fw_update.py reports "updated" only once running_slot changed, the sta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
    [fw_update.py, fw_update_service.cpp, fw_update_service.h, snmp_service.cpp, test_fw_update.py, test_main.cpp]
2026-11-06 Docs for the review fixes: rolled-back releases are erased, fw_update.py outcomes, measured RAM
    User manual, spec, TESTING and CHANGELOG describe that a rolled-back release
    is erased from the other slot (so a fallback reaches only the previous kept
    release), the new fw_update.py lines, refusals answered after the body, and
    the RAM figures measured after the page-sized receiver (static 48.8 %,
    128,044 bytes; an upload allocates nothing). TESTING says how the 50 % rule
    is measured. Native test for a slot header version other than 1.
    [test_main.cpp]
2026-11-06 Design: update server with device check-in, chosen updates and a shared key
2026-11-06 Plan: update server, device check-in and chosen firmware updates
2026-11-06 update_client: check-in wire format and keyed BLAKE2b MACs
    Device (lib/update_client/update_protocol) and site (update-server/rfupdate/protocol.py)
    build and check the same format, tested against shared vectors from Python hashlib.
2026-11-06 dhcp_option: read DHCP option 225 (update server URL, text)
    Captured device requests have room to ask for both 224 and 225.
2026-11-06 Update server settings: URL, URL from DHCP and shared key in their own A/B files
    The main settings file stays as it is (near its 1024-byte limit, which older
    firmware enforces too). A factory reset removes both copies, so the key does
    not stay in flash. Work buffers are on the heap only during a load or save.
    [factory_reset.cpp, main.cpp, test_main.cpp]
2026-11-06 Update service: check-ins with the update server, downloads into the A/B update path
    An authenticated reply confirms a firmware on trial; a download is checked
    against the version the reply named, then goes through the existing signature
    check and trial. Failures are reported at the next check-in. DHCP option 225
    is requested and read beside 224. Hidden menu command checkin for tests.
    [cli.cpp, fw_update_service.cpp, fw_update_service.h, main.cpp, net_stats.cpp, net_stats.h, test_main.cpp, update_service.cpp]
2026-11-06 Update site pages, admin login and Docker packaging
    Device list without login; upload, assign and the shared key behind a
    login (password from RFUPDATE_ADMIN_PASSWORD, 5 failures a minute lock
    it, CSRF tokens on every form). Device-reported text is escaped. Runs in
    Docker on port 8071 with a named volume; site tests run in CI.
    [compose.yml, test_web.py]
2026-11-06 3.4.0; signed slot version must match the release the site named; fw_release.py --test-version
    The .upd file header is not signed. The device now also compares the
    version in the signed slot header with the one the site's reply named, and
    the site refuses an upload whose slot headers hold another version.
2026-11-06 Review fixes: update service cannot get stuck; forced check-in survives a save; device-side 3.4.0 floor
    - the one HTTP fetch is shared safely: fetchtest is refused while a check-in
    or download runs, and a fetch taken away ends the phase instead of stalling it
    - downloads have a deadline (2 min + 2 KB/s of their length)
    - a forced check-in (hidden command) is no longer cancelled by a settings
    save or the network coming up in the same loop pass
    - releases older than 3.4.0 are refused on the device too
    - the site refuses to share its port (SO_REUSEADDR let an old copy answer)
    - HIL: rebuild stale test releases, stop the site's process tree, DHCP
    one-spare-byte boundary test
    Co-Authored-B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
    [cli.cpp, device.py, http_fetch.cpp, http_fetch.h, test_main.cpp, test_update_server.py, test_web.py, update_service.cpp]
2026-11-06 Fix the review's minor findings
    - device: a release with another signed version is refused before the other
    slot is touched (receiver checks the expected version before erasing)
    - device: saving update server settings ends a running check-in
    - device: the status word of an unauthenticated error reply keeps [a-z0-9-] only
    - device: key copies wiped (JSON hex, settings work buffer, web request after
    the answer); a complete fetch closes with FIN, not RST; URL parsed only when
    it changes
    - site: nonces kept 400 days; dead 'downloading' state removed; silent
    clients dropped after 30 s; session state locked; assign counts known devices
    - docs: factory reset on firmware older than 3.4.0 doe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
    [fw_update_service.cpp, fw_update_service.h, http_fetch.cpp, test_main.cpp, test_update_server.py, test_web.py]
2026-11-06 Update site: RF logo in the top bar, on the login page and as favicon
    The same logo as the device's web page; a test keeps the two equal.
2026-11-06 Diagrams for the update site
    New update-site-flow (check-in, reply MAC, download, checks before writing,
    trial, reporting); system overview, firmware architecture, test layers and
    settings storage show the update site, update_client/update_service, the
    site tests and the update settings files.
2026-11-06 bench_info: the device data block for the bench tool
2026-11-06 Bench tool: device info, lock and release UF2 check
2026-11-06 Bench tool: 40 x 40 mm label image
2026-11-06 Bench tool: device log
2026-11-06 Bench tool: flash, lock, label and log a board in one run
2026-11-06 Review fixes: password and lock load without Ethernet, lost report survives reboots, bench tool error handling
    [bench_device.py, bench_provision.py, main.cpp, test_bench.py, test_main.cpp, web_service.cpp, web_service.h]
2026-11-06 HIL: tests that change option 10 put the device's update server back
    The update server tests in test_serial_menu.py and test_update_server.py
    left the device with no update server, wiping a real URL and key. They now
    restore the setting; since the device never shows its key, a set key is
    restored from RFPOWER_UPDATE_KEY, and without it the tests are skipped.
    [device.py, test_serial_menu.py, test_update_server.py]
2026-11-07 Bench update server default; the review's small items
    - secret/bench.ini ([update] url, key): the bench tool sets option 10 and
    keeps it with the new hidden command updatedefault; a factory reset
    restores it instead of turning check-ins off (data/update_default_*.json)
    - benchinfo reports the default (never the key) and runs on the heap:
    static RAM back to 49.6 %
    - Two valid password copies that differ while locked (option 7 of
    firmware before 3.5.0) count as lost
    - Bench tool: verifies the release signature (fwsign verify), checks
    devices.csv is writable and refuses two new ports or an unsafe hostname
    before touching the board
    - HIL: unlock test skips on a labelled board; factor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
    [bench_device.py, bench_log.py, bench_provision.py, cli.cpp, factory_reset.cpp, test_bench.py]
2026-11-07 Docs: device label, password lock and bench update server in the user and setup manuals
2026-11-07 LibreNMS: firmware state "normal", rollbacks critical
    The Firmware sensor shows normal instead of kept for a confirmed
    firmware (fwState 1). A rollback or fallback in Firmware last update
    is critical, so the State Sensor Critical rule alerts until the next
    successful update.
2026-11-07 Web: refused uploads without a login drain within 20 s
    An upload refused with 401/403 is still read and dropped so the client
    sees the answer, but StreamBody::drainOnly gives it 20 s (no pause over
    5 s) instead of the 5-minute upload deadline, so one client without a
    login can no longer hold the single web connection.
    [test_main.cpp, test_web.py, web_service.cpp]
2026-11-07 Boot: own SHA-512 for the slot signature check (921 ms for 430 KB)
    lib/fw_image fw_sha512: eight rounds unrolled, sigma functions on 32-bit
    halves, whole blocks read as words; 1.59 instead of 2.01 us per byte on
    the M0+. slotVerify hashes R || A || M with it and calls Monocypher's
    reduce and equation check, so signatures and files are unchanged. The
    hash state is off the stack before the equation check. slot_build.py
    warns from 700 KB (budget 1.5 s lasts to ~740 KB).
2026-11-07 Syslog: RFC 5424 messages, event queue and throttle
2026-11-07 Syslog: events to a syslog server
    Mains, boot, firmware result, web logins and access log, settings from the
    web page and the serial menu, link, DHCP address, LLDP switch port and
    update-site check-ins. Queued until there is a server and the time.
2026-11-07 SNMP: update-site group, LibreNMS sensors
    updCheckinResult, updMinutesSinceGood, updFailedInRow (63050.8);
    LibreNMS warns after 60 minutes without a good check-in.
2026-11-07 Docs, LibreNMS syslog receiver, on-device Ethernet test links with SNTP
    The LibreNMS test setup gets a syslog-ng sidecar with an RFC 5424
    source on UDP 5140. test_ethernet provides timeServiceSetTime, which
    lwIP's SNTP now calls (src/ is not built for on-device tests).
2026-11-07 Review fixes: full syslog queue keeps its events, dhcp NTP forgets a typed server, DHCPv6 NTP is option 31
    [syslog_service.cpp, test_main.cpp, test_time_syslog.py, time_service.cpp, time_service.h, version.h]
2026-11-07 Small fixes: update-site minutes after a server change, per-kind access counts, link-local servers refused, web fields need a value, option 11 origin, stale option 7, clock read, DHCPv6 NTP asked aga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
    - CheckinStats (lib/update_client, native tests): the updateSite minutes count from a
    server change, not from boot, so LibreNMS does not warn falsely after a change
    - SyslogThrottle counts refused SNMP and web access events apart (MSGID SNMP / WEB)
    - fe80::/10 refused for the NTP and syslog servers (no zone)
    - The web card refuses an empty field instead of silently keeping the value
    - Option 11's settings event says "serial menu:" or "web page:"
    - A switched DHCP option 7 request forgets the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
    [cli.cpp, net_stats.cpp, syslog_service.cpp, syslog_service.h, test_dhcp6_testnet.py, test_main.cpp, test_time_syslog.py, time_service.cpp]
2026-11-07 Docs: README moved into docs/, all docs and diagrams up to date with 3.6.0
    - README.md down to an overview, quick start and a docs table; the rest moved
    to docs/USER_MANUAL.md (menu, web page, troubleshooting), new
    docs/REFERENCE.md, docs/HARDWARE.md and docs/DEVELOPMENT.md, the bench
    setup to docs/SETUP_MANUAL.md and the SNMP summary to docs/MIB.md
    - Docs checked against the code: walk and object counts, status screen and
    web paths, firmware/update-site sensors, 3.6.0 features
    - Diagrams: arrow labels beside their lines, straight arrows, a layout check
    in make_diagrams.py; content updated (NTP, syslog, DHCP 7/42, DHCPv6 31,
    new libraries); five new diagrams: firmware update and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
2026-11-07 Rev 2 board ordered (2026-11-07)
2026-11-07 Screenshots for 3.6.0: web page and LibreNMS, new syslog tab
    docs/images/web/screenshots.ps1 retakes the web page pictures from a device
    and replaces addresses, MAC, contact, location and community by
    documentation values; the LibreNMS script also takes the syslog tab.
2026-11-08 Mains soak test: random mains cuts for days, checked over SNMP, with an HTML report
    test/hil/mains_soak.py cuts mains through the Dirigera outlet at random lengths
    (blip to 30 minutes) for 7 days by default and checks each outage: loss and restore
    seen, the 60 s alarm, the change counter, no restart; SNMP and web answers between
    cuts. Writes events.csv, soak.log, summary.txt and report.html in soak/ (gitignored).
    Cut plan, checks and report tested in test/tools/test_mains_soak.py.
2026-11-08 Release 3.6.1: NTP server from DHCPv6 option 31 also on M-flag networks
    The device's own DHCPv6 address client asks for option 31 (SNTP servers,
    RFC 4075) and hands the servers from its Reply to lwIP's SNTP through
    dhcp6_set_ntp_servers(), as lwIP's stateless client does for the O flag.
    Up to two global/ULA addresses; link-local, multicast, loopback and
    unspecified skipped; a wrongly sized option is ignored without losing
    the lease; a Renew reply without it keeps the servers. Switching NTP to
    dhcp hands them over again.
    Tests: native test_dhcp6_message and test_dhcp6_client (failed first),
    sanitizers; HIL test_dhcp6.py option 31 with the M flag only (failed on
    3.6.0, passes on 3.6.1), test_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
    [dhcp6_service.cpp, dhcp6_service.h, test_dhcp6.py, test_main.cpp, time_service.cpp, version.h]
2026-11-08 Code scanning: wipe the update key copy with crypto_wipe, read-only CI token
    CodeQL cpp/memset-may-be-deleted (update_service.cpp): the undo copy of the
    update settings holds the shared key; memset before it goes out of scope may
    be optimised away, crypto_wipe cannot (as cli.cpp and update_settings.cpp do).
    CodeQL actions/missing-workflow-permissions: tests.yml gets contents: read.
    [update_service.cpp]
2026-11-12 Fuzz the parsers of network and flash input with libFuzzer
    One harness per parser in test/fuzz, built and run by scripts/fuzz.sh
    with clang, ASan and UBSan (WSL): SNMP/BER, the web page's HTTP parser
    and pages (also logged in), the firmware update receiver, slot header
    and boot record, DHCP, DHCPv6 with the client, LLDP, update site
    replies, the settings files and typed menu/form input.
    The harnesses make checksums and the update site MAC valid so the
    fuzzer reaches the code behind them, and check the parsers' promises
    besides memory safety (no flash write outside the slot, settings load
    back as saved, well-formed SNMP responses, printable LLDP text).
    Seeds come from test/fuzz/make_seeds.py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
2026-11-12 Serial menu input into the pure library lib/cli_input
    The line editor (printable ASCII only, CR LF as one line end, backspace,
    a too-long line refused whole, passwords and keys echoed as '*') and the
    input rules of each prompt (Enter keeps, '-' clears, dhcp/none, IPv4 and
    IPv6 addresses, hostname, trap destination and version, update URL)
    move out of src/cli.cpp, which keeps the state machine and the serial
    port. The messages are unchanged.
    57 native tests (checked to fail with the CR LF skip and the overflow
    wipe removed), the sanitizer suite and a fuzz harness. HIL
    test_serial_menu.py passes on the device (option 10 tests skipped: no
    update key without Docker). A too-long line is now wipe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
    [cli.cpp, test_main.cpp]
2026-11-12 TODO: stay on Arduino-Pico 5.4.3, not 6.1.0
    A trial build of 6.1.0 compiled unchanged (RAM -1.2 KB, image -34 KB)
    but lost SNMP requests on the device: back-to-back requests over IPv6
    (1 of 4 answered) and snmpwalk/bulkwalk timeouts in ipAddrTable, while
    5.4.3 passes the same HIL suites on the same network. Core 0 used 380
    bytes more stack. Look again only if the core's UdpContext is fixed.
2026-11-12 TODO: UdpContext bug reported as arduino-pico#3617
    Reported with a minimal sketch: on 5.4.3 an IPv6 build with default
    options hangs on 4 queued IPv4 datagrams; LWIP_IPV6_FRAG=0 echoes all
    24 of 24. LWIP_IPV6_FRAG can go back on once a pinned core has the fix.
2026-11-13 TODO: arduino-pico#3617 fixed upstream by #3618, waiting for a release
